svilches/666_Thesis/60 Presentation/SergioVilchesMScThesis.pptx

## Compact OCT scanner for a bimodal endoscopic probe

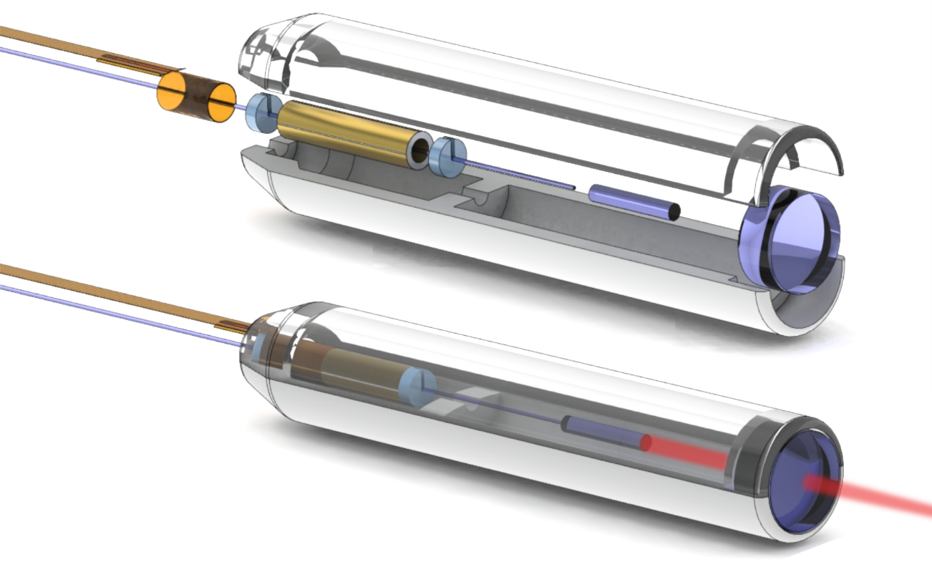
[picture p4: figure]

Sergio Vilches

Notes: Motivation: multimodal probe

## Slide 2

Sergio Vilches

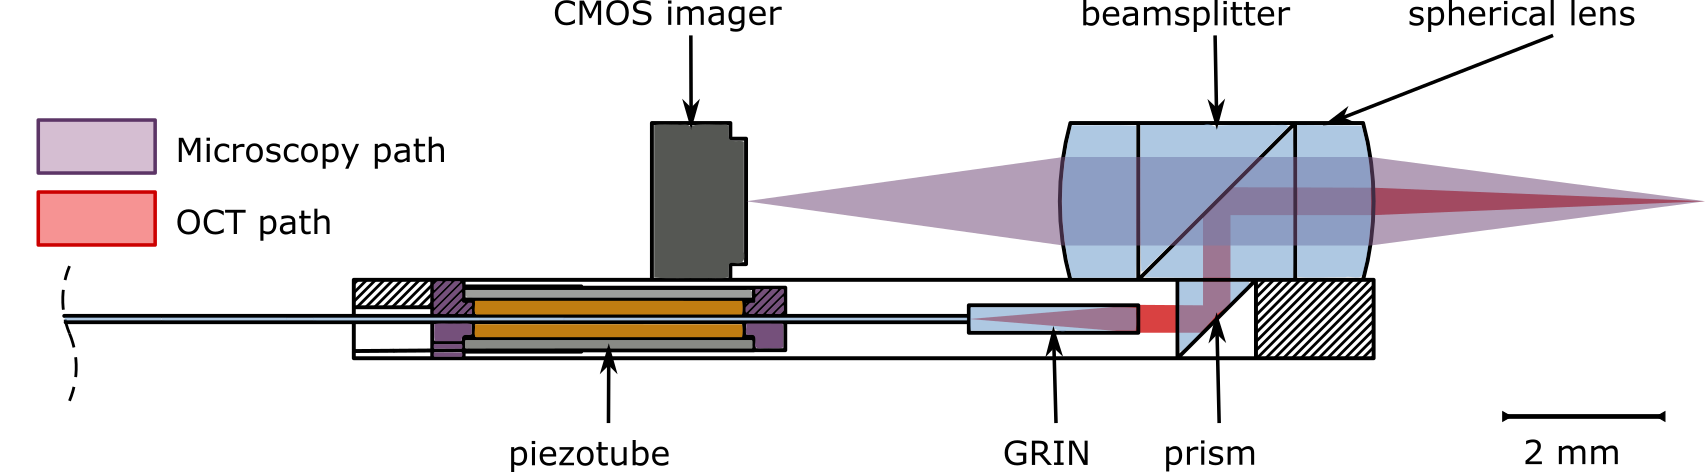
[picture p5: figure]

## Slide 3

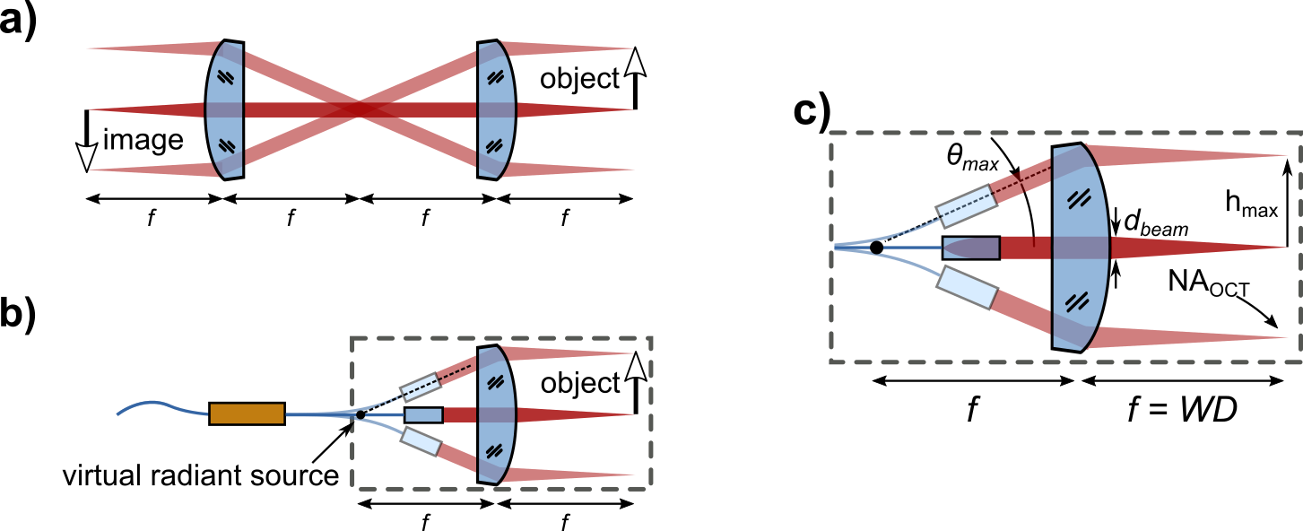
[picture p6: figure]

## Slide 4

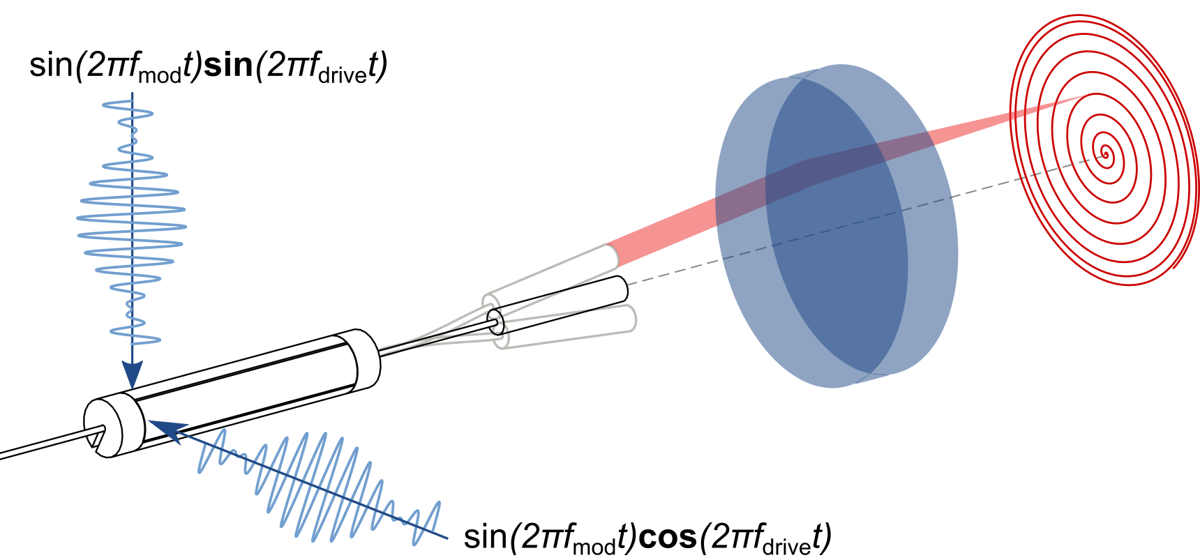
[picture p7: figure]

## Slide 5

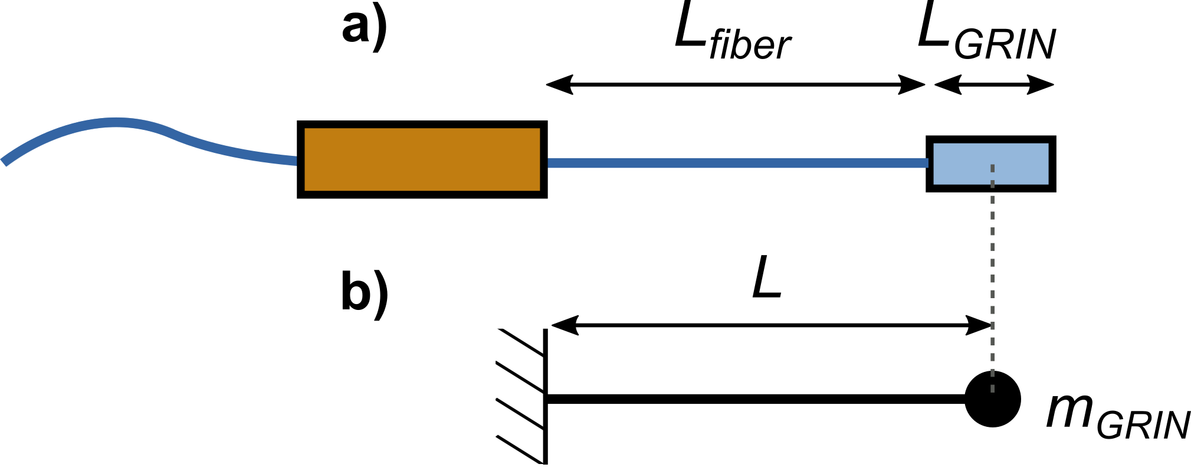
[picture p8: figure]
