svilches/666_Thesis/10 LaTeX/figures/20_Theory/Optical/SDOCT-Schema.pdf

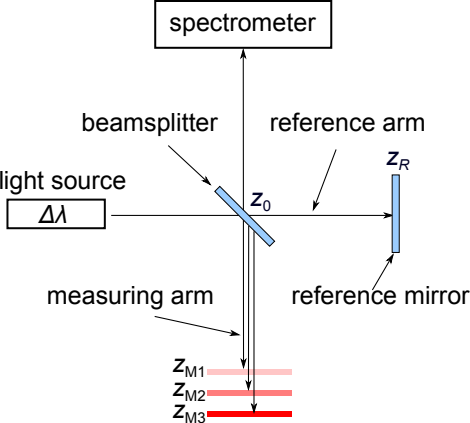
[picture p80: figure]
light source; beamsplitter; reference mirror; spectrometer; measuring arm; reference arm
