svilches/666_Thesis/10 LaTeX/figures/20_Theory/Optical/SSOCT-Schema.pdf

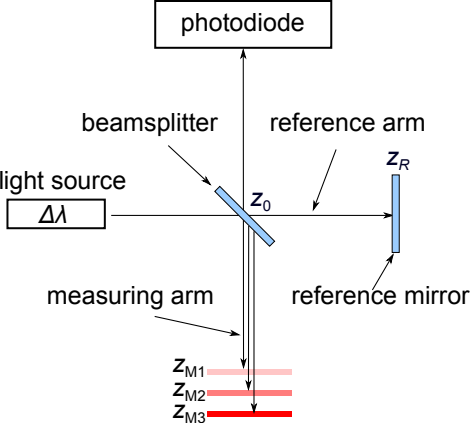
[picture p81: figure]
light source; beamsplitter; reference mirror; photodiode; measuring arm; reference arm
