svilches/666_Thesis/10 LaTeX/appendix/comsol.pdf

# COMSOL Simulation

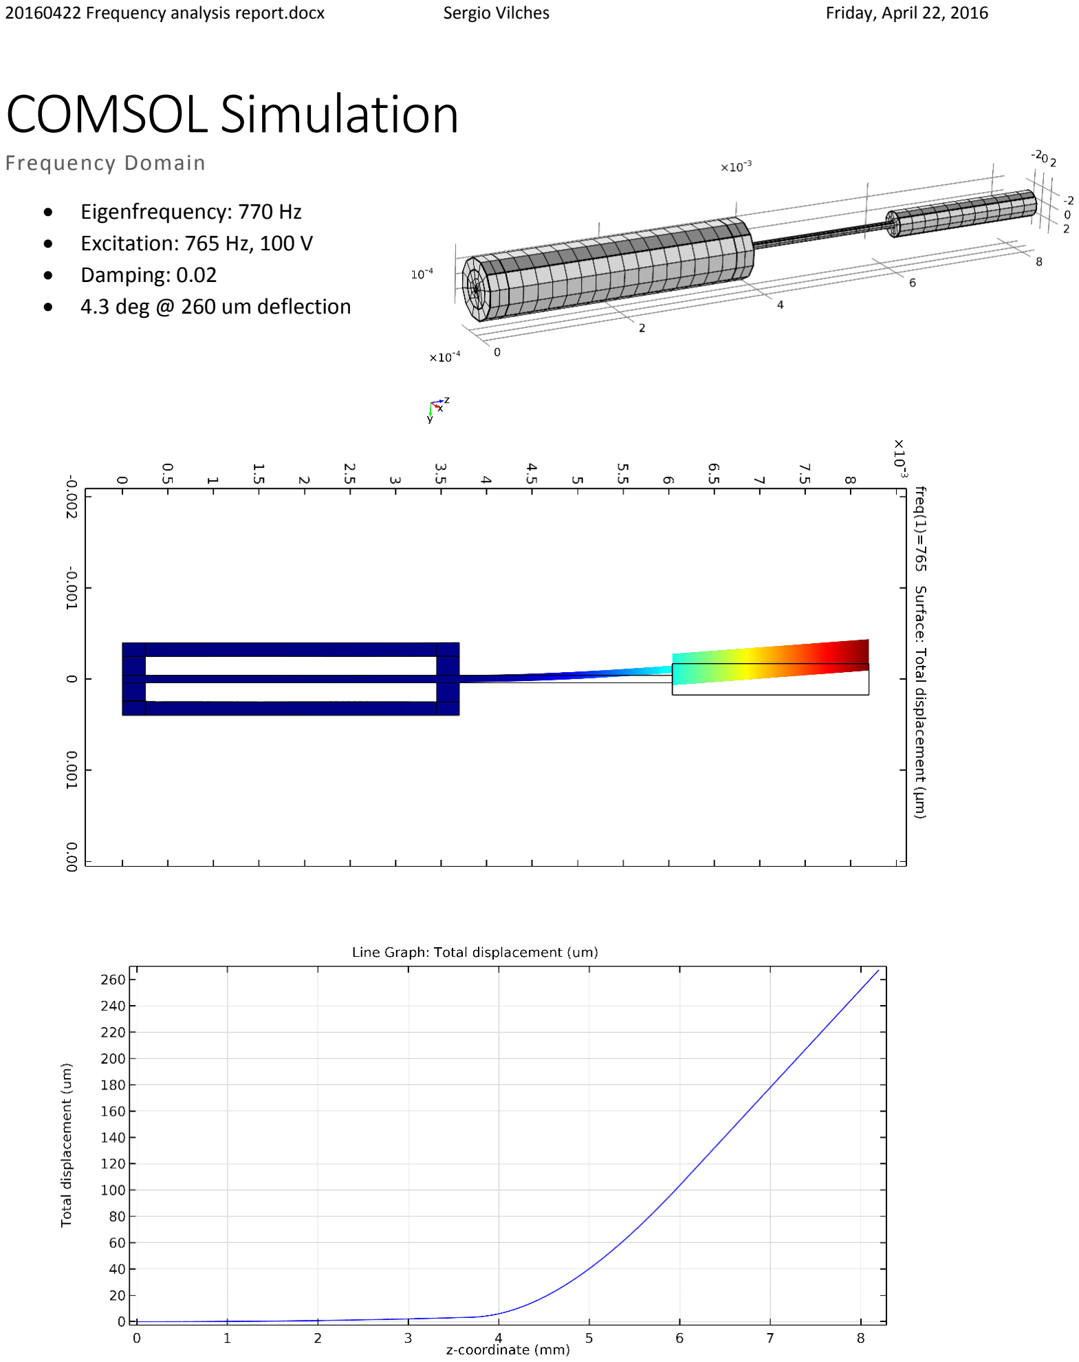
[picture p82: page 1]

20160422 Frequency analysis report.docx | Sergio Vilches | Friday, April 22, 2016

Frequency Domain

- Eigenfrequency: 770 Hz
- Excitation: 765 Hz, 100 V
- Damping: 0.02
- 4.3 deg @ 260 um deflection
