svilches/666_Thesis/10 LaTeX/appendix/holder.pdf

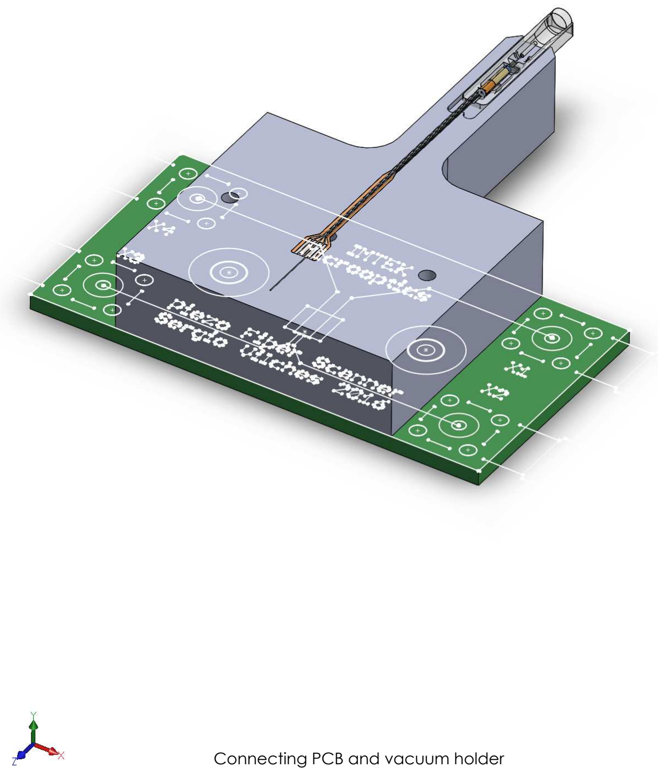
[picture p83: page 1]

Connecting PCB and vacuum holder
