svilches/666_Thesis/10 LaTeX/appendix/pztPhotos.pdf

2016603 PZT Tube Metrology.docx | Sergio Vilches | June 3, 2016

# PZT Tube Metrology

PI Ceramics, full sample

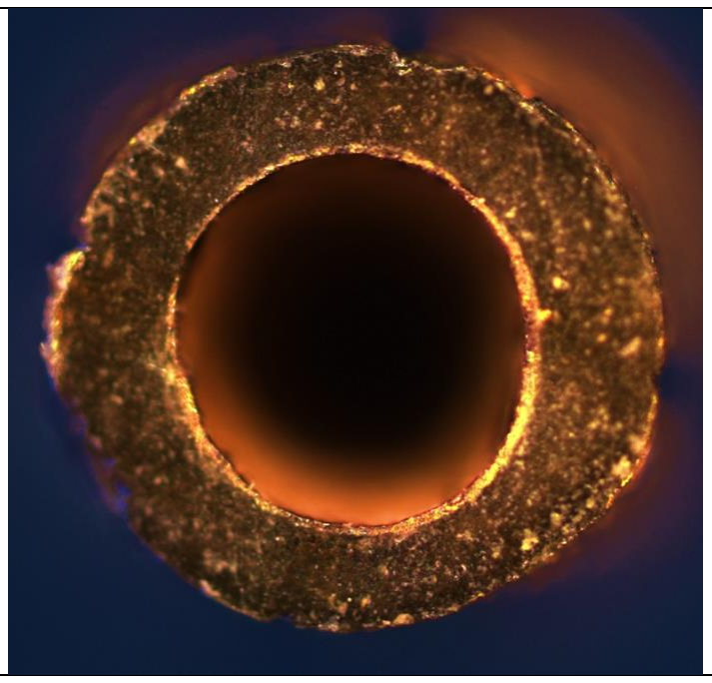
[picture p84: figure]
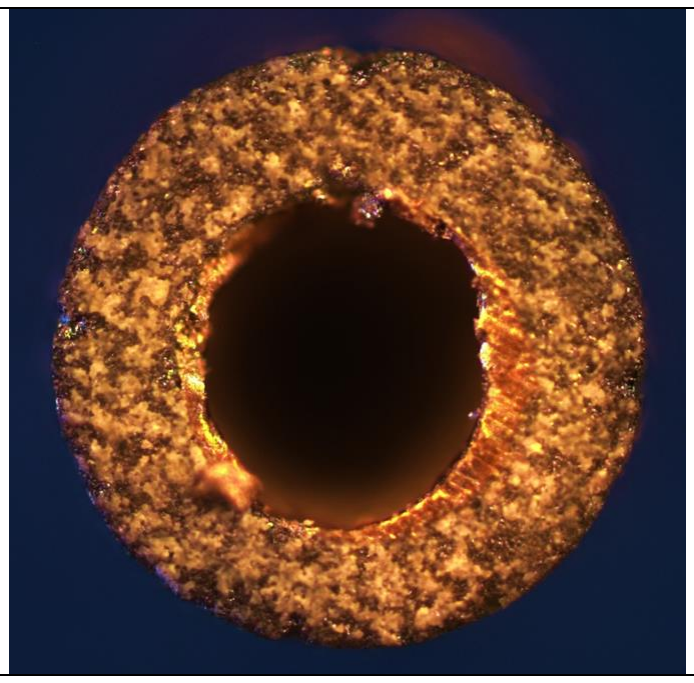
[picture p85: figure]

PZT1, Side A | PZT1, Side B

### Manufacturer Drawing

PZT #

Side A [um] | Side B [um]
L [mm]
| d | D | d | D
1 | 452 | 792 | 396 | 784 | 3,74
2 | 474 | 776 | 440 | 814 | 3,78
3 | 466 | 776 | 438 | 772 | 3,78
4 | 464 | 774 | 392 | 786 | 3,76
5 | 476 | 766 | 410 | 780 | 3,75
Min | 452 | 766 | 392 | 772 | 3,74
Average | 466 | 777 | 415 | 787 | 3,76
Max | 476 | 792 | 440 | 814 | 3,78
StdDev | 10 | 9 | 23 | 16 | 0,02

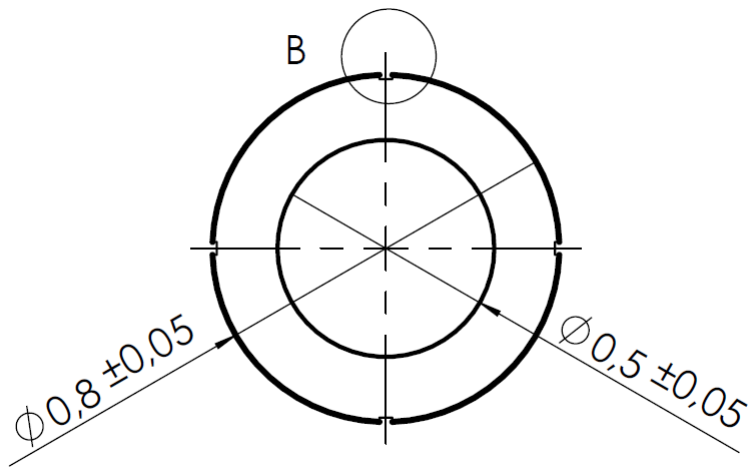
[picture p86: figure]
