svilches/666_Thesis/70 Paper/comparisonSeibel.xlsx

Parameter | Seibel, Lurie | Ours
Resonance frequency [Hz] | 2046 | 762
Output diameter of scanning engine [mm] | 1.07 | 0.91
Cantilever length [mm] | 6.8 | 4.5
Scanning engine length [mm] | 13.2 | 9
Total length [mm] | 24.6 | 15
fov [mm] | 1.1 | 1.2
ksampling @ 1 mm FOV [points/mm] | 15.6 | 41.3
dx @ center [um] | 10 | 48
dx @ 1 mm FOV [um] | 128 | 48
fps | 12.5 | 10
