svilches/666_Thesis/10 LaTeX/MScThesis Sergio Vilches.tex

% -*- encoding: UTF8 -*-
%
%%%%%%%%%%%%%%%%%%%%%%%%%%%%%%%%%%%%%%%%%%%%%%%%%%%%%%%%%%                                                                                                             %%
%%      Sergio Vilches Master Thesis 2017			  %%%%                                                                                                                                                       %%
%%%%%%%%%%%%%%%%%%%%%%%%%%%%%%%%%%%%%%%%%%%%%%%%%%%%%%%%%%

% NOMENCLATURE:
% beamsplitter
% backreflection
% multimodal
% single modality
% proximal = fiber side
% collimate
% beam path
% piezoelectric tube
% full field microscopy   (endomicroscopy = microscopy beam path)
% resonant fiber scanner 
% Fourier plane scanner
% 3D-printed housing
% SS-OCT

% Read the basic settings
%\input{document_parts/default_settings}
\input{parts/DefaultSettings}

%\renewcommand{\rmdefault}{phv} % Arial
%\renewcommand{\sfdefault}{phv} % Arial
%\renewcommand\refname{{\fontfamily{phv}\selectfont Publications}} 

%% List for splitting words
%\hyphenation{Donau-dampf-schiff-ka-pi-tän}

% Load other packages
\input{parts/PersonalSettings}                

\begin{document} 

%% First Part: Title, Professor,...
\input{parts/FirstPages}     

% Short English and German Abstracts
\input{parts/Abstracts}  

% Includes contents into bookmarks
\cleardoublepage\phantomsection\pdfbookmark{\contentsname}{toc}

% Print table of contents
\tableofcontents

% Load Term Declaration
\input{parts/Nomenclature} 

% *** Set a spreadsheet- and figure-list
          %\listoffigures
          %\listoftables       % the option liststotoc includes the spreadsheet- and figure-list in the TOC

%%%%%%%%%%%%%%%%%%%%%%%%%%%%%%%%%%%%%%%%%%%%%%%%%%%%%%%%%%%%%%%%%%%%%%%%%%%%%%%%%
%                                                                 Main document	                      																				
%%%%%%%%%%%%%%%%%%%%%%%%%%%%%%%%%%%%%%%%%%%%%%%%%%%%%%%%%%%%%%%%%%%%%%%%%%%%%%%%%

% Start of the main part
\mainmatter   

%% Load separate chapters (for faster compiling just uncomment chapters)

\input{chapters/10_Introduction}

\input{chapters/20_Theory}

\input{chapters/30_DesignSimulation}

\input{chapters/40_Fabrication}

\input{chapters/50_Measurements}

\input{chapters/60_Conclusion}

%%%%%%%%%%%%%%%%%%%%%%%%%%%%%%%%%%%%%%%%%%%%%%%%%%%%%%%%%%%%%%%%%%%%%%%%%%%%%%%%%
%                                                                 Appendix	                      																				
%%%%%%%%%%%%%%%%%%%%%%%%%%%%%%%%%%%%%%%%%%%%%%%%%%%%%%%%%%%%%%%%%%%%%%%%%%%%%%%%%

% *** Load Appendix
\appendix
\input{parts/Appendix}

%% Include Bibliography
\cleardoublepage\phantomsection\pdfbookmark{\bibname}{bib}

\bibliographystyle{ieeetr}
\bibliography{refs} %ieeetr

% Thanksgiving
\input{parts/NoteOfThanks}

\end{document}

%%% You're done! %%%%%%%%%%%
