svilches/666_Thesis/20 Templates/Draft_Bachelor-Masterthesis_LATEX_english/chapters/Theory.tex

% -*- encoding: UTF8 -*-
%%*****************************************************************************
%%									                    	Theoretical Basics								 
%%*****************************************************************************
%
%
\chapter{Theory}
\label{Ch:Theory}	
%
%%%%%%%%%%%%%%%%%%%%%%%%%%%%%%%%%%%%%%%%%%%%%%%%%%%%%%%%%%%%%%%%%%%%%%%%%%%%%%%%%%
%
%---------------------------------Introduction----------------------------------
Within this Chapter the most important optical basics will be discussed...
%

%%%%%%%%%%%%%%%%%%%%%%%%%%%%%%%%%%%%%%%%%%%%%%%%%%%%%%%%%%%%%%%%%%%%%%%%%%%%%%%%%%
%
\section{Optics}
%
%
%%%%%%%%%%%%%%%%%%%%%%%%%%%%%%%%%%%%%%%%%%%%%%%%%%%%%%%%%%%%%%%%%%%%%%%%%%%%%%%%%%
%
%-------------------------Optical Devices-----------------------------
\subsection{Optical Devices}

%
For the detection of the light intensity ...
