svilches/666_Thesis/10 LaTeX/figures/30_DesignSimulation/Optical/backreflection.pdf

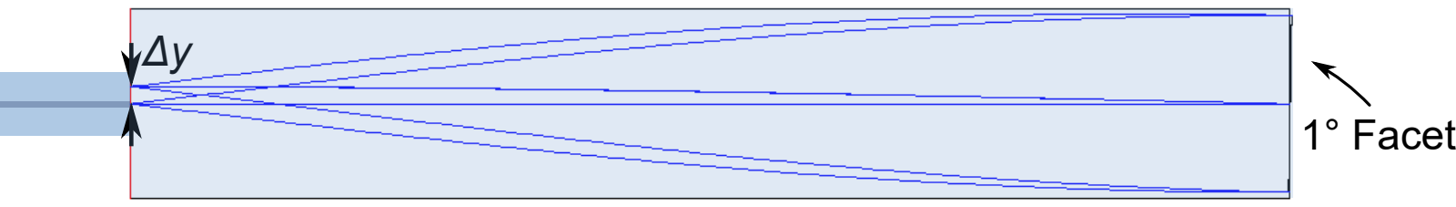
[picture p88: page 1]

Δ

y

1° Facet
