svilches/666_Thesis/10 LaTeX/figures/30_DesignSimulation/Mechanical/fres.pdf

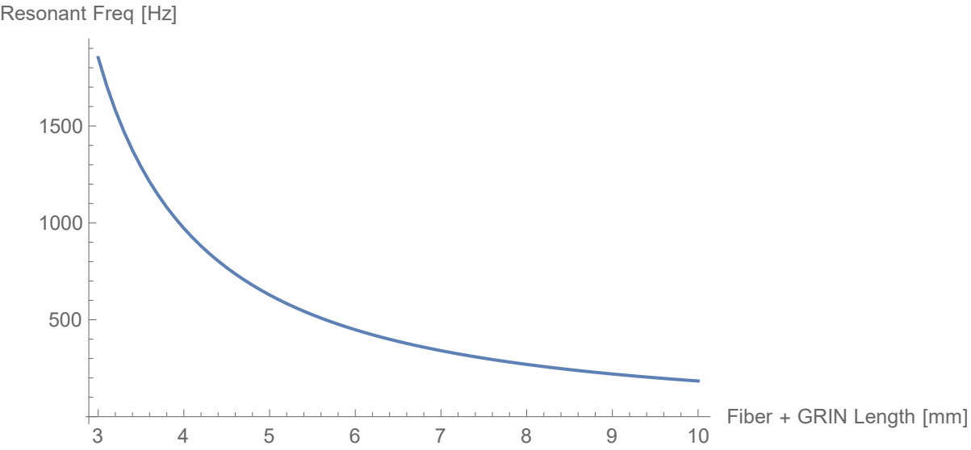
[picture p89: figure]
Fiber + GRIN Length [mm]; Resonant Freq [Hz]
