svilches/666_Thesis/10 LaTeX/figures/30_DesignSimulation/Overview/BimodalBenchDoubleLens.pdf

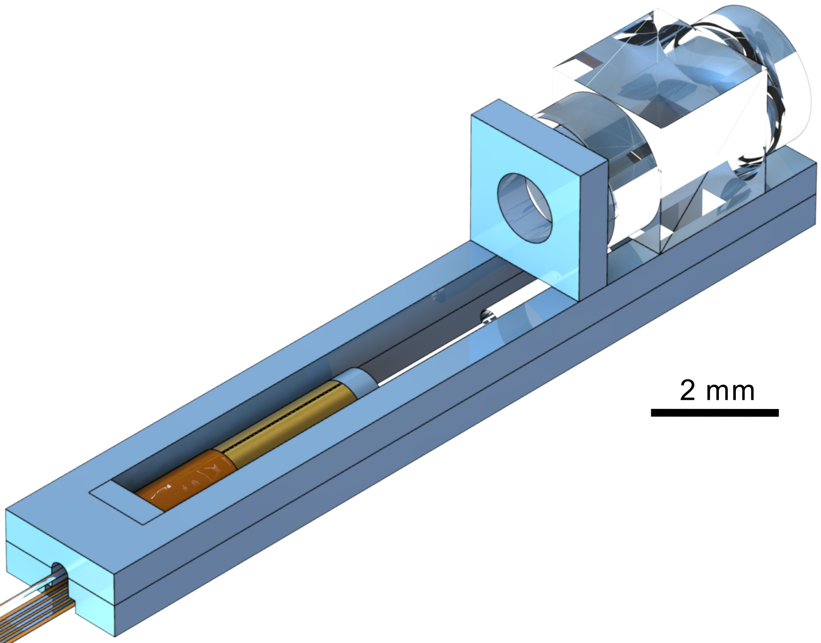
[picture p90: page 1]
