svilches/666_Thesis/10 LaTeX/figures/30_DesignSimulation/Optical/beamsplitter3D.pdf

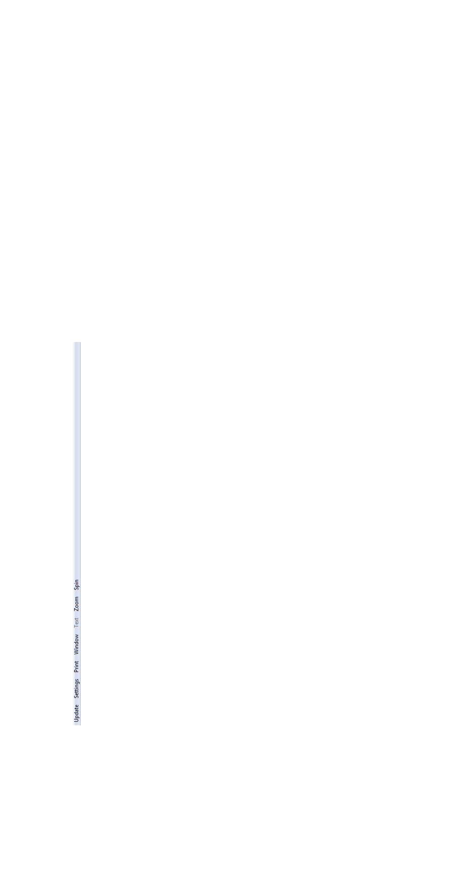
[picture p91: page 1]
