svilches/666_Thesis/10 LaTeX/figures/20_Theory/Optical/imaging/GaussianMTF.pdf

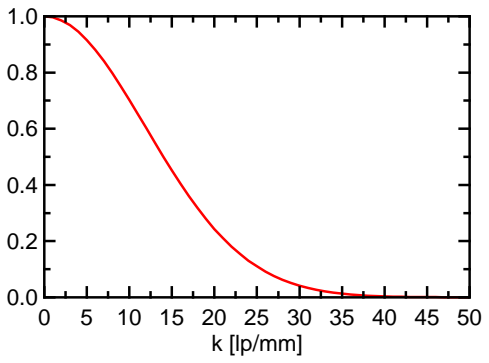
[picture p92: figure]

### MTFcore
