svilches/666_Thesis/10 LaTeX/figures/20_Theory/Optical/imaging/GaussianPSF.pdf

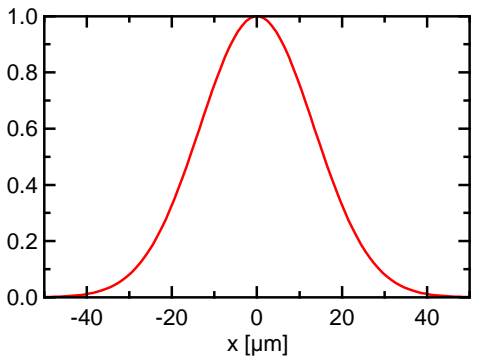
[picture p93: figure]

### PSFcore
