svilches/666_Thesis/10 LaTeX/figures/20_Theory/Optical/imaging/MTFcomplete.pdf

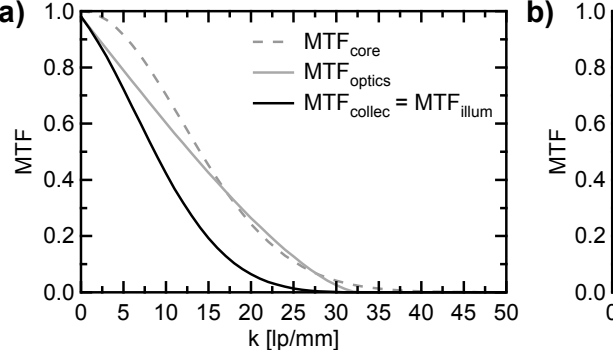
[picture p94: figure]
MTF; MTFcore; MTFoptics; MTFcollec = MTFillum
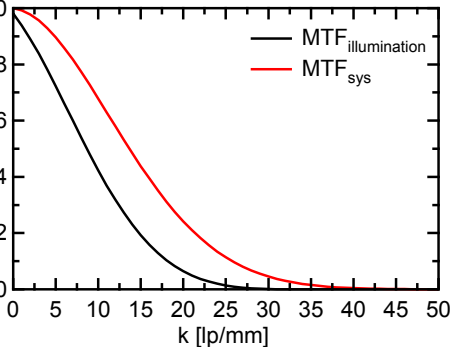
[picture p95: figure]
MTFillumination MTFsys
