svilches/666_Thesis/10 LaTeX/figures/20_Theory/Optical/imaging/MTFcoreoptics.pdf

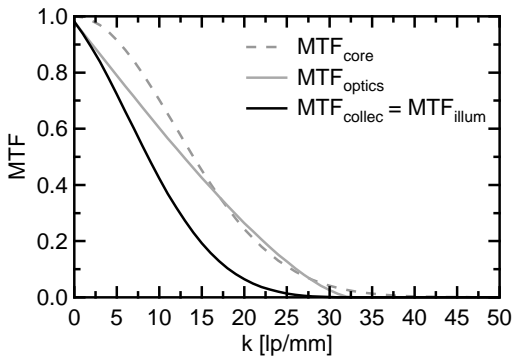
[picture p96: figure]
MTF; MTFcore; MTFoptics; MTFcollec = MTFillum
