svilches/666_Thesis/10 LaTeX/figures/20_Theory/Optical/imaging/MTFsystem.pdf

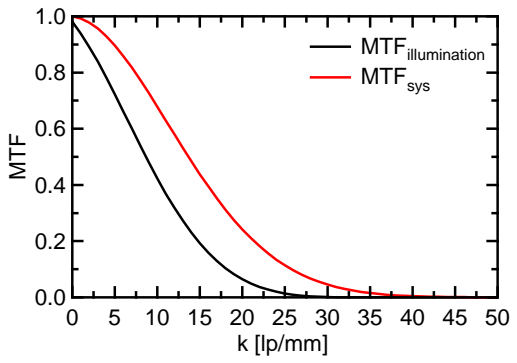
[picture p97: figure]
MTF; MTFillumination MTFsys
