svilches/666_Thesis/10 LaTeX/figures/20_Theory/Optical/imaging/PSF_MTF.pdf

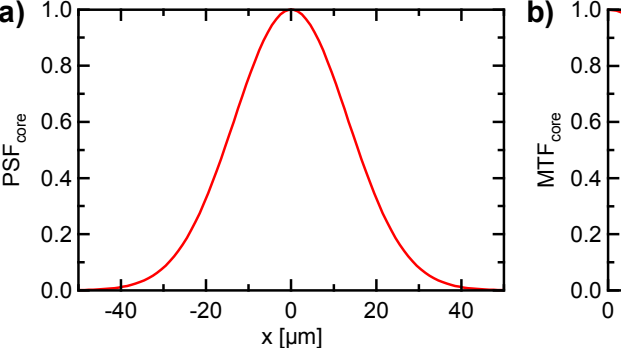
[picture p98: figure]
PSFcore; MTFcore
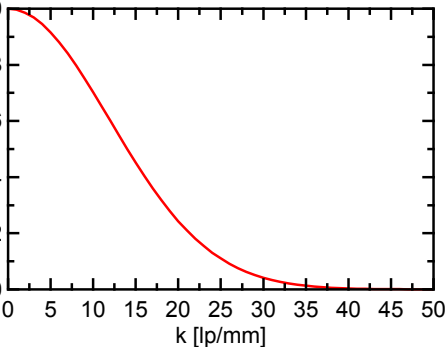
[picture p99: figure]
