svilches/666_Thesis/10 LaTeX/appendix/KOH.pdf

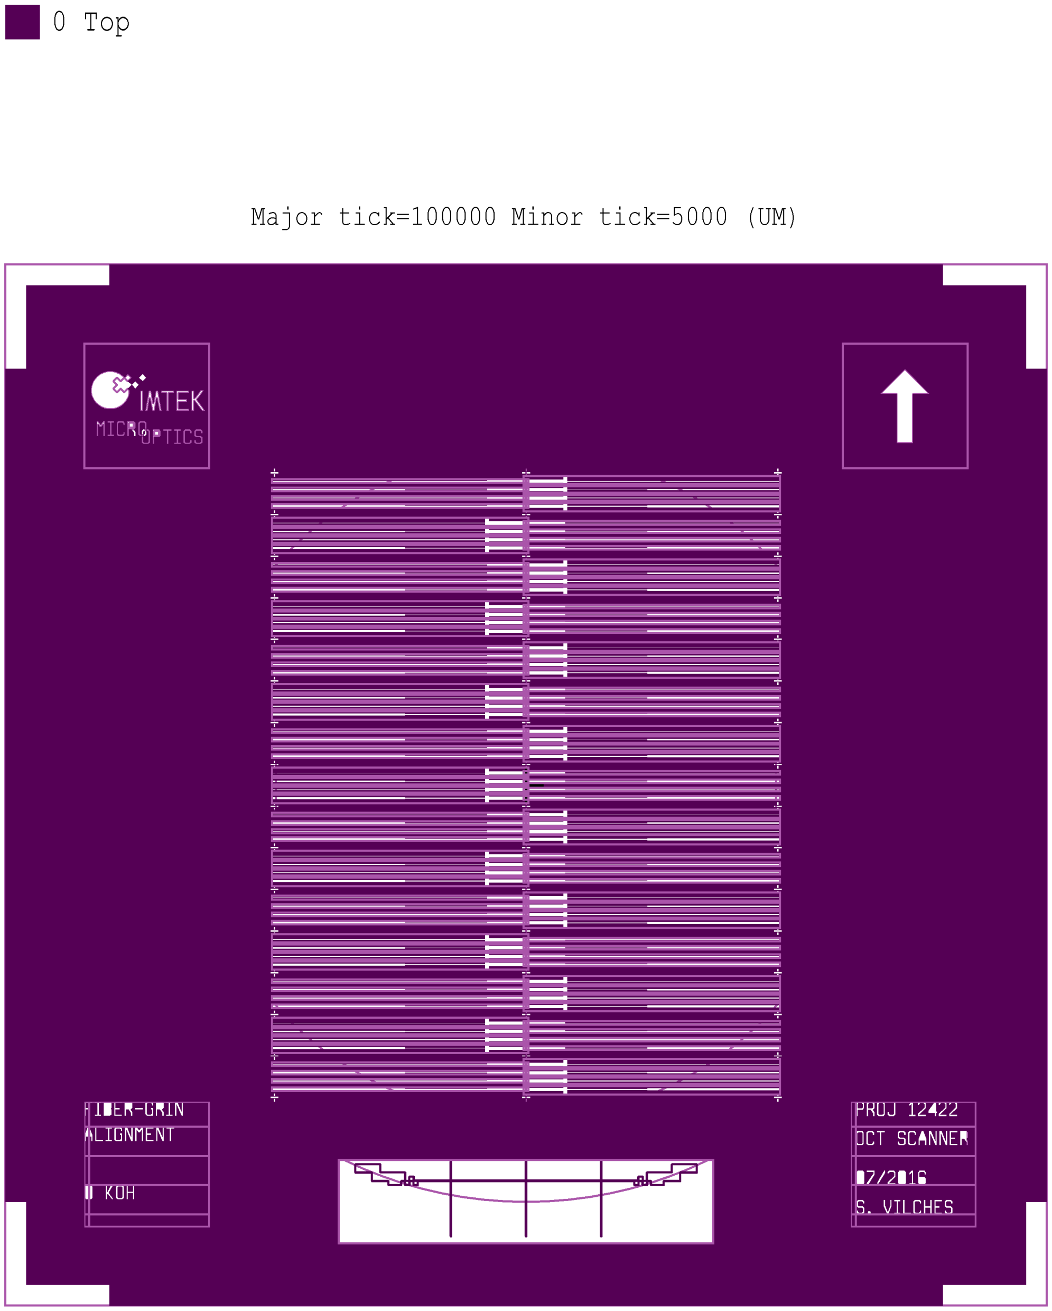
[picture p100: page 1]
