svilches/666_Thesis/10 LaTeX/appendix/piCuffs.pdf

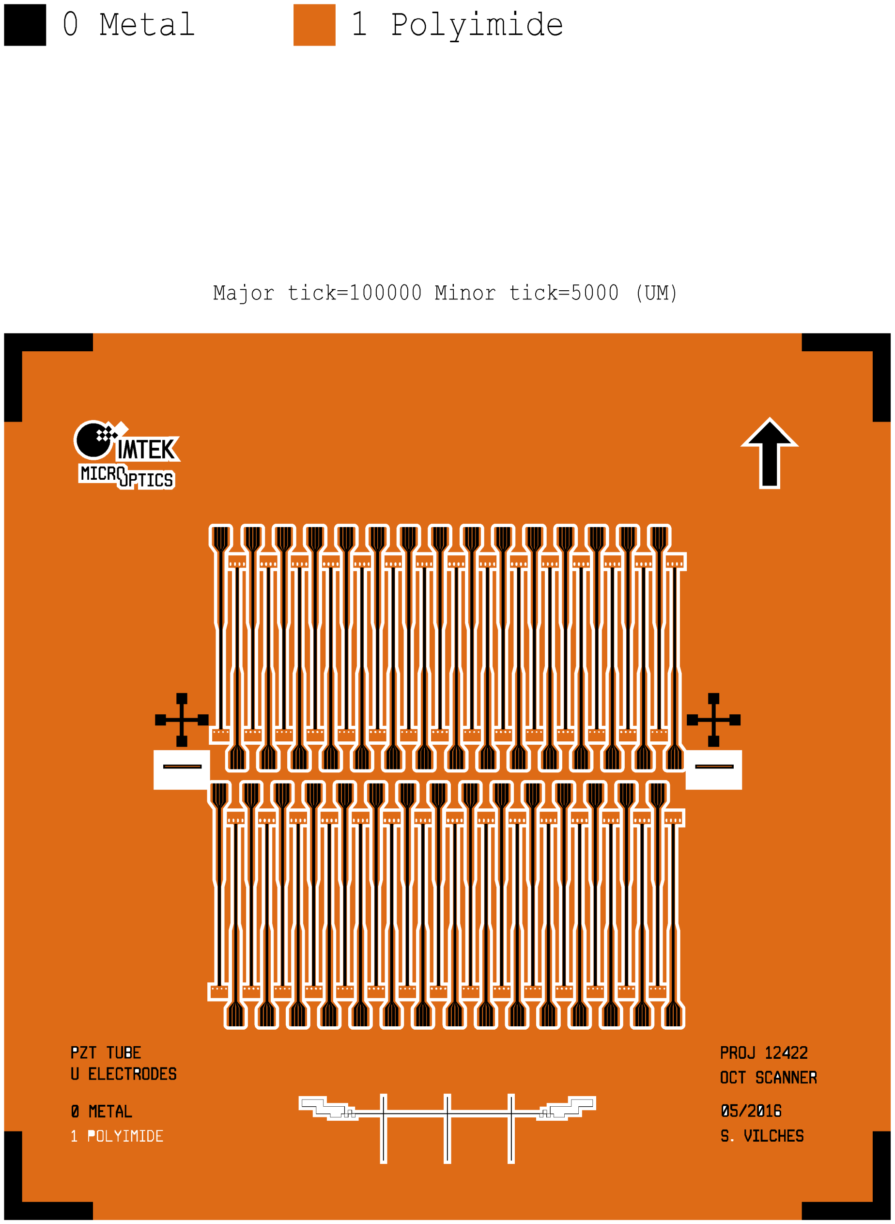
[picture p101: page 1]
