svilches/666_Thesis/10 LaTeX/figures/30_DesignSimulation/Mechanical/Vsweep.xlsx

x | 25V | 50V | 75V | 50V/2 | 75V/3
0 | 0 | 0 | 0 | 0 | 0
0.0625 | 0.0043641 | 0.0087282 | 0.013092 | 0.0043641 | 0.004364
0.0625 | 0.0043633 | 0.0087266 | 0.01309 | 0.0043633 | 0.004363333333
0.0625 | 0.0014276 | 0.0028552 | 0.0042828 | 0.0014276 | 0.0014276
0.0625 | 0.0014359 | 0.0028719 | 0.0043078 | 0.00143595 | 0.001435933333
0.0625 | 0.0014361 | 0.0028721 | 0.0043082 | 0.00143605 | 0.001436066667
0.0625 | 0.0014467 | 0.0028933 | 0.00434 | 0.00144665 | 0.001446666667
0.0625 | 0.0043577 | 0.0087155 | 0.013073 | 0.00435775 | 0.004357666667
0.0625 | 0.0043448 | 0.0086897 | 0.013035 | 0.00434485 | 0.004345
0.0625 | 0.0094404 | 0.018881 | 0.028321 | 0.0094405 | 0.009440333333
0.0625 | 0.0094272 | 0.018854 | 0.028282 | 0.009427 | 0.009427333333
0.0625 | 0.0094215 | 0.018843 | 0.028264 | 0.0094215 | 0.009421333333
0.0625 | 0.0094256 | 0.018851 | 0.028277 | 0.0094255 | 0.009425666667
0.125 | 0.0086097 | 0.017219 | 0.025829 | 0.0086095 | 0.008609666667
0.125 | 0.0085872 | 0.017174 | 0.025762 | 0.008587 | 0.008587333333
0.125 | 0.0016954 | 0.0033909 | 0.0050863 | 0.00169545 | 0.001695433333
0.125 | 0.0017054 | 0.0034108 | 0.0051162 | 0.0017054 | 0.0017054
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
