svilches/666_Thesis/10 LaTeX/appendix/assyPhotos/04.JPG

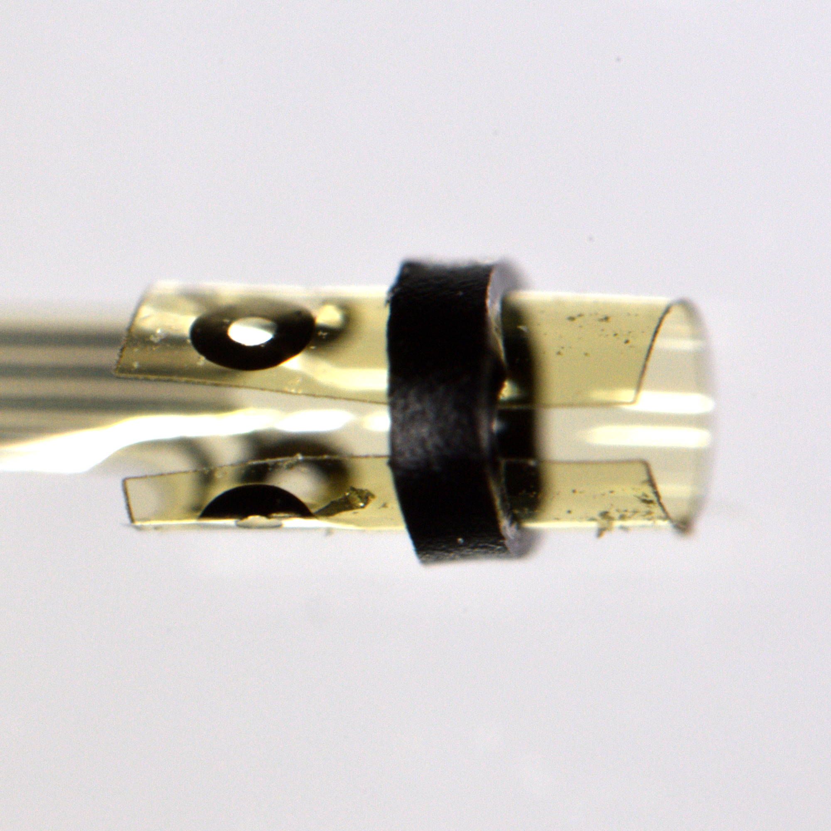
10 LaTeX/appendix/assyPhotos/04.JPG
