svilches/666_Thesis/10 LaTeX/appendix/assyPhotos/05.JPG

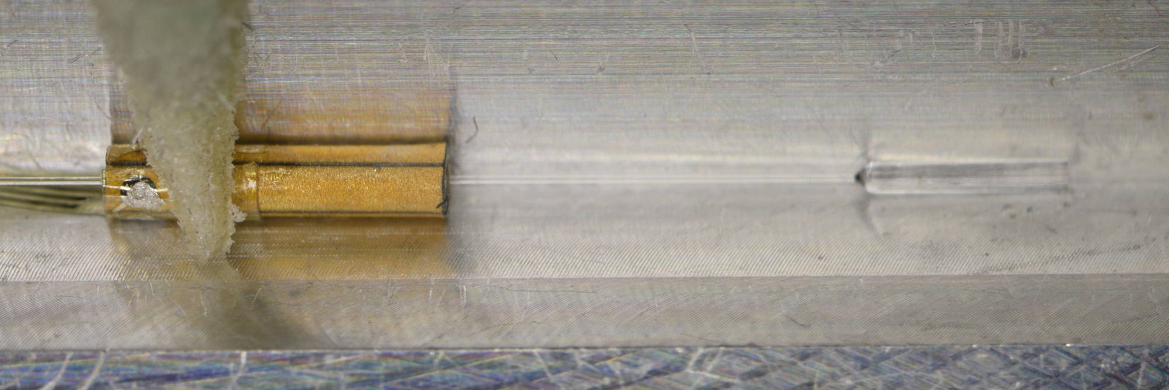
10 LaTeX/appendix/assyPhotos/05.JPG
