svilches/666_Thesis/10 LaTeX/appendix/assyPhotos/06.JPG

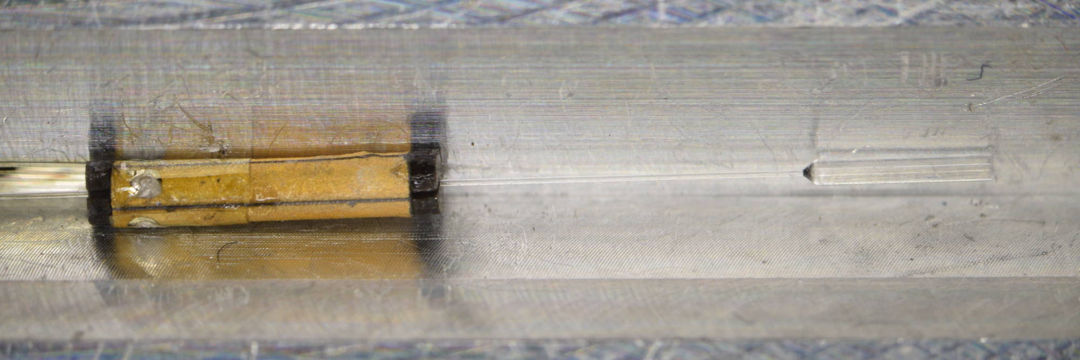
10 LaTeX/appendix/assyPhotos/06.JPG
