svilches/666_Thesis/10 LaTeX/appendix/assyPhotos/10.JPG

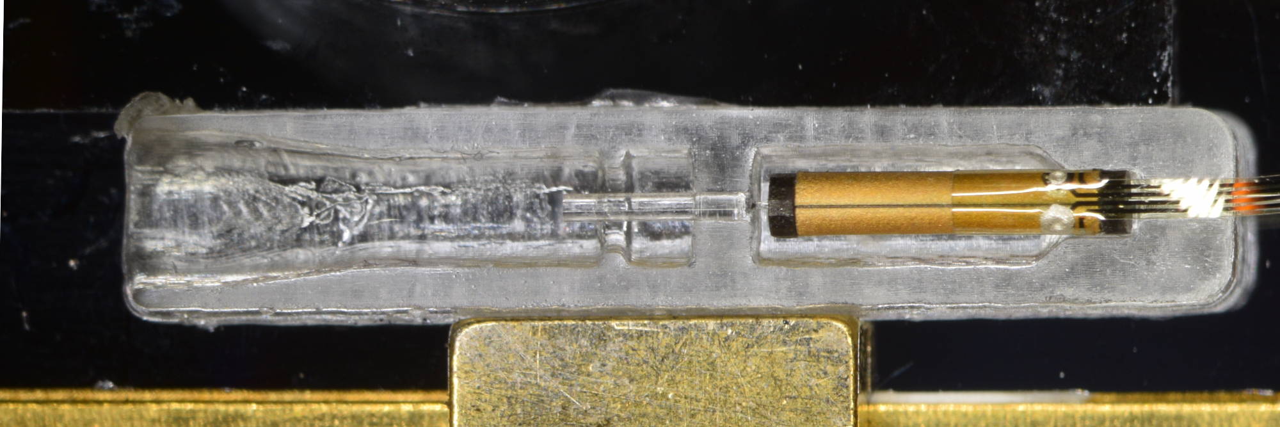
10 LaTeX/appendix/assyPhotos/10.JPG
