svilches/666_Thesis/10 LaTeX/appendix/assyPhotos/15.JPG

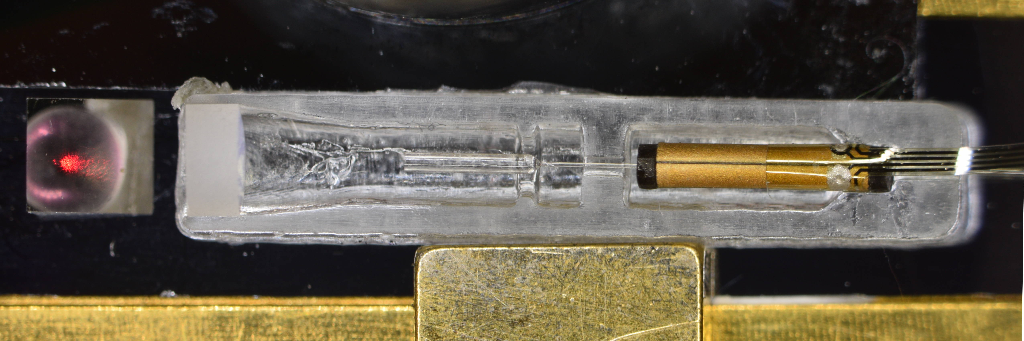
10 LaTeX/appendix/assyPhotos/15.JPG
