svilches/666_Thesis/10 LaTeX/figures/10_Introduction/OCTexample.jpg

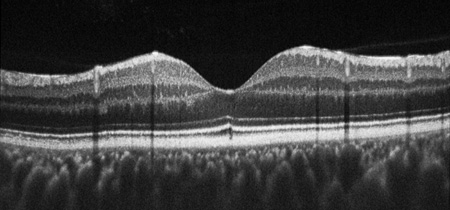
10 LaTeX/figures/10_Introduction/OCTexample.jpg
