svilches/666_Thesis/10 LaTeX/figures/20_Theory/Mechanical/piezotube.JPG

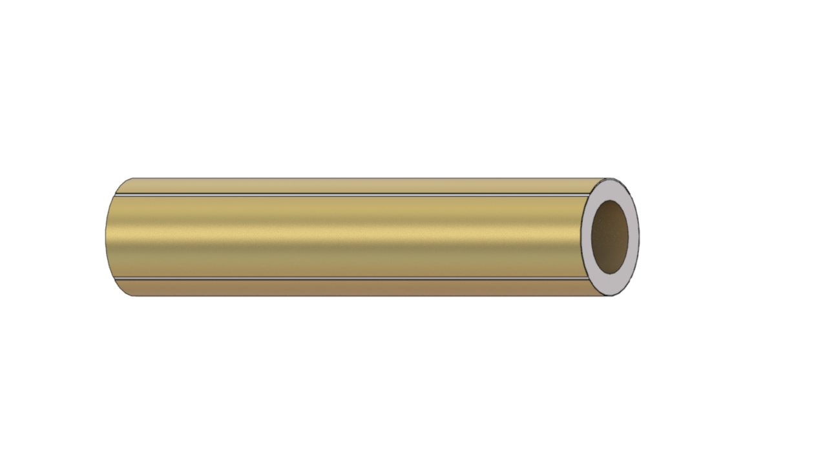
10 LaTeX/figures/20_Theory/Mechanical/piezotube.JPG
