svilches/666_Thesis/10 LaTeX/figures/30_DesignSimulation/Mechanical/deflection.png

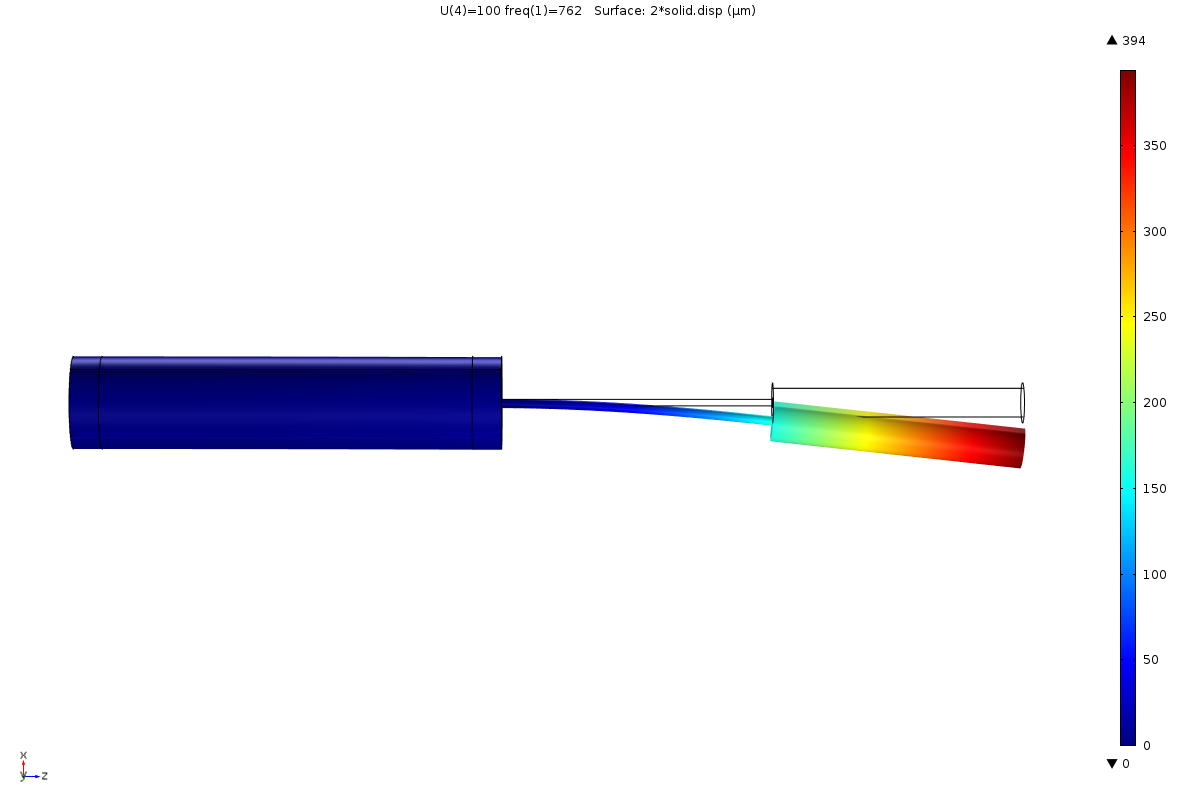
10 LaTeX/figures/30_DesignSimulation/Mechanical/deflection.png
