svilches/666_Thesis/10 LaTeX/figures/30_DesignSimulation/Mechanical/field.png

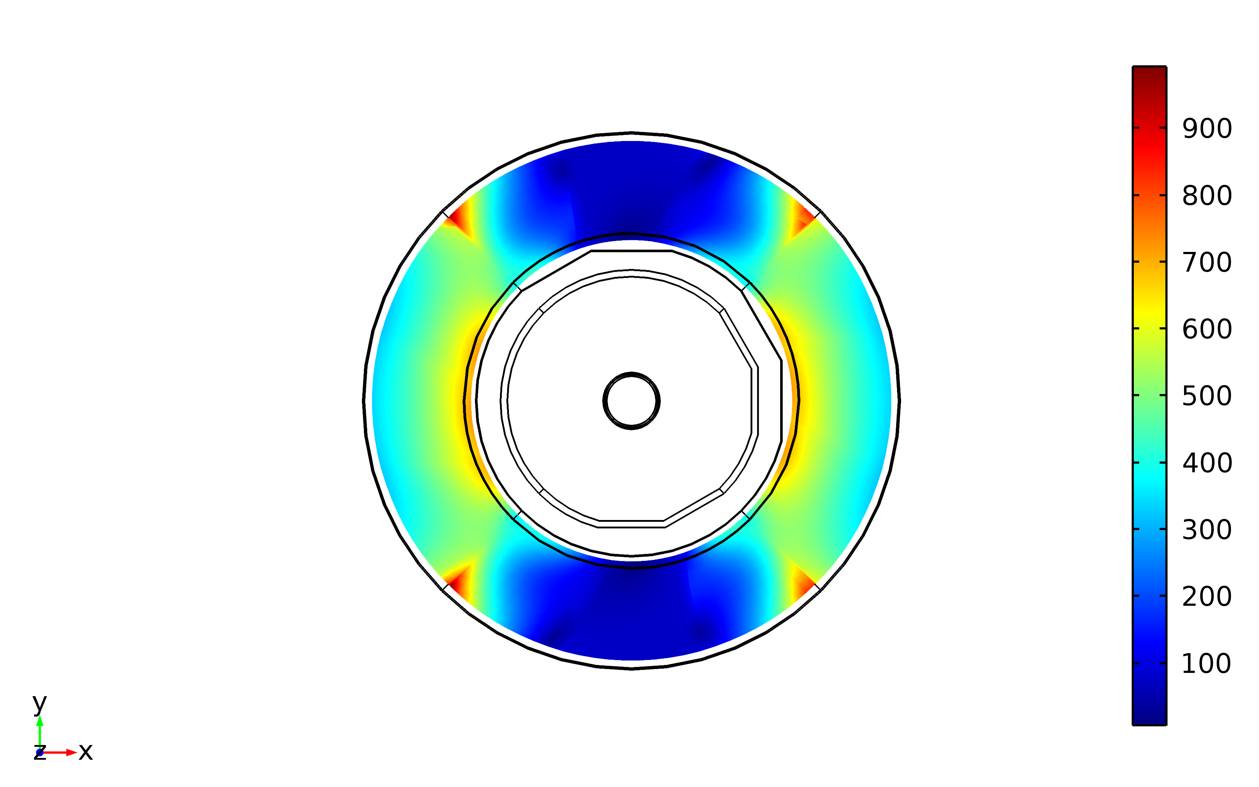
10 LaTeX/figures/30_DesignSimulation/Mechanical/field.png
