svilches/666_Thesis/10 LaTeX/figures/30_DesignSimulation/Mechanical/gravity 0.58um.png

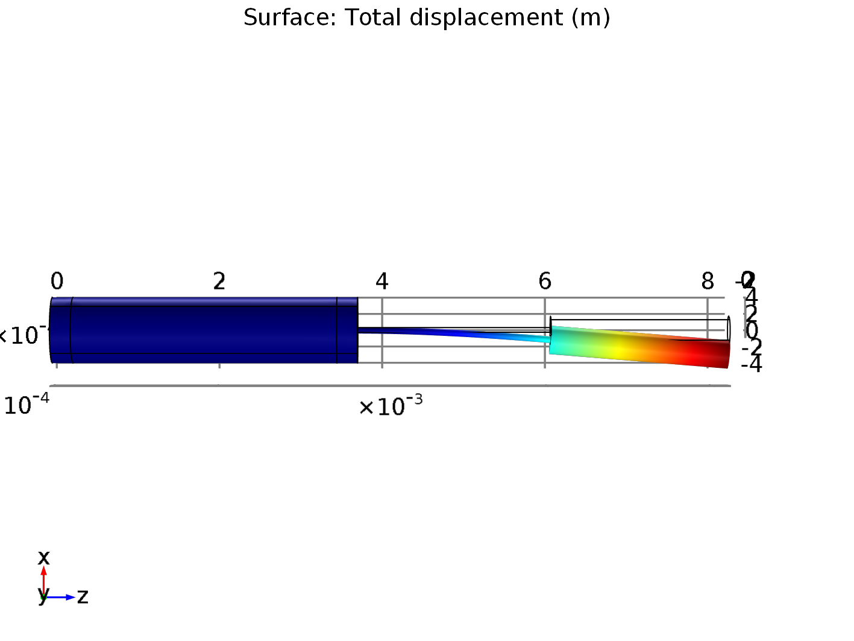
10 LaTeX/figures/30_DesignSimulation/Mechanical/gravity 0.58um.png
