svilches/666_Thesis/10 LaTeX/figures/30_DesignSimulation/Mechanical/vsweep.PNG

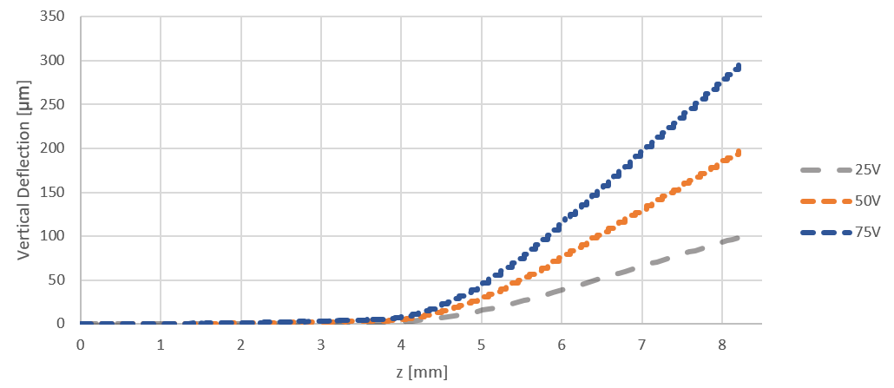
10 LaTeX/figures/30_DesignSimulation/Mechanical/vsweep.PNG
