svilches/666_Thesis/10 LaTeX/figures/30_DesignSimulation/Optical/beamsplitter3D.png

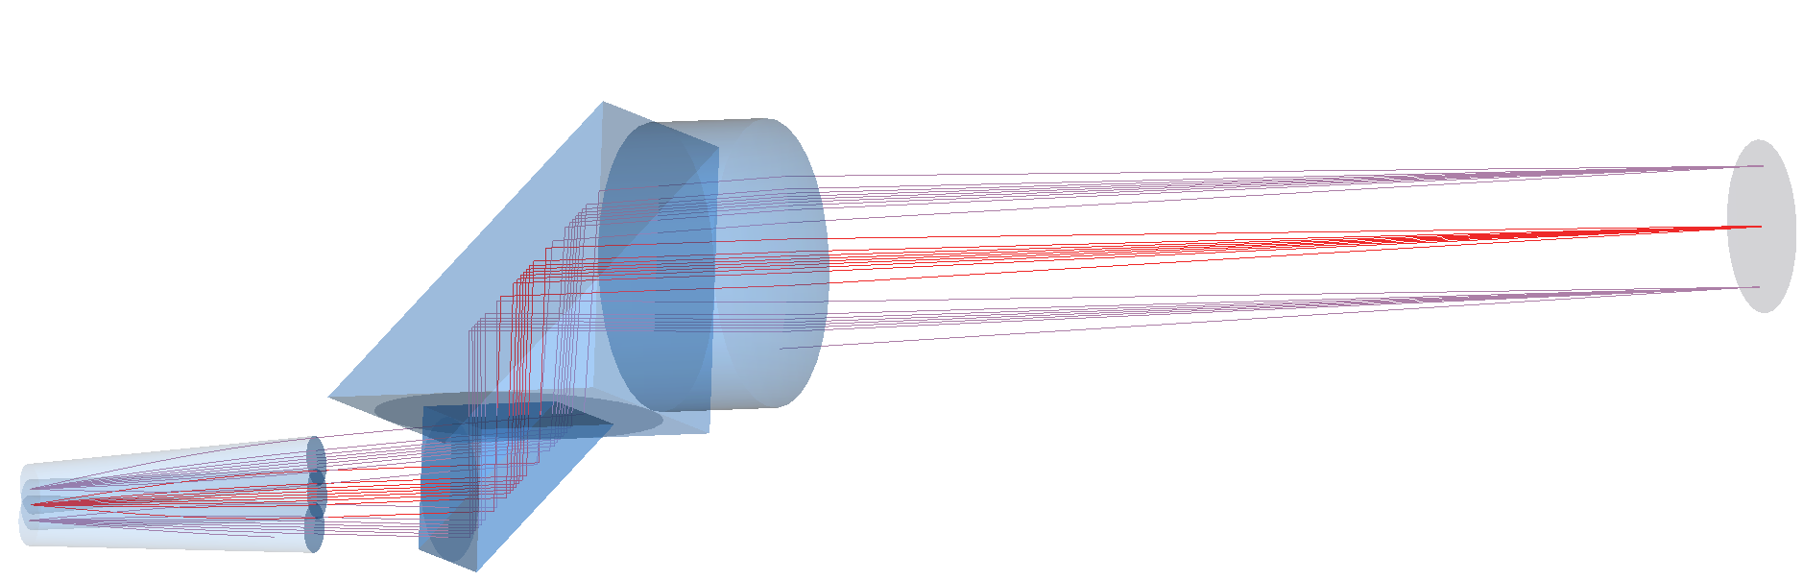
10 LaTeX/figures/30_DesignSimulation/Optical/beamsplitter3D.png
