svilches/666_Thesis/10 LaTeX/figures/30_DesignSimulation/Optical/beamsplitterMTF.png

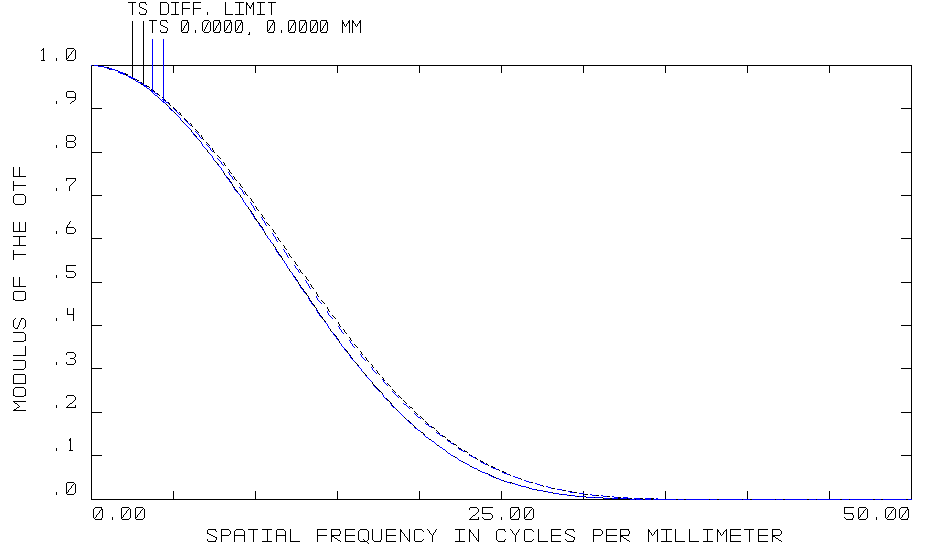
10 LaTeX/figures/30_DesignSimulation/Optical/beamsplitterMTF.png
