svilches/666_Thesis/10 LaTeX/figures/30_DesignSimulation/Optical/single3D.PNG

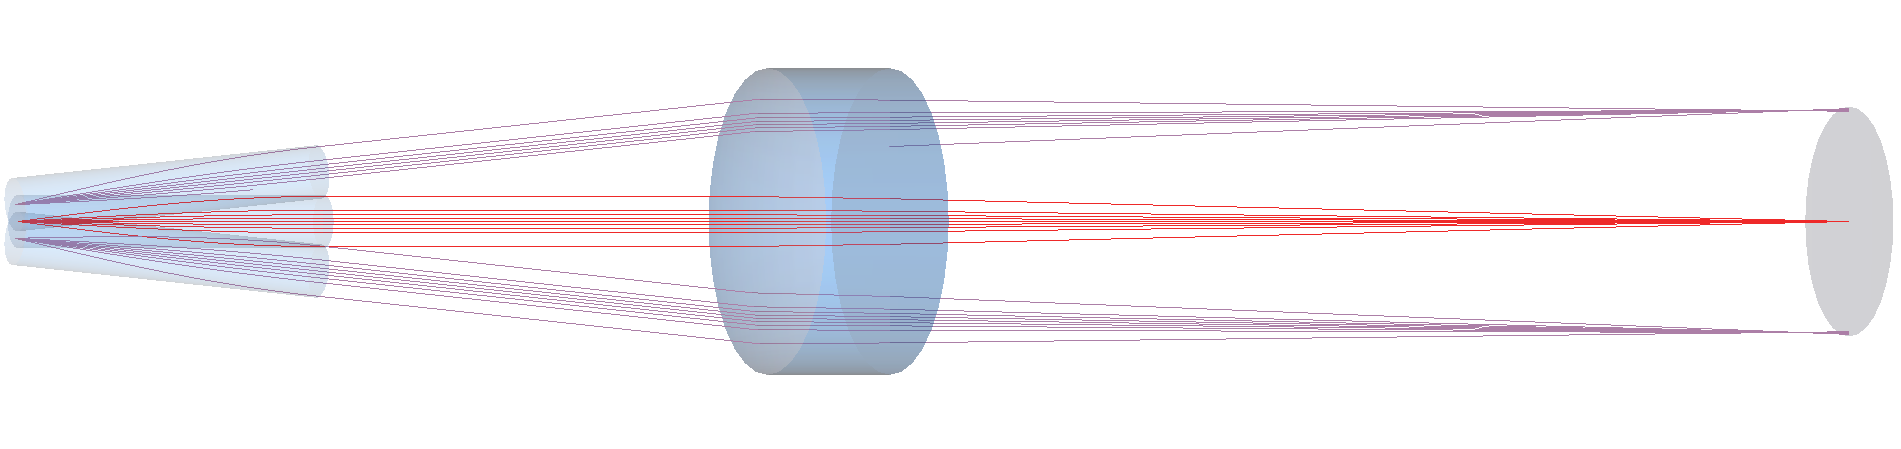
10 LaTeX/figures/30_DesignSimulation/Optical/single3D.PNG
