svilches/666_Thesis/10 LaTeX/figures/40_Fabrication/overview.JPG

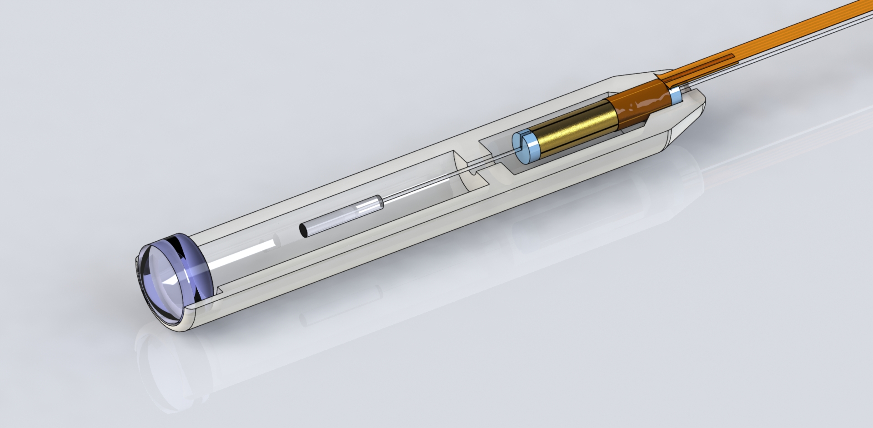
10 LaTeX/figures/40_Fabrication/overview.JPG
