svilches/666_Thesis/10 LaTeX/figures/40_Fabrication/overview.PNG

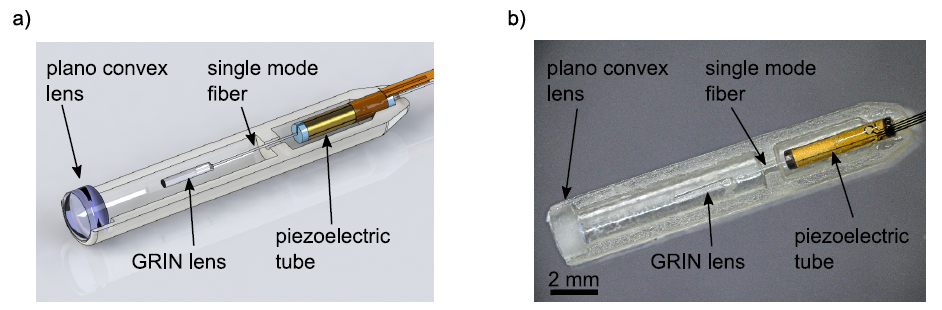
10 LaTeX/figures/40_Fabrication/overview.PNG
