svilches/666_Thesis/10 LaTeX/figures/g168524.png

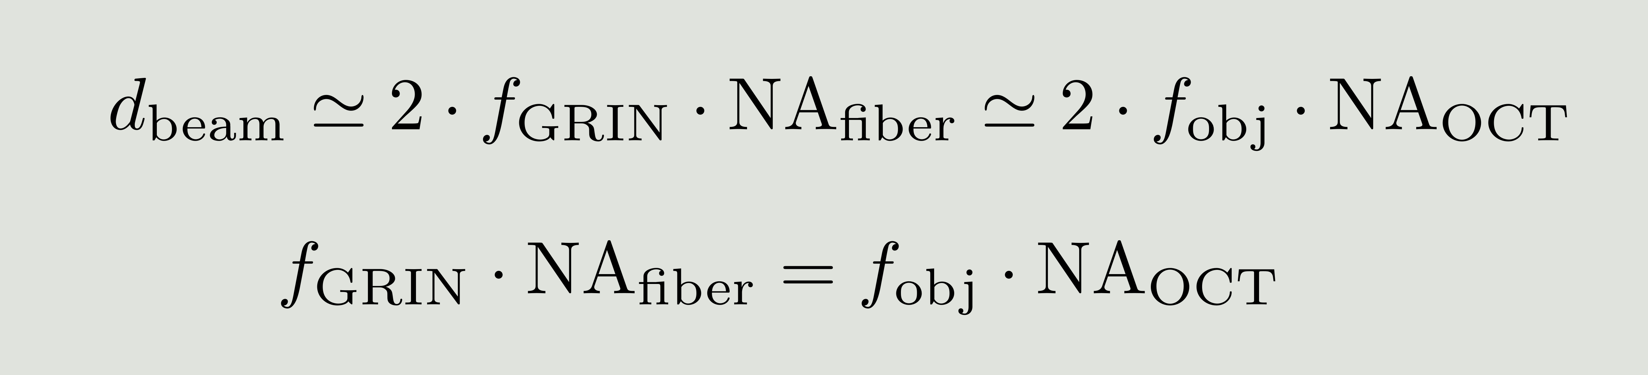
10 LaTeX/figures/g168524.png
