svilches/666_Thesis/20 Templates/Draft_Bachelor-Masterthesis_LATEX_english/figures/Kap_Theorie/.picasaoriginals/kapillarkraft.jpg

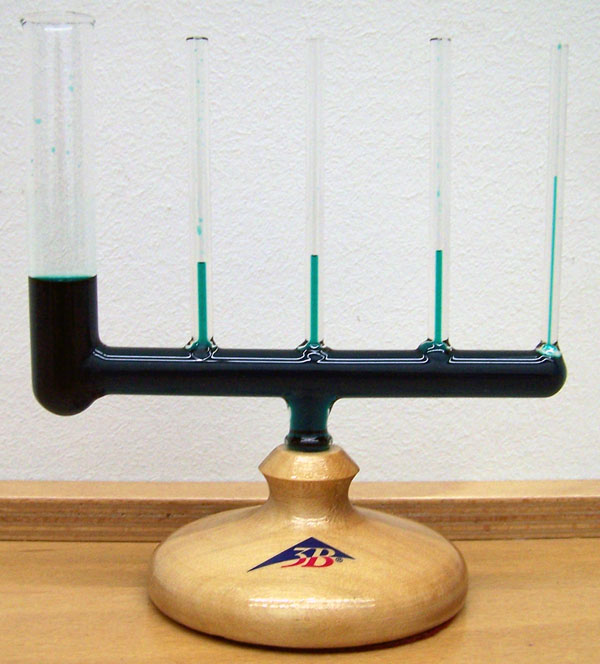
20 Templates/Draft_Bachelor-Masterthesis_LATEX_english/figures/Kap_Theorie/.picasaoriginals/kapillarkraft.jpg
