svilches/666_Thesis/60 Presentation/images/g12.png

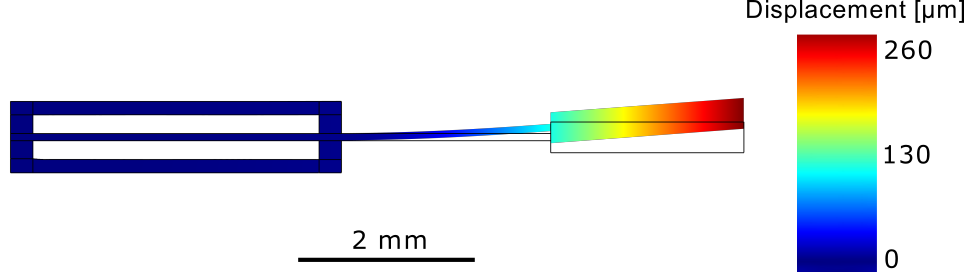
60 Presentation/images/g12.png
