svilches/666_Thesis/60 Presentation/images/g4619.png

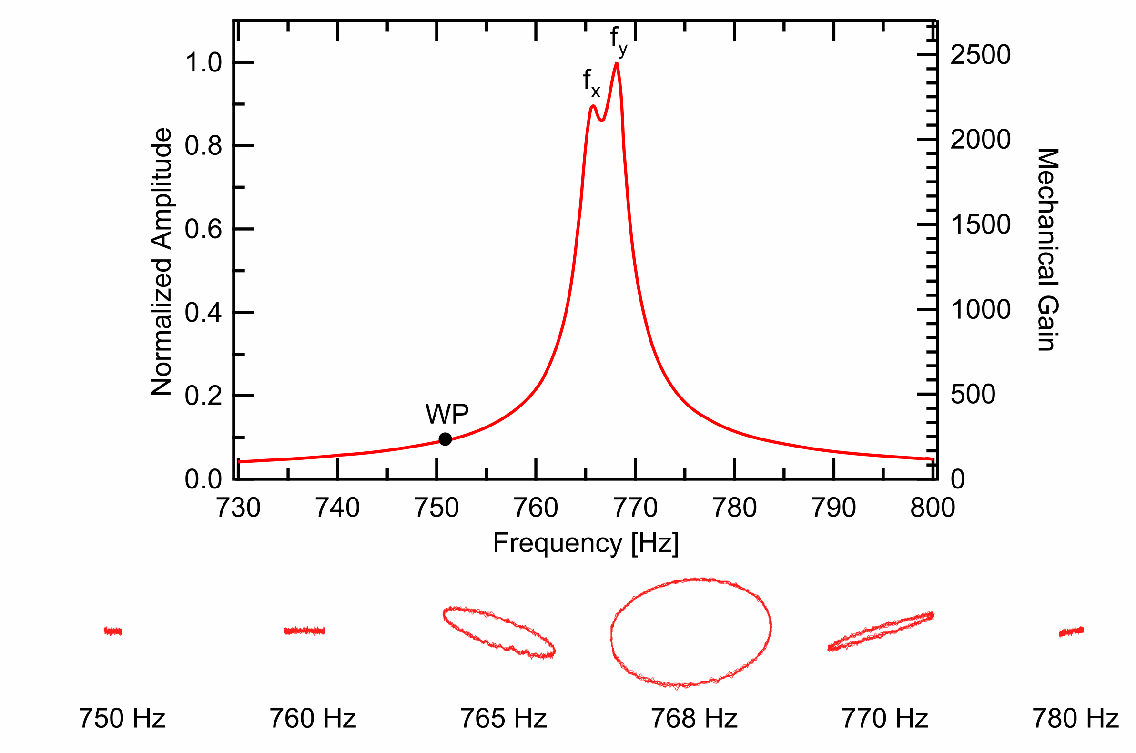
60 Presentation/images/g4619.png
