svilches/666_Thesis/60 Presentation/images/g4790.png

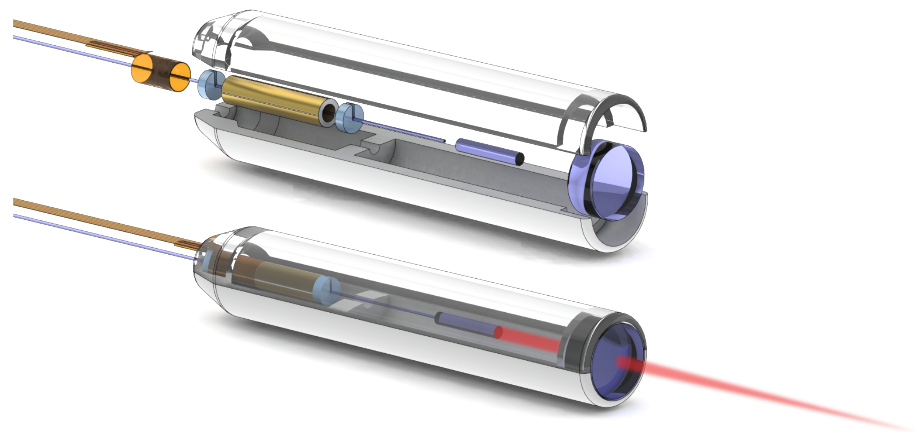
60 Presentation/images/g4790.png
