svilches/666_Thesis/60 Presentation/images/g6173-4.png

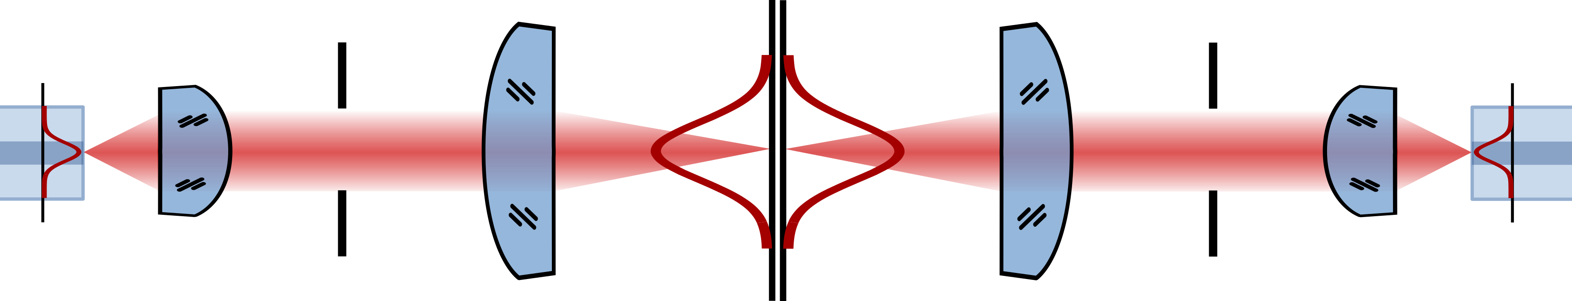
60 Presentation/images/g6173-4.png
