svilches/666_Thesis/60 Presentation/images/g6993-1.png

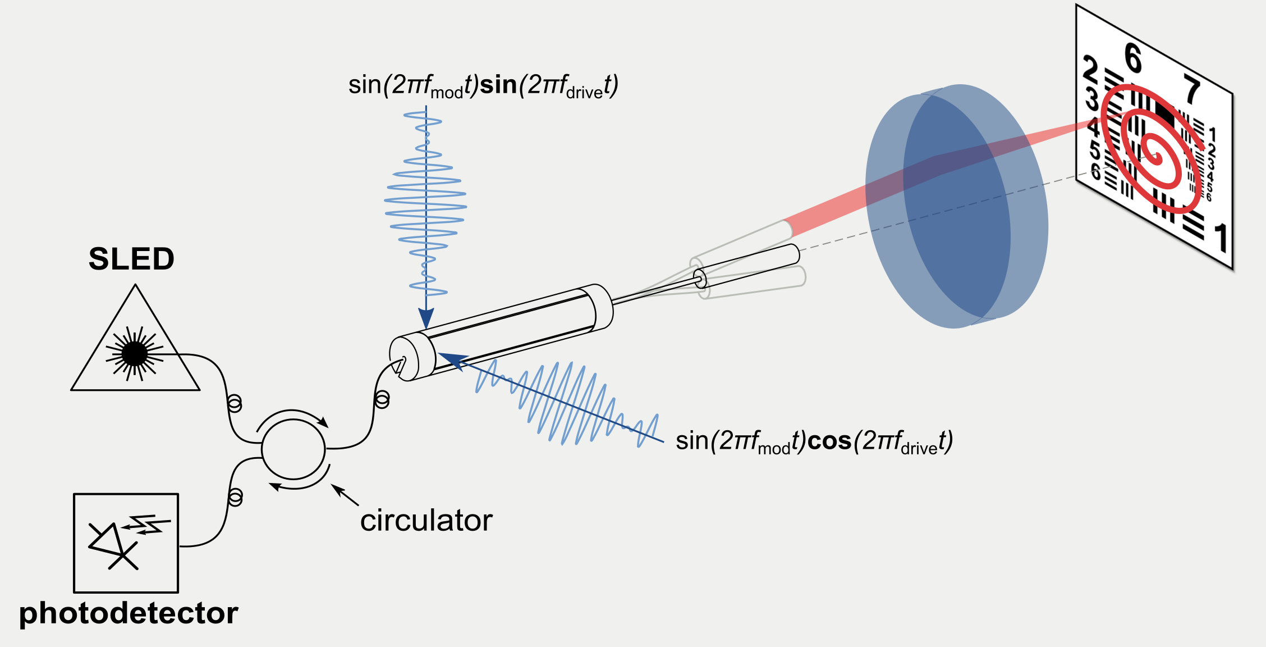
60 Presentation/images/g6993-1.png
