svilches/666_Thesis/60 Presentation/images/g14583.png

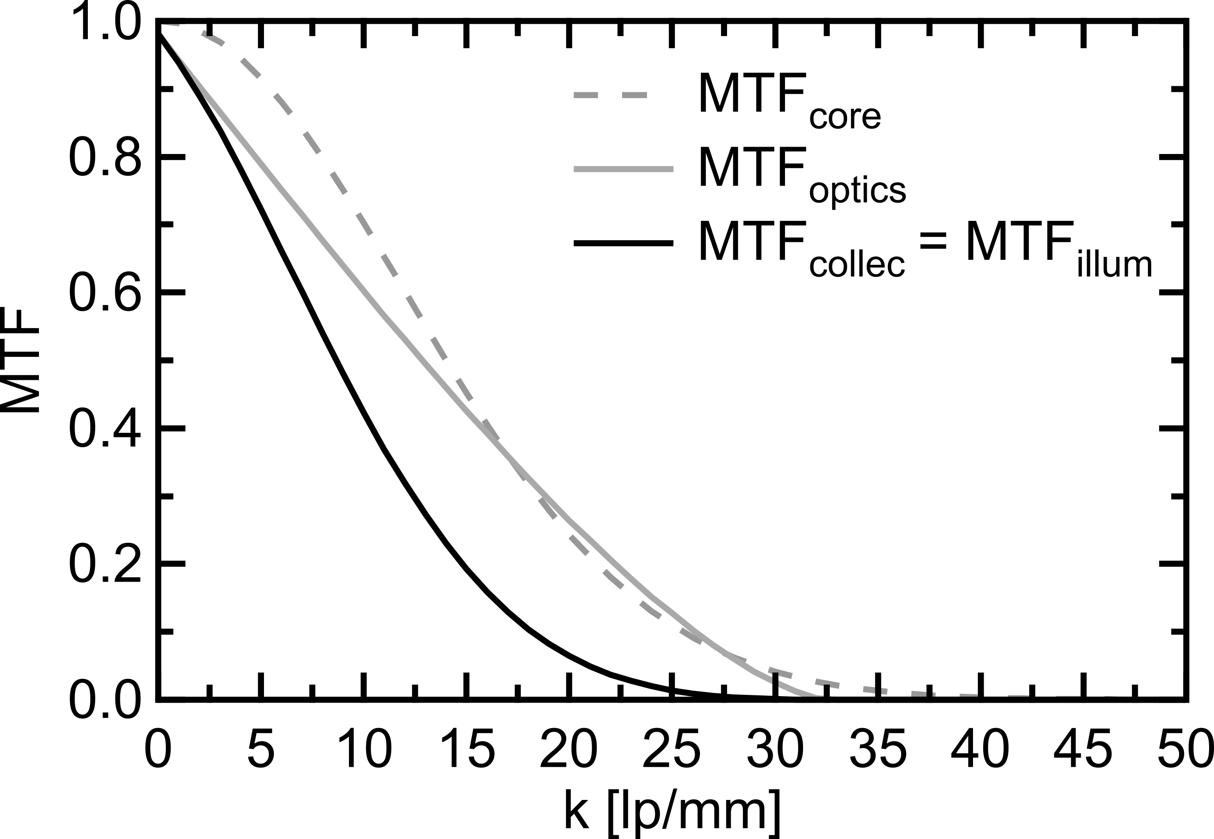
60 Presentation/images/g14583.png
