svilches/666_Thesis/60 Presentation/images/g16945.png

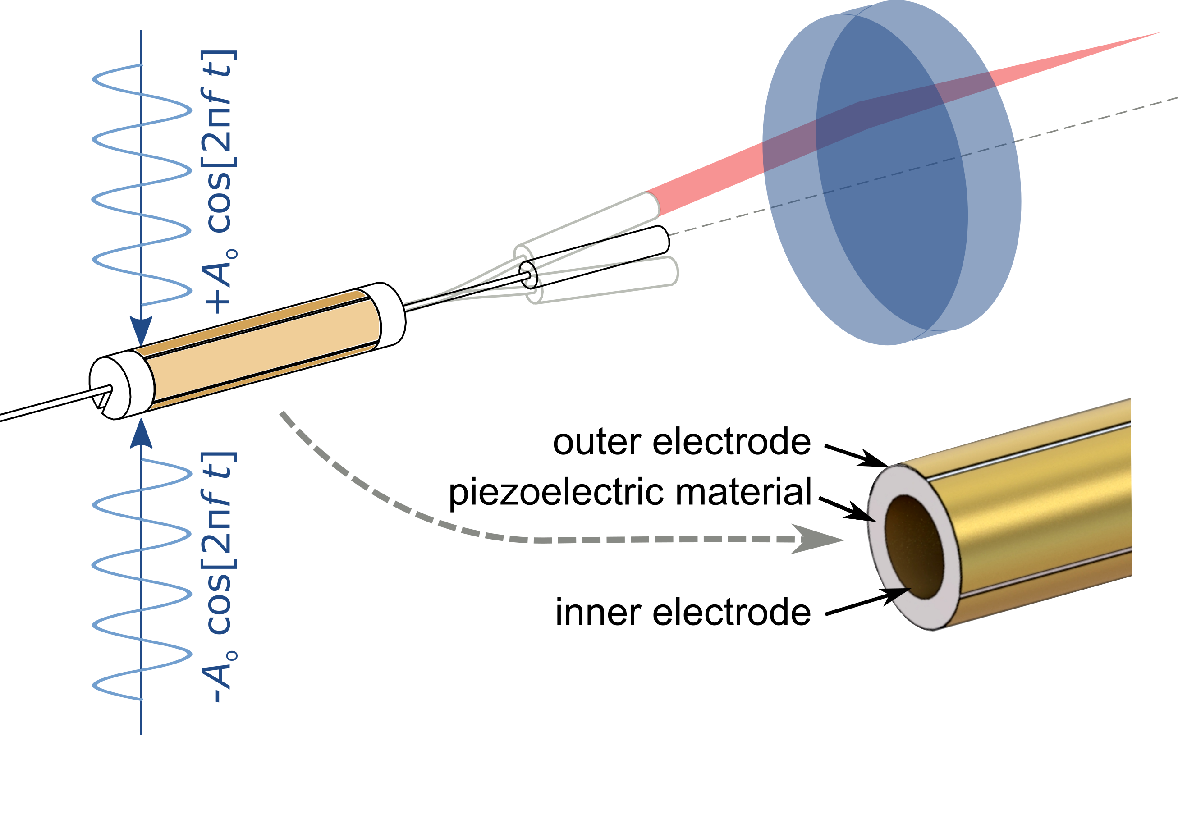
60 Presentation/images/g16945.png
