svilches/666_Thesis/60 Presentation/images/g33199.png

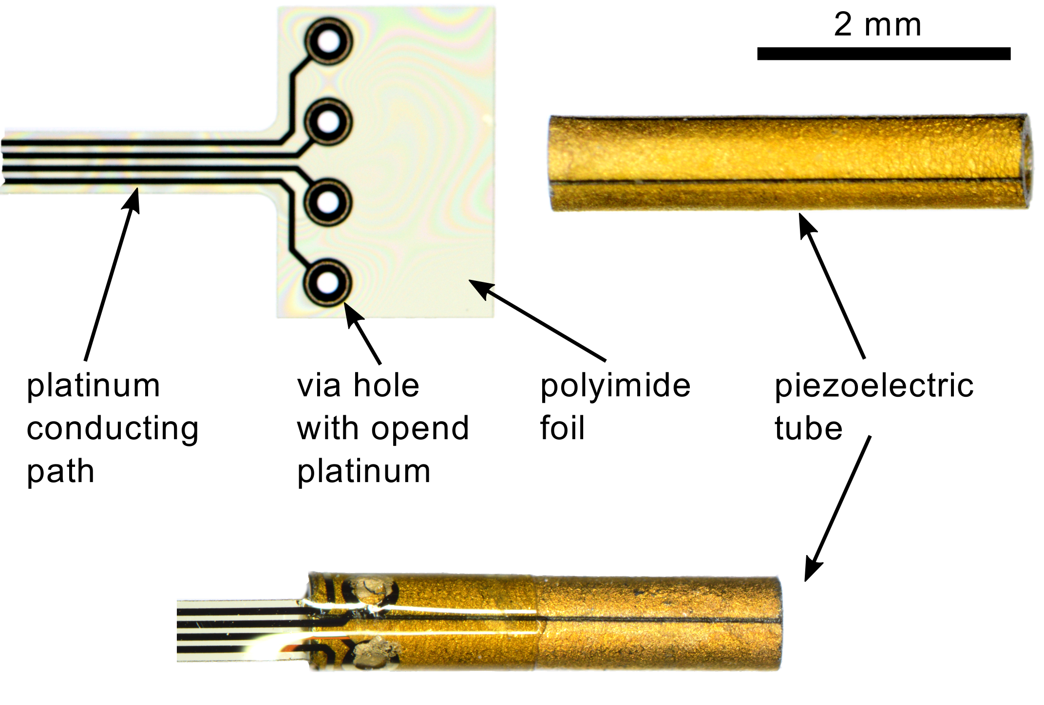
60 Presentation/images/g33199.png
