svilches/666_Thesis/60 Presentation/images/g33454.png

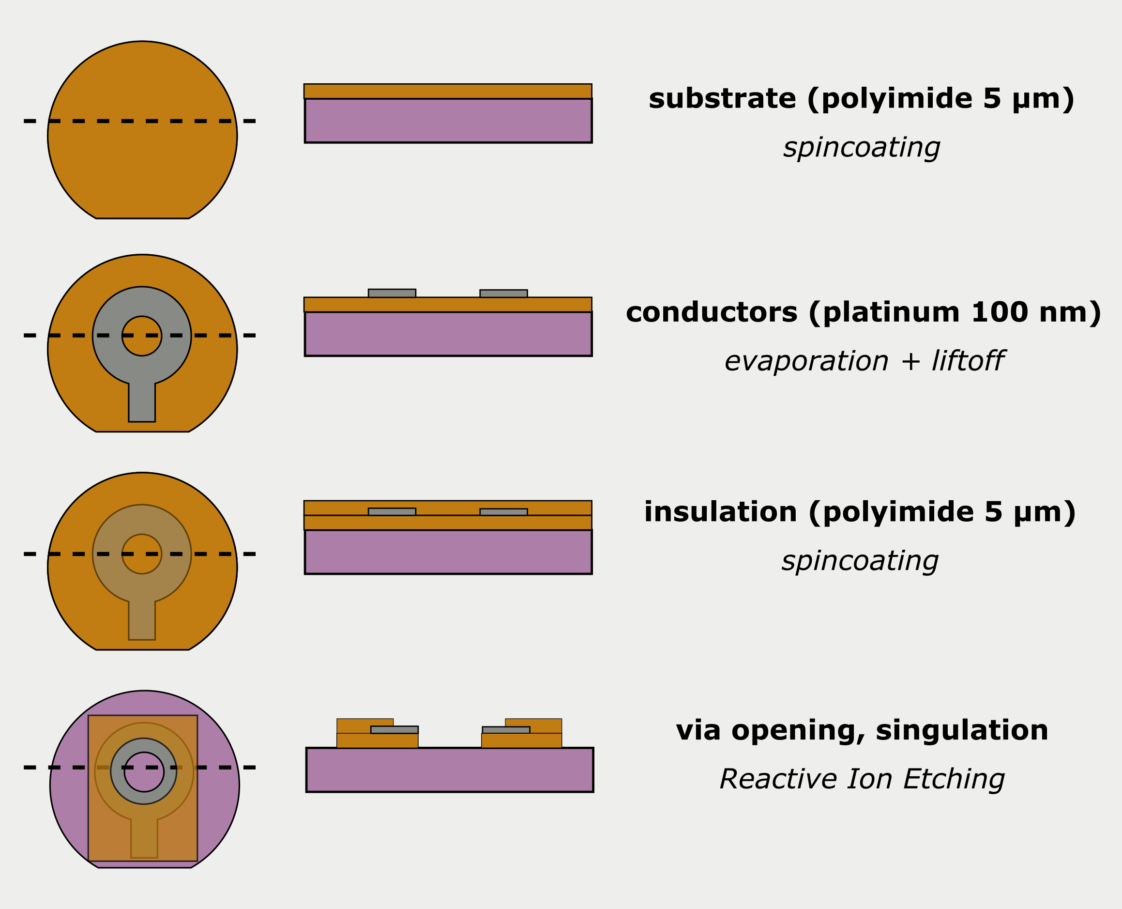
60 Presentation/images/g33454.png
