svilches/666_Thesis/60 Presentation/images/g34043.png

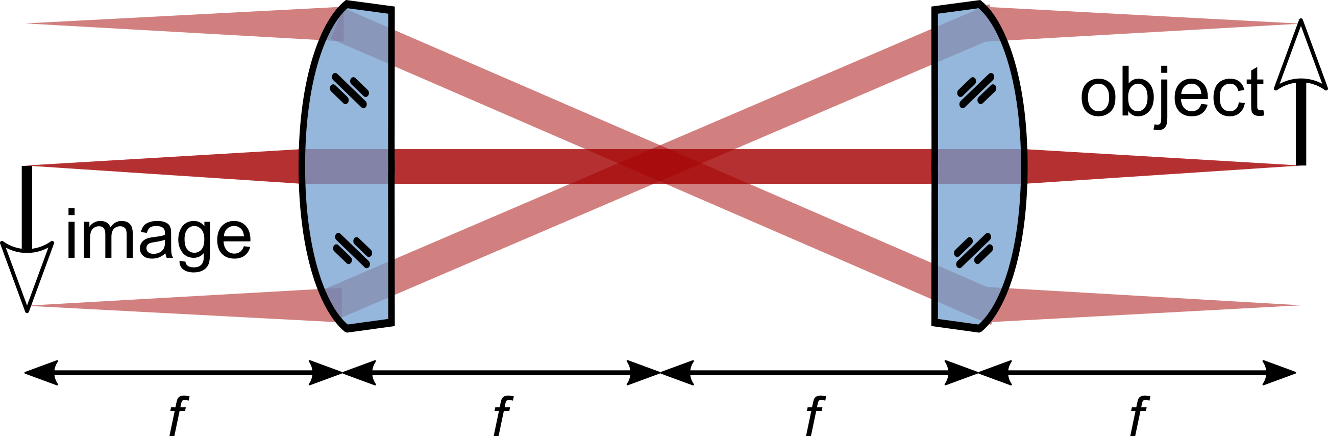
60 Presentation/images/g34043.png
