svilches/666_Thesis/60 Presentation/images/g34102.png

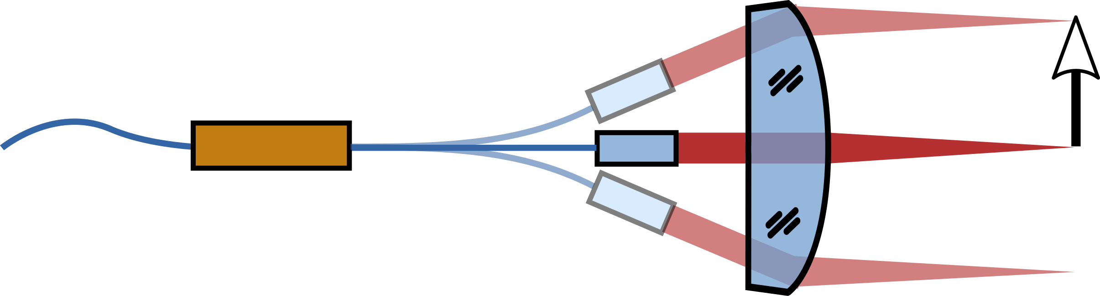
60 Presentation/images/g34102.png
