svilches/666_Thesis/60 Presentation/images/g96642.png

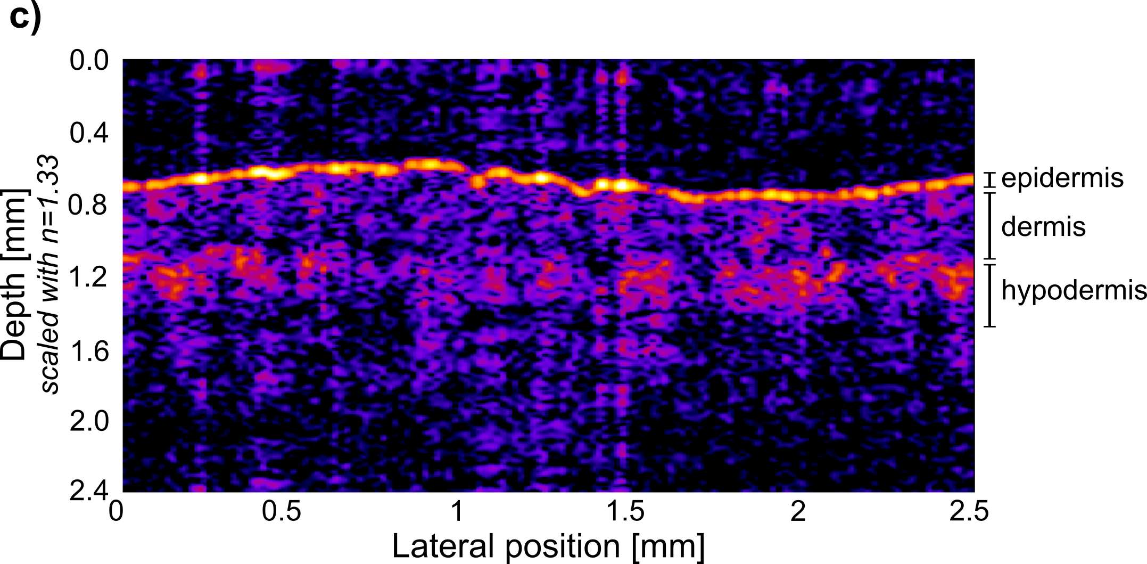
60 Presentation/images/g96642.png
