svilches/666_Thesis/60 Presentation/images/g96654.png

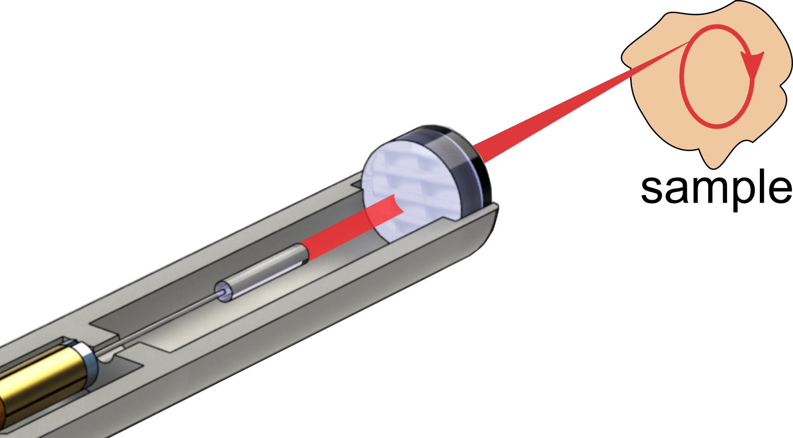
60 Presentation/images/g96654.png
