svilches/666_Thesis/60 Presentation/images/g96697.png

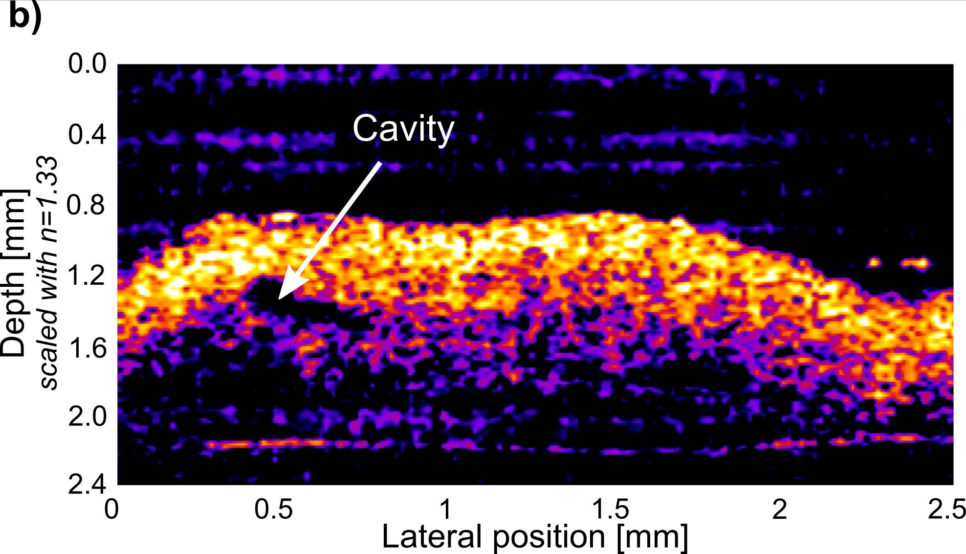
60 Presentation/images/g96697.png
