svilches/666_Thesis/60 Presentation/images/g147428.png

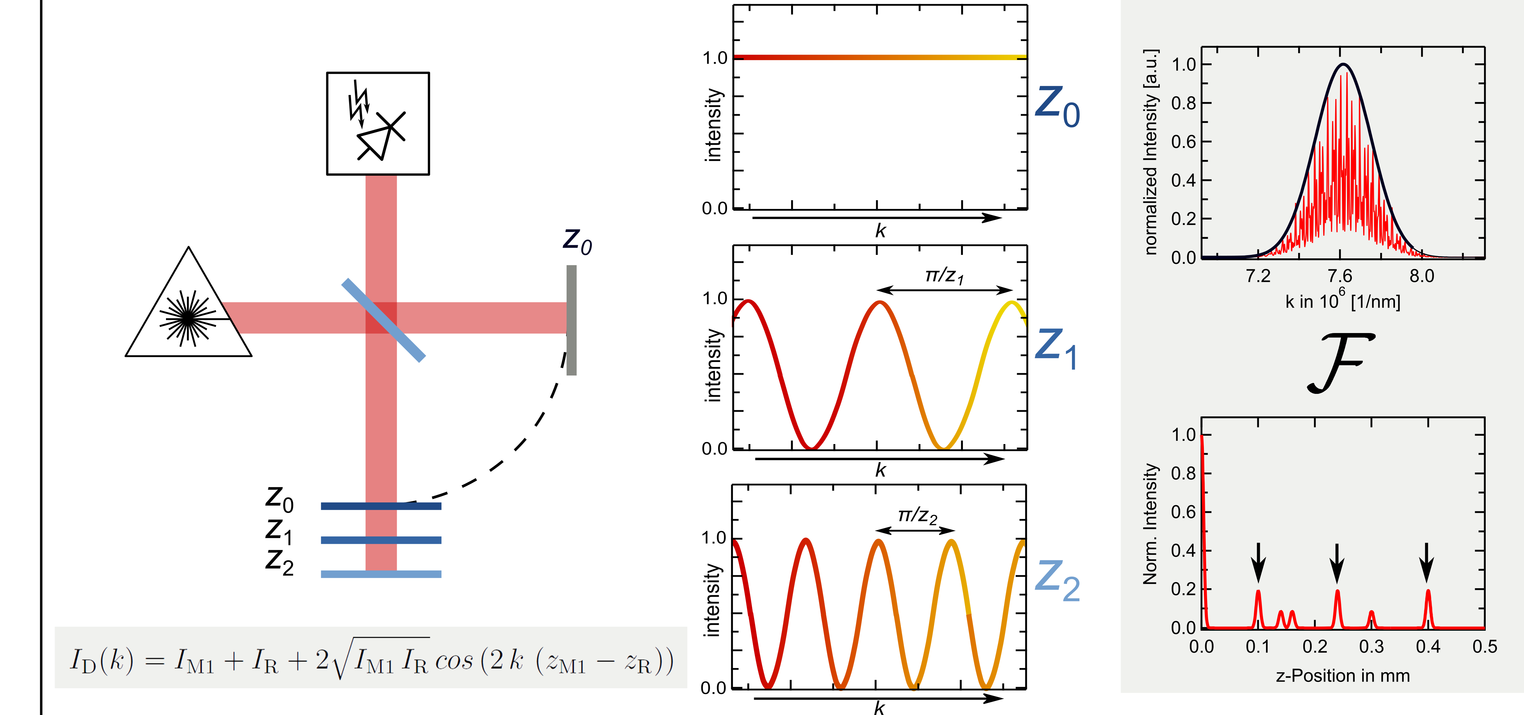
60 Presentation/images/g147428.png
