svilches/666_Thesis/60 Presentation/images/g168391.png

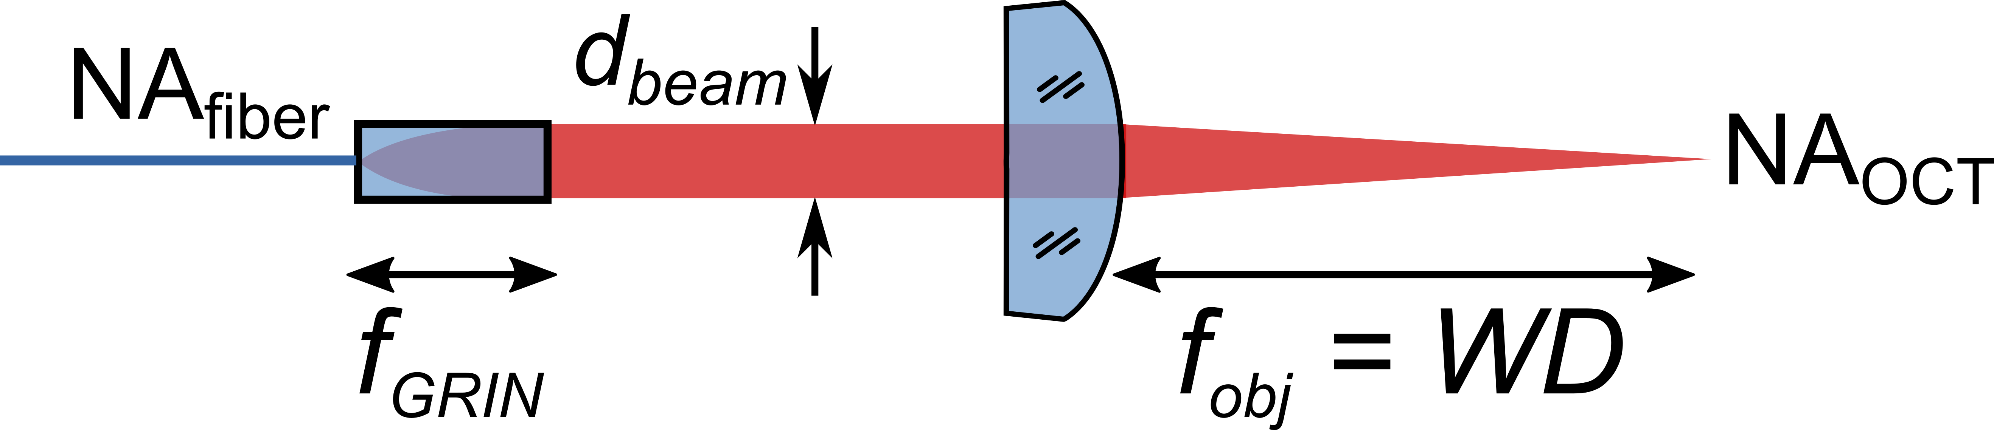
60 Presentation/images/g168391.png
