svilches/666_Thesis/60 Presentation/images/g168630.png

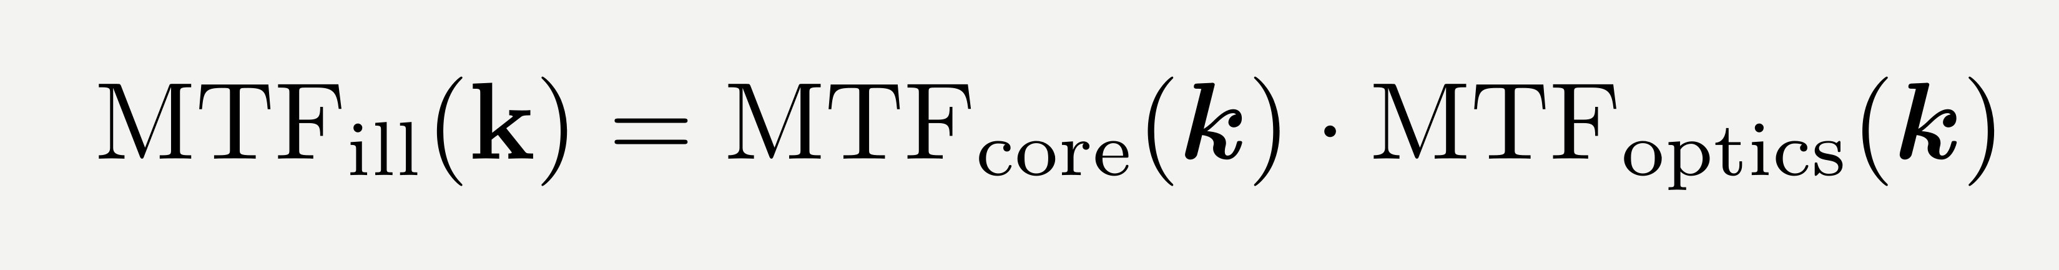
60 Presentation/images/g168630.png
