svilches/666_Thesis/60 Presentation/images/g168818.png

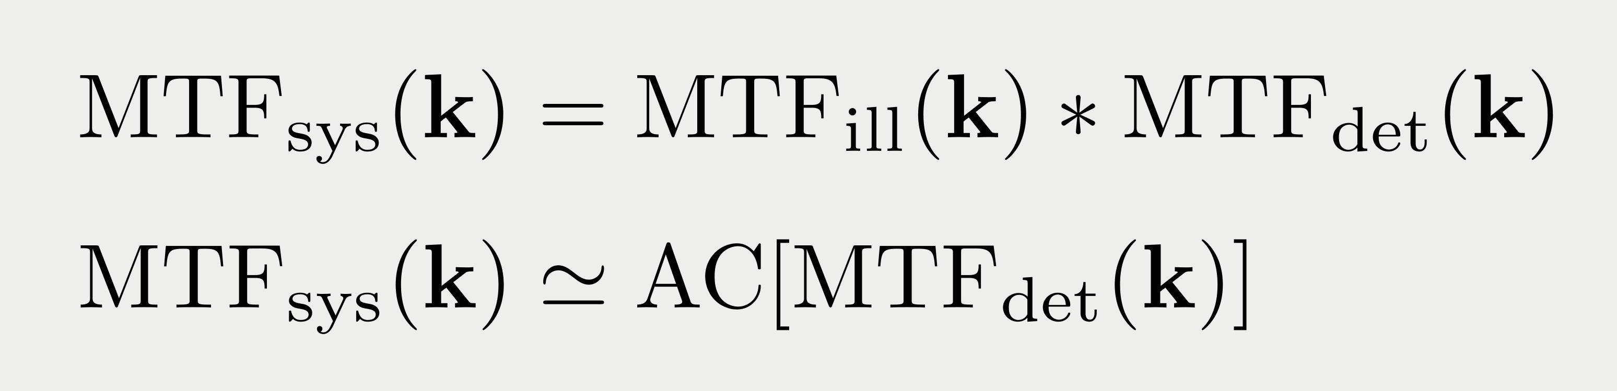
60 Presentation/images/g168818.png
