svilches/666_Thesis/60 Presentation/images/image17146.png

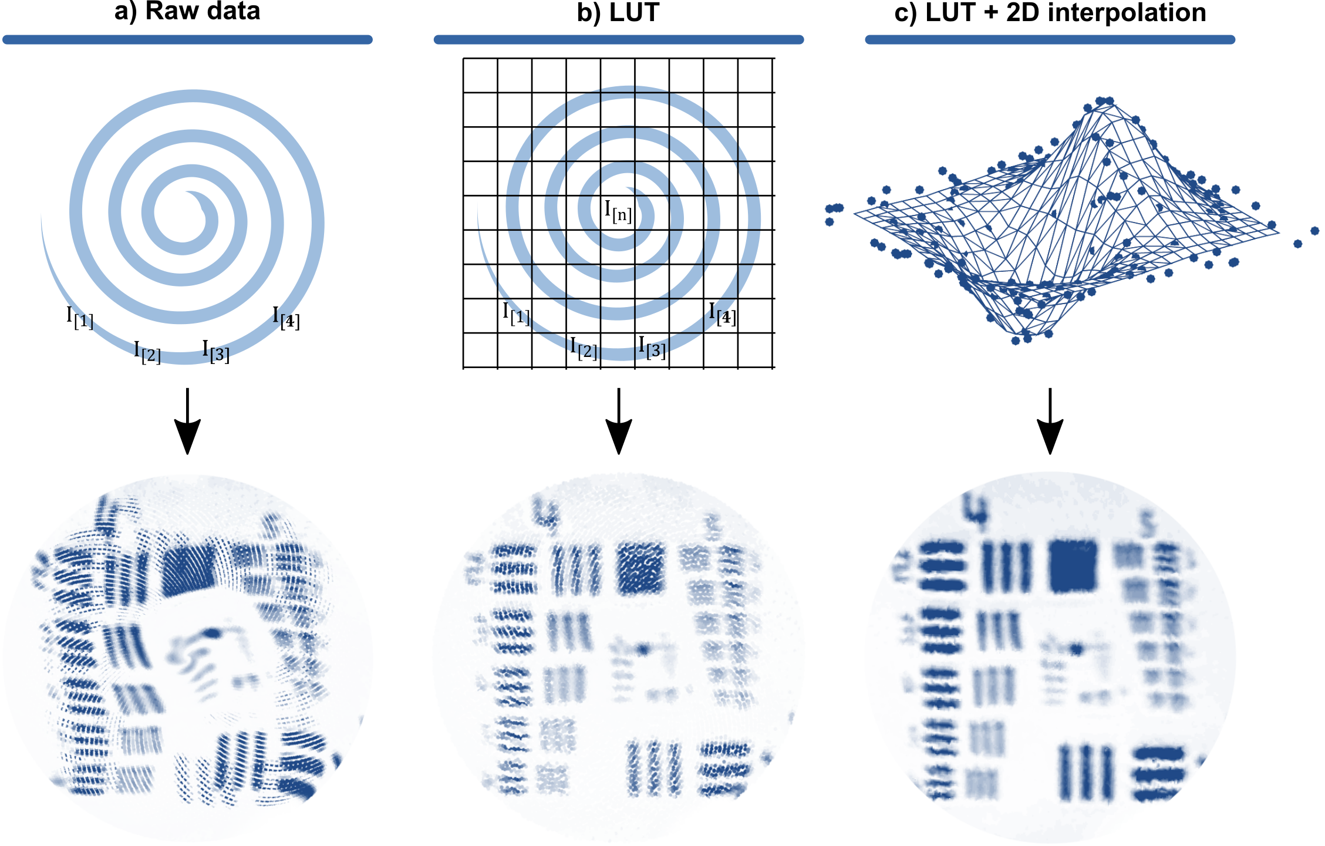
60 Presentation/images/image17146.png
