svilches/666_Thesis/60 Presentation/images/layer1-07.png

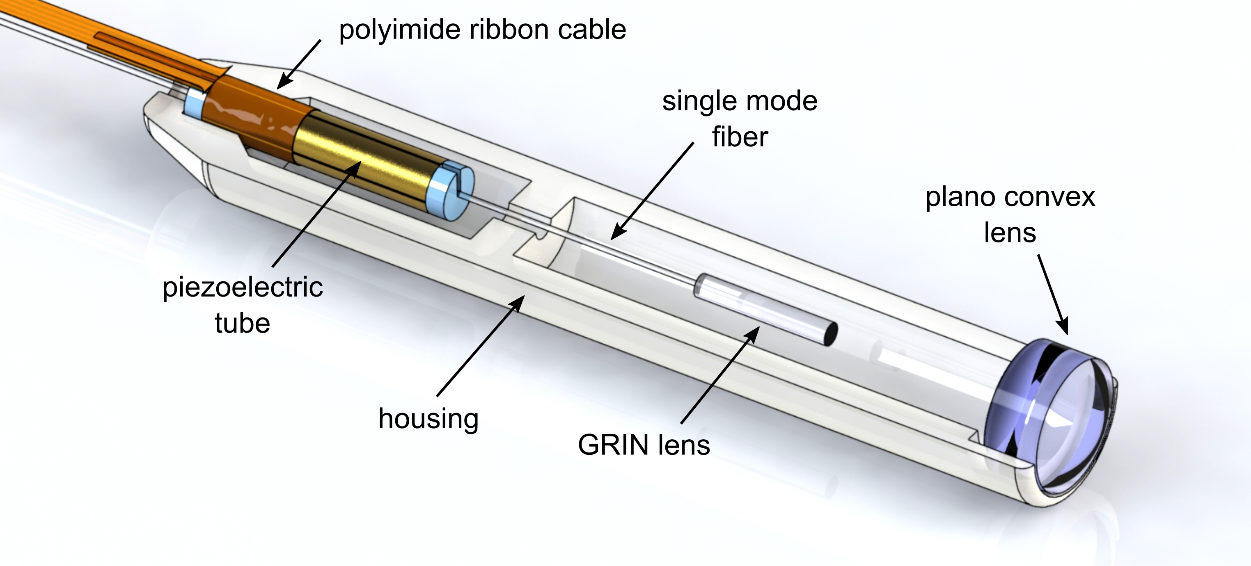
60 Presentation/images/layer1-07.png
