svilches/666_Thesis/60 Presentation/images/layer1-9.png

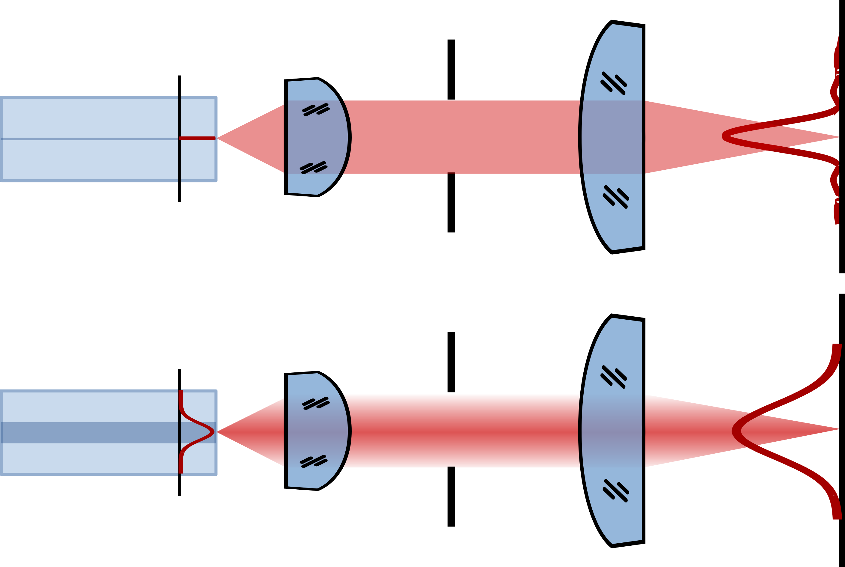
60 Presentation/images/layer1-9.png
