svilches/666_Thesis/60 Presentation/images/layer1-89.png

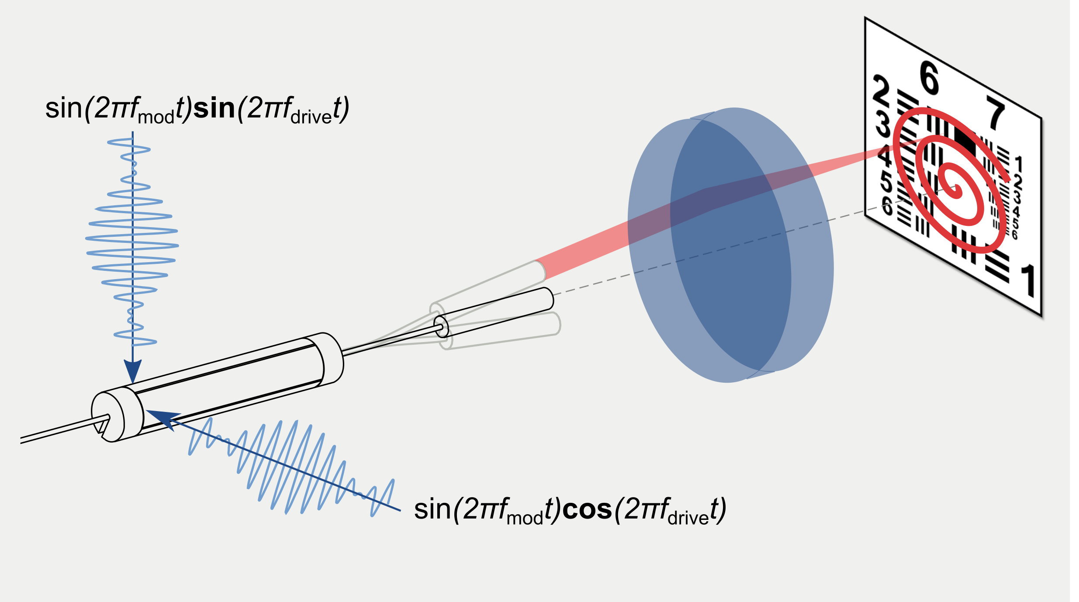
60 Presentation/images/layer1-89.png
