svilches/666_Thesis/60 Presentation/images/path6702-01-6.png

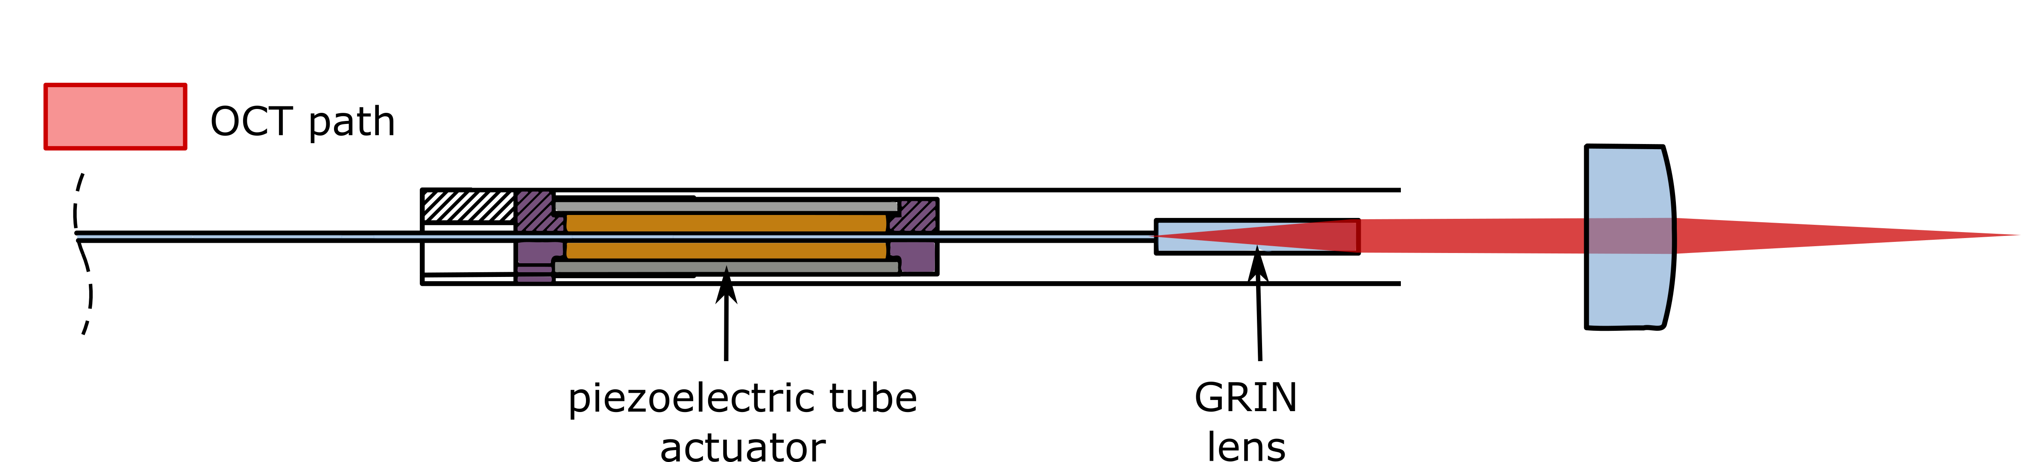
60 Presentation/images/path6702-01-6.png
