svilches/666_Thesis/60 Presentation/images/path10550-7.png

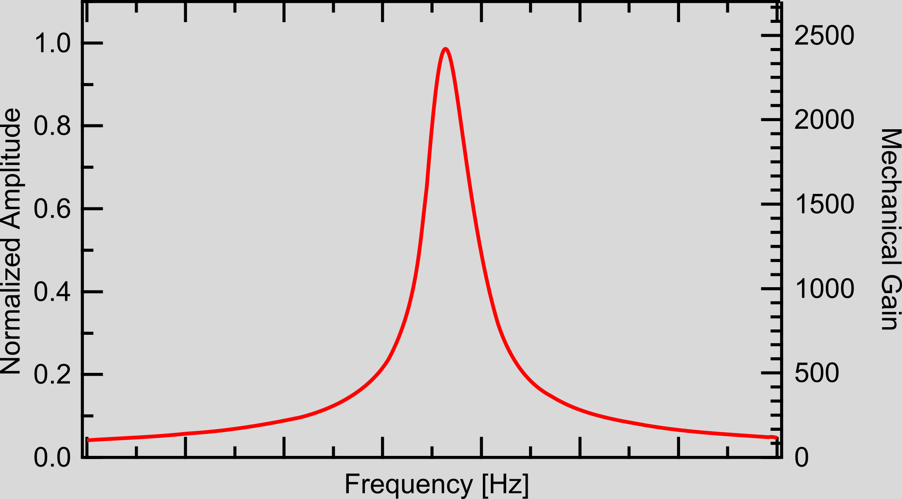
60 Presentation/images/path10550-7.png
