svilches/666_Thesis/60 Presentation/images/rect34279.png

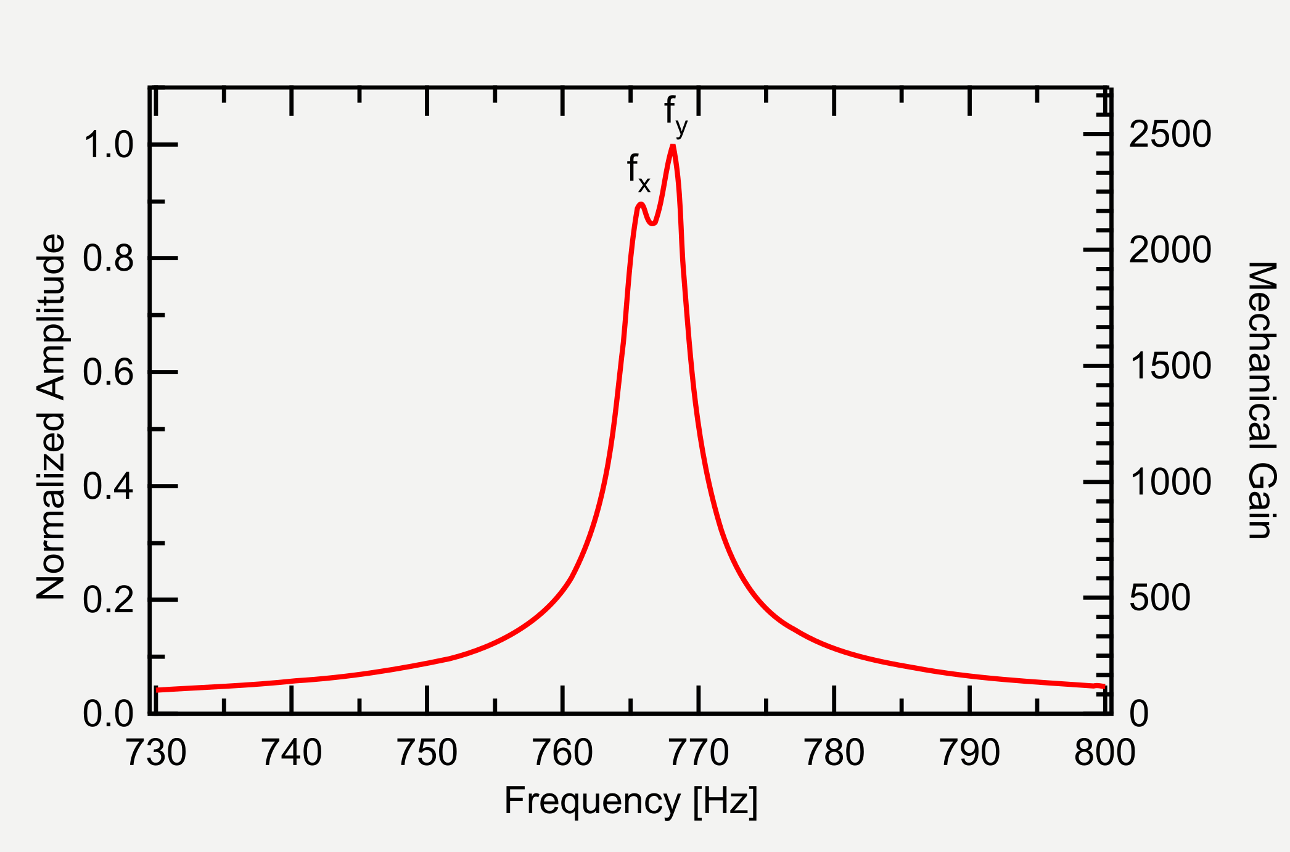
60 Presentation/images/rect34279.png
