svilches/666_Thesis/60 Presentation/images/render01.JPG

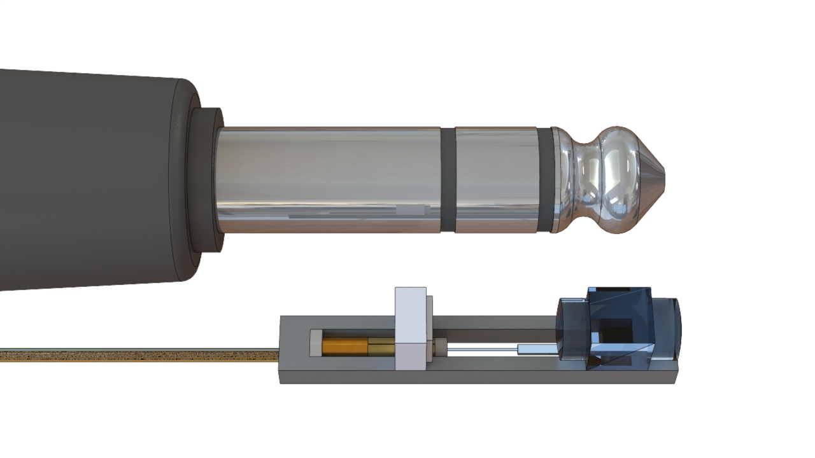
60 Presentation/images/render01.JPG
