svilches/666_Thesis/60 Presentation/images/render02.JPG

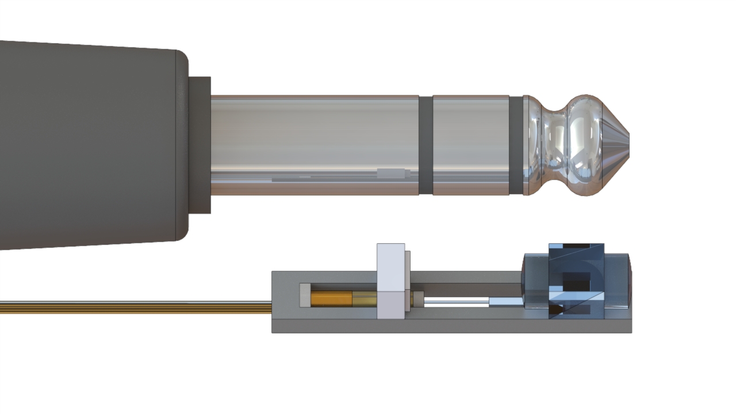
60 Presentation/images/render02.JPG
