svilches/666_Thesis/60 Presentation/images/render03.JPG

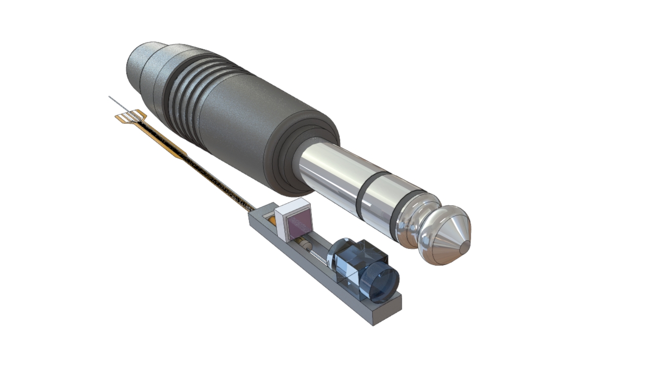
60 Presentation/images/render03.JPG
