svilches/666_Thesis/60 Presentation/images/render04.JPG

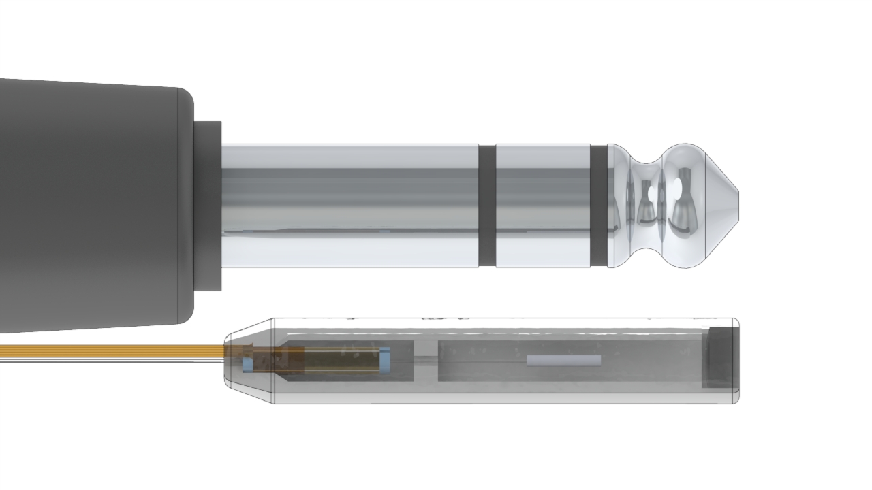
60 Presentation/images/render04.JPG
