svilches/666_Thesis/60 Presentation/images/render05.JPG

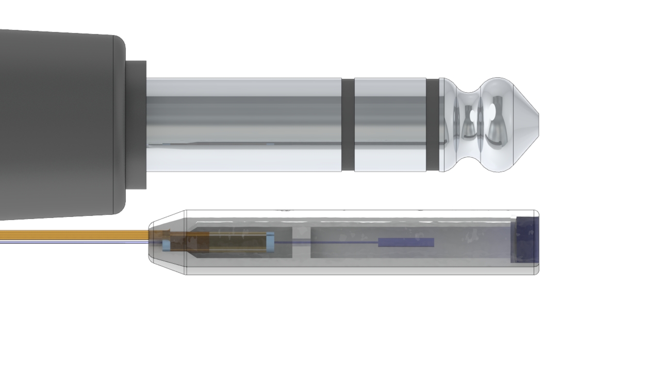
60 Presentation/images/render05.JPG
