svilches/666_Thesis/60 Presentation/images/render06.JPG

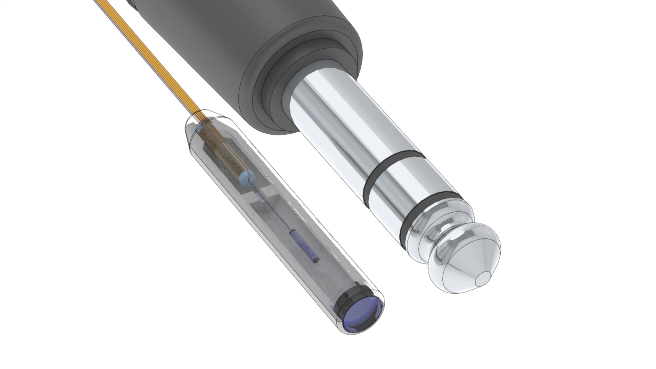
60 Presentation/images/render06.JPG
