svilches/666_Thesis/60 Presentation/images/render08.JPG

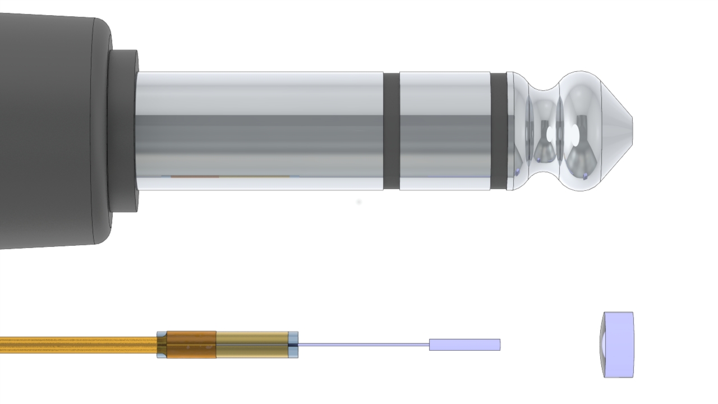
60 Presentation/images/render08.JPG
