svilches/666_Thesis/60 Presentation/images/text4376-9-0.png

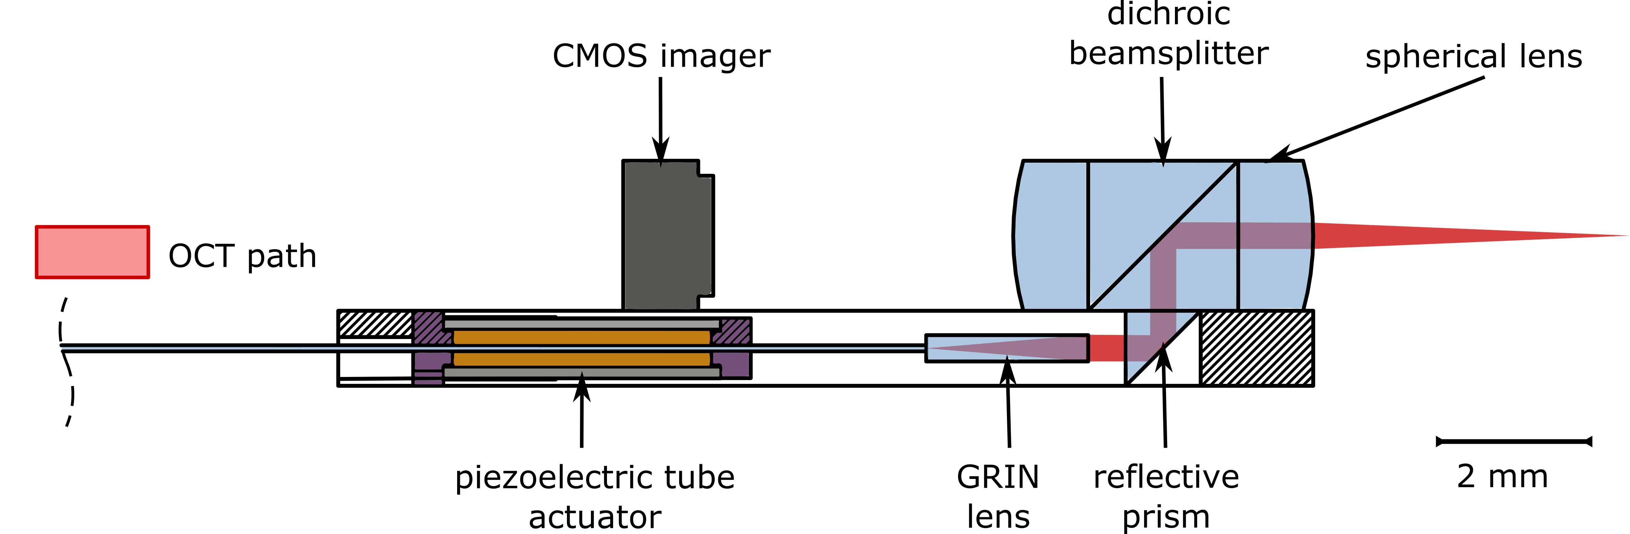
60 Presentation/images/text4376-9-0.png
