svilches/666_Thesis/60 Presentation/images/text4508-9.png

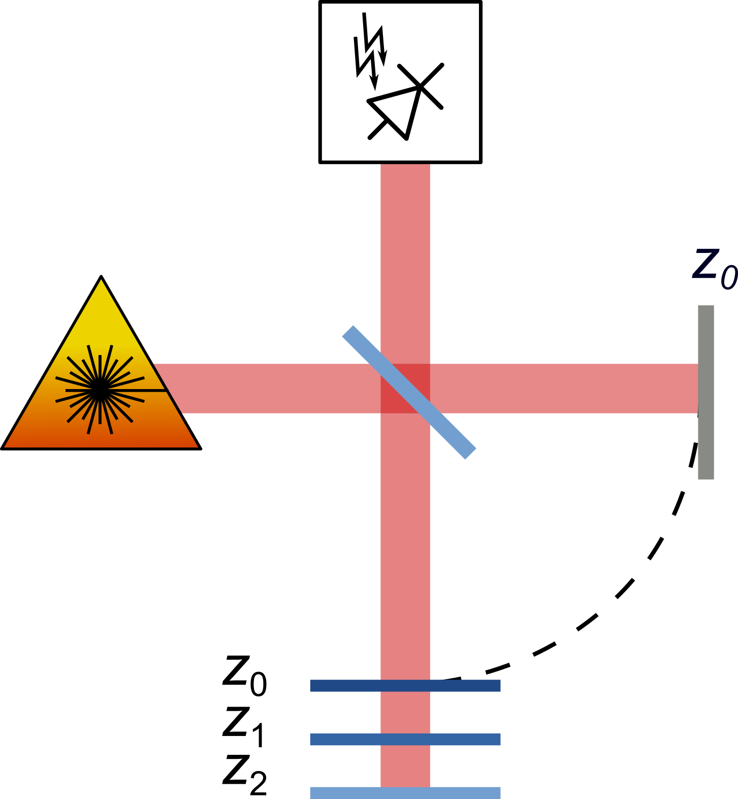
60 Presentation/images/text4508-9.png
