svilches/666_Thesis/60 Presentation/images/text6786-3.png

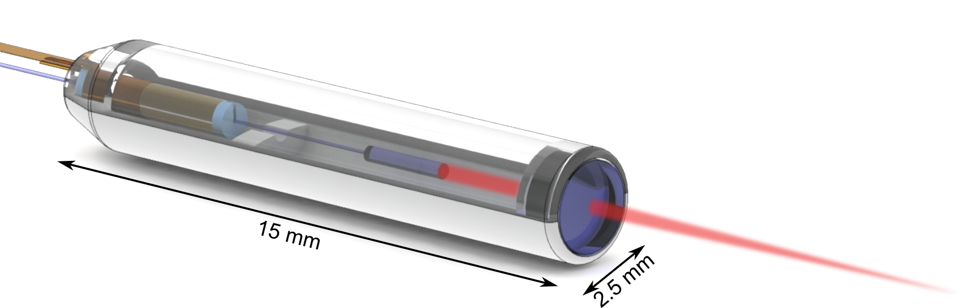
60 Presentation/images/text6786-3.png
