svilches/666_Thesis/70 Paper/figures/OCTring.png

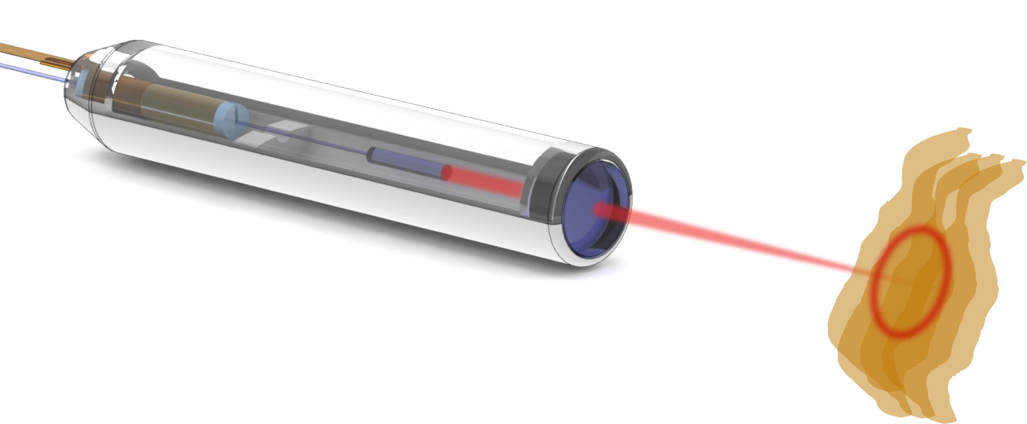
70 Paper/figures/OCTring.png
