svilches/666_Thesis/70 Paper/figures/OCTsystem.png

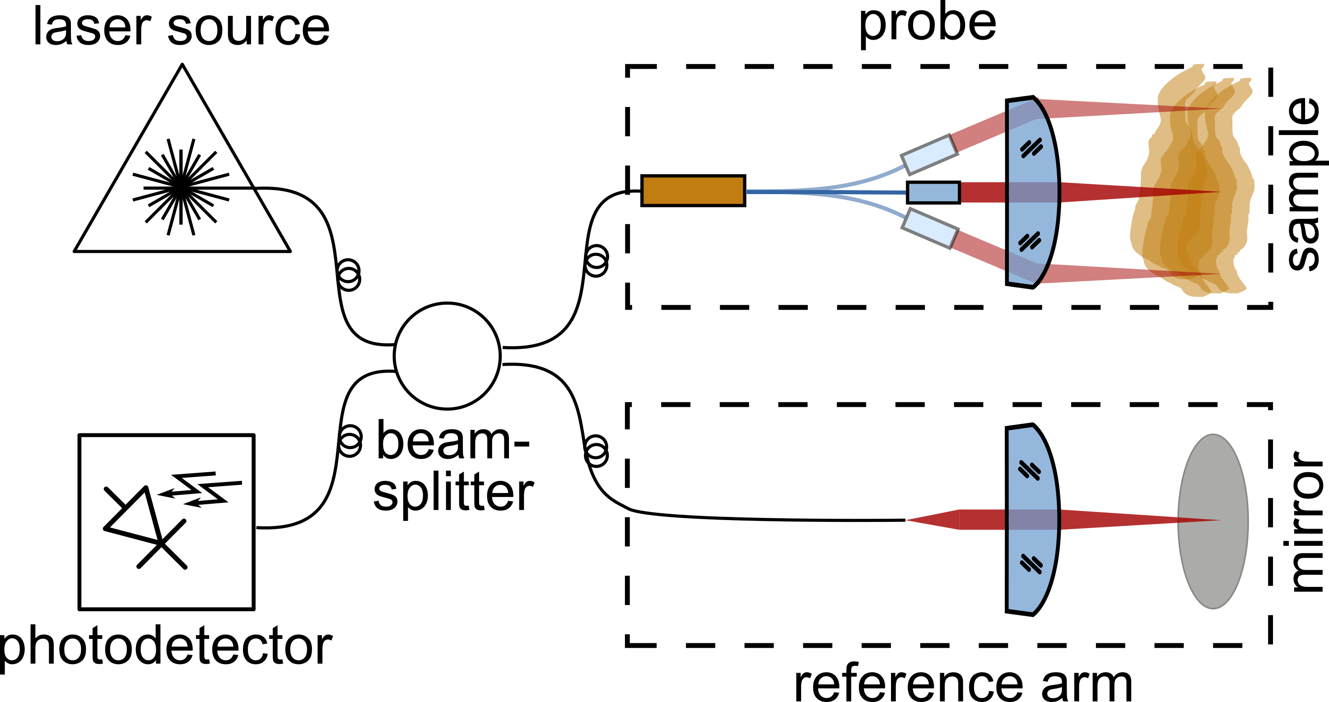
70 Paper/figures/OCTsystem.png
