svilches/666_Thesis/70 Paper/figures/singleSpot.png

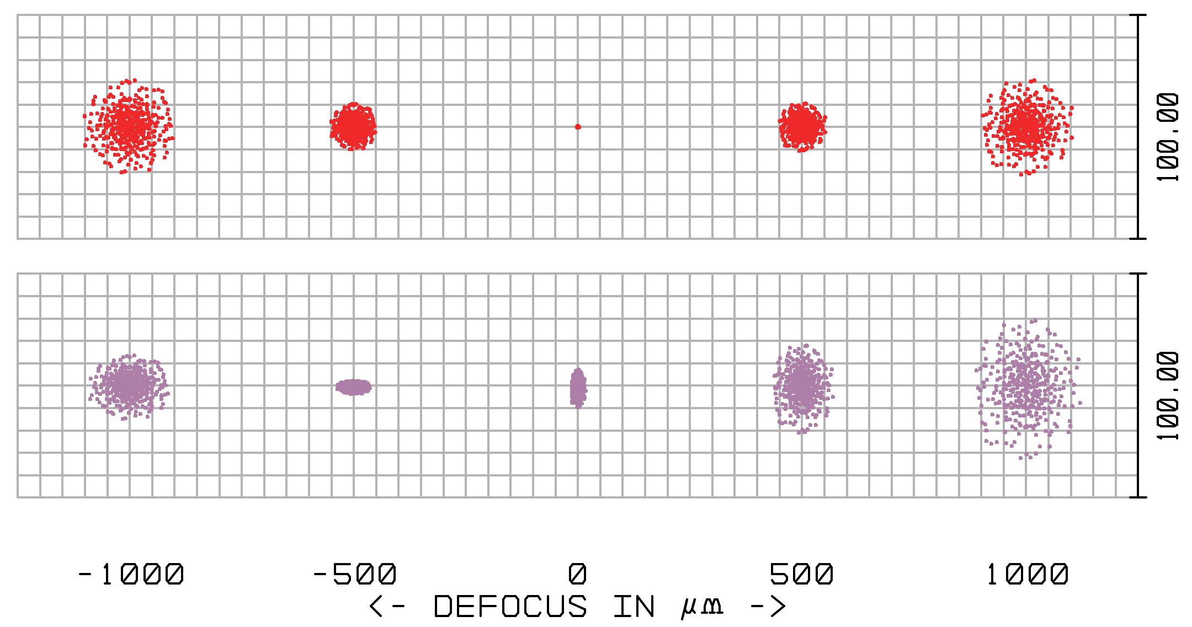
70 Paper/figures/singleSpot.png
