svilches/666_Thesis/20 Templates/Draft_Bachelor-Masterthesis_LATEX_english/parts/Appendix.tex

\chapter{Appendix}
%
%
\section{Source Code}
On the following pages you can find the 1000000 lines of assembler-code used for the µC...
%
%
\includepdf[pages={1-4}]{figures/Appendix/Peking university.pdf}
