svilches/666_Thesis/10 LaTeX/parts/Nomenclature.tex

%%%%%%%%%%%%%%%%%%%%%%%%%%%%%%%%%%%%%%%%%%%%%%%%%%%%%%%%%%
%%                                                                                                             		                                      %%
%%                                                         Nomenklature																			%%
%%                                                                                                                                                       %%
%%%%%%%%%%%%%%%%%%%%%%%%%%%%%%%%%%%%%%%%%%%%%%%%%%%%%%%%%%

\begin{nomenclature}
%% To calc the width, the package \usepackage{calc}
%% has to be included

%------------------------------------------------------Lateinische Buchstaben
\section*{Latin expressions}
\noindent
\begin{longtable}[l]{p{0.2\textwidth}p{0.7\textwidth-6\tabcolsep}p{0.1\textwidth}}
  \tabheadfont{expression}&\tabheadfont{meaning}&\\\midrule\endhead

\textit{distal end}		& the part of the endoscope system which is inserted in the body, i.e. the probe. \\
\textit{en face}		& referring to the plane perpendicular to the optical axis\\
\textit{ex situ}		& performed in a different place\\
\textit{in situ}		& performed in the current place\\
\textit{in vivo}		& a study performed on whole, living organism\\
\textit{lumen}			& the inside space of a tubular structure, such as an artery or intestine\\
\textit{proximal end}	& the part of the endoscope system furthest point from the distal end, i.e. closer to the acquisition and processing system. \\
	
\end{longtable}
\section*{Latin letters}
\noindent
\begin{longtable}[l]{p{0.2\textwidth}p{0.7\textwidth-6\tabcolsep}p{0.1\textwidth}}
  \tabheadfont{variable}&\tabheadfont{meaning}&\tabheadfont{unit}\\\midrule\endhead
$A$ 					& area 								& $\unit{m^2}$\\
$b(x,y,z)$				& 3D image							& $\unit{-}$\\
$C_\textrm{Rayleigh}$	& Rayleigh contrast					& \\
$D$ 					& diameter 							& $\unit{m}$\\
$d_{31}$				& piezoelectric strain coefficient 	& $\unit{C/N}$\\
$E$						& electric field						& $\unit{V/m}$\\
$\mathcal{F}$			& Fourier transform					& \\
$f$						& frequency							& $\unit{Hz}$\\
$f(x,y,z)$				& 3D object							& \\
$f_{res}$				& resonant frequency 				& $\unit{Hz}$\\
$I$						& light intensity					& $\unit{W/m^2}$\\
$I$						& mechanical moment of inertia		& \SI{}{kg.m^2}\\
$I[n]$					& Intensity at the photodetector	& $\unit{A}$\\
$K$						& truncation factor of a gaussian beam			& \\
$k$						& wavenumber, spatial frequency		& $\unit{m^{-1}}$\\
$K_{cantilever}$		& mechanical elastic constant of a cantilever	& $\unit{N/m}$\\
$L$ 					& length 							& $\unit{m}$\\
$M$						& optical magnification				& \\
$m$ 					& mass 								& $\unit{kg}$\\
$N_\textrm{rings}$		& number of rings in a spiral		& \\
$n$						& sample points per ring in spiral scanning		& \\
$T$						& oscillation period				& $\unit{s}$\\
$t$    					& time 				  				& $\unit{s}$\\
$u_x[n]$				& Driving voltage for $x$ axis		& $\unit{V}$\\
$V$						& voltage							& $\unit{V}$\\
$w$    					& width 							& $\unit{m}$\\
$y$						& vertical displacement				& $\unit{m}$\\
$z$						& axial distance					& $\unit{m}$\\
$z_\textrm{6dB}$		& OCT penetration depth				& $\unit{m}$\\
\end{longtable}

%-------------------------------------------------------------Grichische Buchstaben

\section*{Greek letters}
\begin{longtable}[l]{p{0.2\textwidth}p{0.7\textwidth-6\tabcolsep}p{0.1\textwidth}}
  \tabheadfont{variable}&\tabheadfont{meaning}&\tabheadfont{unit}\\\midrule\endhead
  
$\Delta k$				& wavenumber sweep range			& $\unit{m^{-1}}$\\
$\delta z$				& axial resolution					& $\unit{m}$\\
$\epsilon$						& mechanical strain									& \\
$\lambda$				& wavelength						& $\unit{m}$\\
$\theta$ 				& angle & $\unit{\degree}$, $\unit{rad}$\\

\end{longtable}
%-----------------------------------------------------------Indizes
%\section*{Indices}
%
%\begin{longtable}[l]{p{0.2\textwidth}p{0.8\textwidth-4\tabcolsep}}
%  \tabheadfont{index}&\tabheadfont{meaning}\\\midrule\endhead
%$lg$    				& liquid-gas\\
%$sg$ 					& solid-gas\\
%$sl$ 					& solid-liquid\\
%$la$          			& liquid-ambient\\
%%$RB$         & Right Bottom \\
%%$TL$         & Top Left \\
%
%\end{longtable}

\section*{Abbreviations}
\begin{longtable}[l]{p{0.2\textwidth}p{0.8\textwidth-4\tabcolsep}}
  \tabheadfont{abbreviation}&\tabheadfont{meaning}\\\midrule\endhead
1D						& 1-dimensional\\
2D 						& 2-dimensional\\
3D 						& 3-dimensional\\
A-Scan					& 1D OCT measurement (usually a line parallel to the optical axis)\\
B-Scan					& 2D OCT measurement (usually in a plane parallel to the optical axis)\\
C-Scan					& 3D OCT measurement (a volume)\\
CFB						& Coherent Fiber Bundle\\
DAQ						& Data Acquisition System\\
DoF						& Depth of Field\\
ESF						& Edge Spread Function\\
FC/APC					& fiber Ferrule Connector using Angled Physical Contact \\
FOV						& Field of View\\
FWHM					& Full Width Half Maximum \\
HYAZINT					& Multimodal probe developed at IMTEK\\
IMTEK					& Institure for Microsystems Engineering\\
lp/mm					& line pairs per millimeter\\
LSF						& Line Spread Function\\
LSI						& Laser Scanning Imaging \\
MEMS					& Micro Electromechanical Systems\\
MFD						& Mode Field Diameter (of a gaussian beam)\\
MTF						& Modulation Transfer Function\\
NA						& Numerical Aperture\\
OCT						& Optical Coherence Tomography\\
OTF						& Optical Transfer Function\\
PSD						& Position Sensitive Detector\\
PSF						& Point Spread Function\\
SNR						& Signal-to-Noise Ratio\\
SS-OCT					& Swept-Source Optical Coherence Tomography\\
ZIF						& Zero Insertion Force connector\\

\end{longtable}
\end{nomenclature}
