svilches/666_Thesis/20 Templates/Draft_Bachelor-Masterthesis_LATEX_english/parts/Abstracts.tex

%%%%%%%%%%%%%%%%%%%%%%%%%%%%%%%%%%%%%%%%%%%%%%%%%%%%%%%%%%%%%%%%%%%%%%%%%%%%%%%%%
%%%%%                                                                Deutsche Kurzusammenfassung	                      																				
%%%%%%%%%%%%%%%%%%%%%%%%%%%%%%%%%%%%%%%%%%%%%%%%%%%%%%%%%%%%%%%%%%%%%%%%%%%%%%%%%
%%%%%
%%%%%
\frontmatter
\maketitle
\cleardoublepage\phantomsection\pdfbookmark{\abstractname}{abstract} %% fuegt ersten Abstract in die Bookmarks ein

\begin{otherlanguage}{ngerman}   %... falls Restdokument auf English...
\begin{abstract}
  In der vorliegenden Arbeit werden zwei grundsätzlich verschiedene Konzepte 
	zur Realisierung einer ??? vorgestellt. Ausgehend 
	von Vorarbeiten wurde dies und das im wesentlichen erreicht.
	
	In einer Analyse des state-of-the-art von aaa 
	werden zunächst verschiedene, meist aaa Funktionsprinzipien vorgestellt, 
	bevor einige Grundlagen der aaa hergeleitet werden.
	
	Im Anschluss daran wird 
	die aaa detailliert diskutiert. 
	Die aus einer ersten 
	Versuchsreihe gewonnenen Erkenntnisse führen zur Ableitung wichtiger Design-Regeln, 
	welche zur erfolgreichen Umsetzung eines aaa führen. 
	
	Ein weiterer Kern dieser Arbeit besteht in der Charakterisierung aller aaa. 
	Daneben wird ein komplexer Herstellungsprozess 
	durch Optimierung mehrerer Einzelprozessschritte entwickelt. 
	Alle wesentlichen Prozessschritte zur Herstellung der aaa werden besprochen, 
	wobei Lösungen für die im Prozess aufgetretenen Problemstellungen präsentiert werden.
	
	Nach der erfolgreichen Herstellung werden die aa durch aaa 
	optisch charakterisiert. Das dynamische Verhalten der aaa werden sowohl qualitativ als auch
	quantitativ untersucht. Mit der entwickelten aaa können aaa erreicht werden.
  
	\bigskip\par
  \textbf{Stichwörter:} a, b, c, d, e, f
\end{abstract}
\end{otherlanguage}

%%%%%%%%%%%%%%%%%%%%%%%%%%%%%%%%%%%%%%%%%%%%%%%%%%%%%%%%%%%%%%%%%%%%%%%%%%%%%%%%%
%%%%%                                                                 English Abstract												
%%%%%%%%%%%%%%%%%%%%%%%%%%%%%%%%%%%%%%%%%%%%%%%%%%%%%%%%%%%%%%%%%%%%%%%%%%%%%%%%%
%%%%%
%%%%%
%\begin{otherlanguage}{english}
\begin{abstract}
  Chicken Chicken Chicken Chicken Chicken Chicken Chicken Chicken Chicken Chicken Chicken Chicken Chicken Chicken Chicken Chicken Chicken Chicken Chicken Chicken Chicken Chicken Chicken Chicken Chicken Chicken Chicken Chicken Chicken Chicken Chicken Chicken Chicken Chicken Chicken Chicken Chicken Chicken Chicken Chicken Chicken Chicken Chicken Chicken Chicken Chicken Chicken Chicken Chicken Chicken Chicken Chicken Chicken Chicken Chicken Chicken Chicken Chicken Chicken Chicken Chicken Chicken Chicken Chicken Chicken Chicken Chicken Chicken Chicken Chicken Chicken Chicken Chicken Chicken Chicken Chicken Chicken Chicken 
  
	%\bigskip\par
  \textbf{Keywords:} IMTEK, Master Thesis
\end{abstract}
%\end{otherlanguage}
