svilches/666_Thesis/20 Templates/Draft_Bachelor-Masterthesis_LATEX_english/parts/FirstPages.tex

%%%%%%%%%%%%%%%%%%%%%%%%%%%%%%%%%%%%%%%%%%%%%%%%%%%%%%%%%%
%%                                                                                                             		                                      %%
%%                                                         Vorspann																			     %%
%%                                                                                                                                                       %%
%%%%%%%%%%%%%%%%%%%%%%%%%%%%%%%%%%%%%%%%%%%%%%%%%%%%%%%%%%

\author{Uncle Hans}

\title{Title of the Thesis}
\hypersetup{pdfkeywords={IMTEK, Master Thesis}}

%% Insert Title pic.
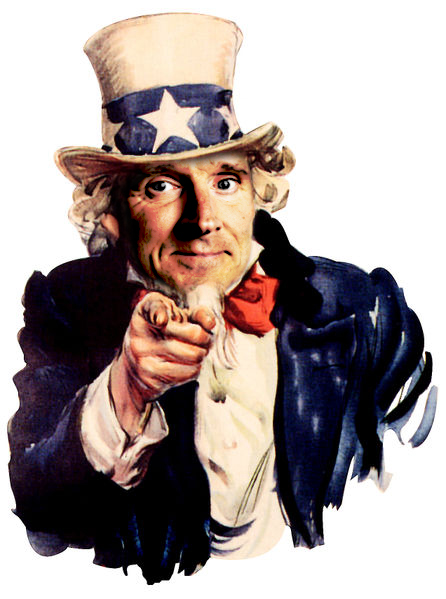
[picture p164: 20 Templates/Draft_Bachelor-Masterthesis_LATEX_english/figures/Titelbild.jpg]
\titlepic{}
\titlepicdesc{The title picture shows an incredibly awesome device. Feel the magic!}

%%%%%%%%%%%%%%%%%%%%%%%%%%%%%%%%%%%%%%%%%%%%%%%%%%%%%%%%%%%%%%%%%%%%%%%%%%%%%%%%%
%                                                                 Präambel                    																				
%%%%%%%%%%%%%%%%%%%%%%%%%%%%%%%%%%%%%%%%%%%%%%%%%%%%%%%%%%%%%%%%%%%%%%%%%%%%%%%%%

%% Die auskommentierten Varianten sind bei englischer Praeambel zu verwenden
%\dpoversion{20.\,7.~2001}
\dpoversion{July 20, 2001}

%\chair{Lehrstuhl für Mikrooptik}
\chair{Laboratory for Micro-optics}

%\referees{Prof.\ Dr.\ Hans Zappe, Lehrstuhl für Mikrooptik\\
%               Prof.\ Dr.\ Zweitkorrektor, Lehrstuhl für Non-sense-research} 
\referees{Prof.\ Dr.\ Hans Zappe, Laboratory for Micro-optics}

\supervisor{Dipl.-Ing.\ Sven Sklaventreiber, Laboratory for Micro-optics\\}

%\thesistime{17.\ Juni 2010 bis 07.\ Januar 2011}
\thesistime{January~1, 2006 to May~31, 2006}

%% Ende Vorspann
