svilches/666_Thesis/20 Templates/Draft_Bachelor-Masterthesis_LATEX_english/parts/Nomenclature.tex

%%%%%%%%%%%%%%%%%%%%%%%%%%%%%%%%%%%%%%%%%%%%%%%%%%%%%%%%%%
%%                                                                                                             		                                      %%
%%                                                         Nomenklature																			%%
%%                                                                                                                                                       %%
%%%%%%%%%%%%%%%%%%%%%%%%%%%%%%%%%%%%%%%%%%%%%%%%%%%%%%%%%%

\begin{nomenclature}
%% To calc the width, the package \usepackage{calc}
%% has to be included

%------------------------------------------------------Lateinische Buchstaben
\section*{Latin letters}
\noindent
\begin{longtable}[l]{p{0.2\textwidth}p{0.7\textwidth-6\tabcolsep}p{0.1\textwidth}}
  \tabheadfont{variable}&\tabheadfont{meaning}&\tabheadfont{unit}\\\midrule\endhead
$A$ 			& area 								& $\unit{m^2}$\\
$w$    		& width 							& $\unit{m}$\\
$c$    		& concentration    		& wt.$\unit{\%}$\\
$d$ 			& diameter 						& $\unit{m}$\\
$G$ 			& Gibbs free enthalpy & $\unit{J}$\\
$h$ 			& height 							& $\unit{m}$\\
$l$ 			& length 							& $\unit{m}$\\
$m$ 			& mass 								& $\unit{kg}$\\
$p$ 			& pressure 						& $\unit{Pa}$\\
$r$			 	& radius    					& $\unit{m}$\\
$Re$ 			& Reynolds-number			&\\
$t$    		& time 				  			& $\unit{s}$\\
$V$ 			& volume 							& $\unit{m^3}$\\

%-------------------------------------------------------------Grichische Buchstaben
\end{longtable}
\section*{Greek letters}
\begin{longtable}[l]{p{0.2\textwidth}p{0.7\textwidth-6\tabcolsep}p{0.1\textwidth}}
  \tabheadfont{variable}&\tabheadfont{meaning}&\tabheadfont{unit}\\\midrule\endhead
  
$\alpha$  				& absorption coefficient & $\unit{1/m}$\\
$\gamma$ 			   	& surface tension & $\unitfrac{N}{m}$\\
$\eta$ 						& dynamic viscosity & $\unitfrac{Ns}{m^2}$\\
$\theta$ 					& contact angle & $\unit{\degree}$, $\unit{rad}$\\
$\kappa$ 				  & curvature & $\unitfrac{1}{m}$\\
$\lambda$    			& wave length    &    $\unit{m}$\\
$\nu$							& kinematic viscosity & $\unitfrac{m^2}{s}$\\
$\rho$ 					  & specific gravity & $\unitfrac{kg}{m^3}$\\
\end{longtable}
%-----------------------------------------------------------Indizes
\section*{Indices}

\begin{longtable}[l]{p{0.2\textwidth}p{0.8\textwidth-4\tabcolsep}}
  \tabheadfont{index}&\tabheadfont{meaning}\\\midrule\endhead
$lg$    			& liquid-gas\\
$sg$ 					& solid-gas\\
$sl$ 					& solid-liquid\\
$la$          & liquid-ambient\\
%$RB$         & Right Bottom \\
%$TL$         & Top Left \\

\end{longtable}

\section*{Abbreviations}
\begin{longtable}[l]{p{0.2\textwidth}p{0.8\textwidth-4\tabcolsep}}
  \tabheadfont{abbreviation}&\tabheadfont{meaning}\\\midrule\endhead
2D 						& 2-dimensional\\
AF            & amorphous fluoropolymer \\
DFR    				& dry film resist\\
DI 						& deionized ultra-pure water\\
%EW                   & Electrowetting \\
%EWOD              & Electrowetting on dielectric \\
%DEP                  & Dielectrophoresis \\
%DOF 					& Depth Of Focus\\
DRIE					& Deep reactive ion etching\\
%EDA 					& Electronic Design Automation\\
%FEM 					& Finite-Elemente-Methode\\
ICP						& Inductive coupled plasma\\
%ITO    				& Indiumzinnoxid\\
%LOC 					& Lab-On-A-Chip\\  
MEMS 					& Micro-electro-mechanical system\\  
%OMM 					& Optical Multimeter\\
%PCB 					& Printed Circuit Board\\  
PDMS 					& Polydimethylsiloxan\\  
%PE 					& Polyethylen\\  
PEB 					& Post Exposure Bake\\   
%PET    			& Polyethylenterephthalat\\  
PMMA    			& Polymethylmethacrylat\\  
%PV 					& Peak-Valley\\  
%REM 					& Rasterelektronenmikroskop\\
%SPP 					& Schwerpunktprogramm\\   
%UV 					& Ultraviolett\\
UV-Vis        & ultraviolet to visible wavelengths
\end{longtable}
\end{nomenclature}
