svilches/666_Thesis/10 LaTeX/figures/40_Fabrication/Assy/20161006 3D Printed Housing - Alignm/ClosedView.SLDASM

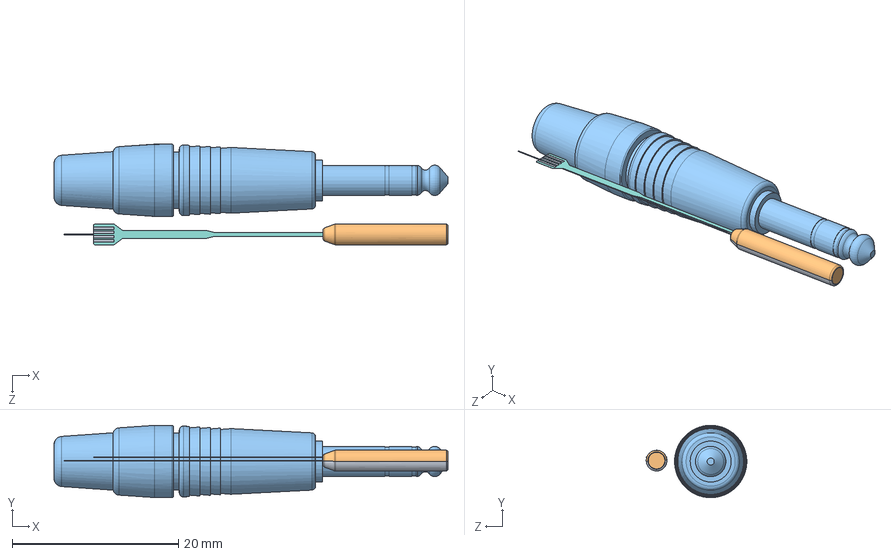
[picture p165: CAD file, 2017-02-28]
10 LaTeX/figures/40_Fabrication/Assy/20161006 3D Printed Housing - Alignm/ClosedView.SLDASM
47.4 x 8.71 x 12.1 mm
160406 PZT Tube 500_800um
20160422 80um Fiber
20160531 Silicon Holder Tip Round x 2
20160422 GRIN GT-LFRL-035-025-20-CC (1550)
20160422 Detailed Cuff
20160513 Roll Electrode
20160513 Roll Electrode Metal
20160531 Lens
Audio Jack small
