svilches/666_Thesis/10 LaTeX/figures/40_Fabrication/Assy/20161006 3D Printed Housing - Alignm/ExplodedView.SLDASM

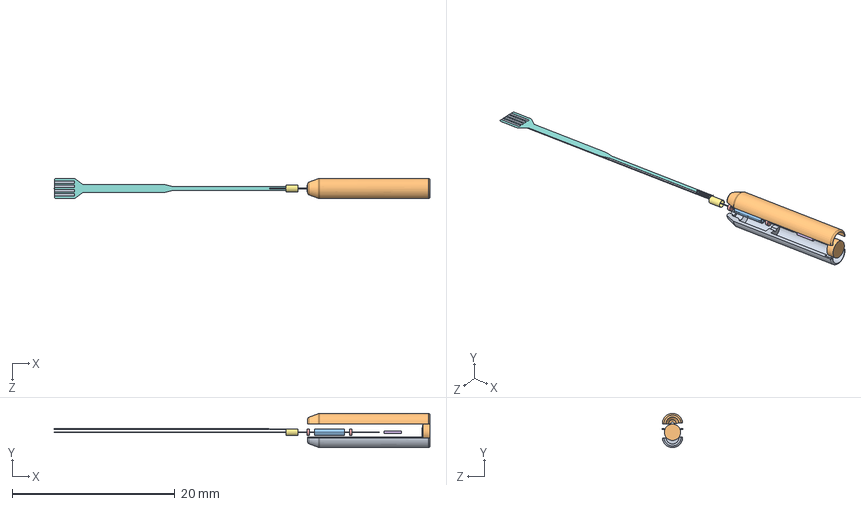
[picture p166: CAD file, 2017-01-20]
10 LaTeX/figures/40_Fabrication/Assy/20161006 3D Printed Housing - Alignm/ExplodedView.SLDASM
46.2 x 4.20 x 2.50 mm
20161006 3D Printed Housing Bot Alignm
20161006 3D Printed Housing Top Alignm
160406 PZT Tube 500_800um
20160422 80um Fiber
20160531 Silicon Holder Tip Round x 2
20160422 GRIN GT-LFRL-035-025-20-CC (1550)
20160422 Detailed Cuff
20160513 Roll Electrode
20160513 Roll Electrode Metal
20160531 Lens
