svilches/666_Thesis/10 LaTeX/figures/30_DesignSimulation/Silicon bench 2 lens cross section/Audio Jack small.SLDPRT

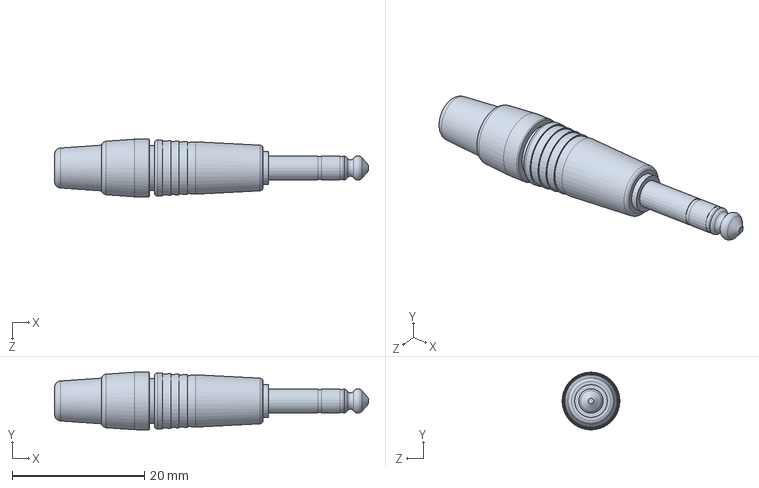
[picture p167: CAD file, 2017-02-28]
10 LaTeX/figures/30_DesignSimulation/Silicon bench 2 lens cross section/Audio Jack small.SLDPRT
47.4 x 8.71 x 8.70 mm
