svilches/666_Thesis/10 LaTeX/figures/30_DesignSimulation/Silicon bench 2 lens cross section/Audio Jack 0.25.SLDPRT

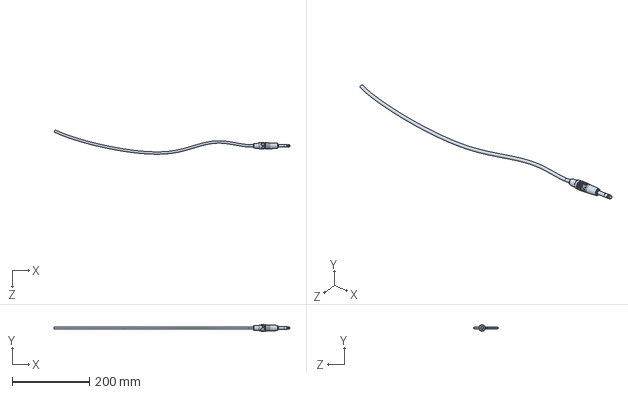
[picture p168: CAD file, 2017-02-28]
10 LaTeX/figures/30_DesignSimulation/Silicon bench 2 lens cross section/Audio Jack 0.25.SLDPRT
609.4 x 17.4 x 63.4 mm
