svilches/666_Thesis/10 LaTeX/figures/30_DesignSimulation/Silicon bench 2 lens cross section/Micro_Jack_3.5mm.STL

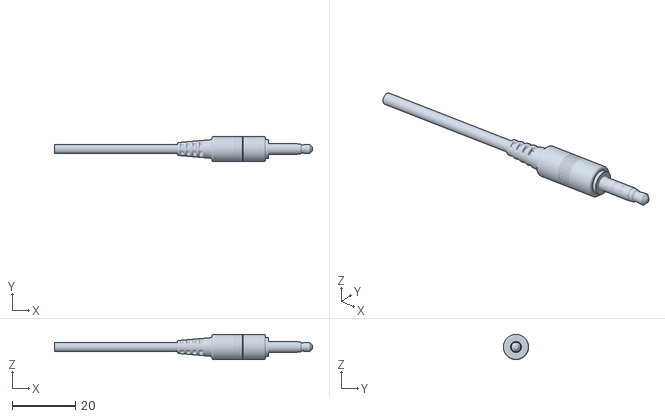
[picture p169: CAD file, 2017-02-28]
10 LaTeX/figures/30_DesignSimulation/Silicon bench 2 lens cross section/Micro_Jack_3.5mm.STL
81.9 x 7.99 x 8.00
