svilches/666_Thesis/10 LaTeX/figures/30_DesignSimulation/Silicon bench 2 lens cross section/20160615 Electrode.SLDASM

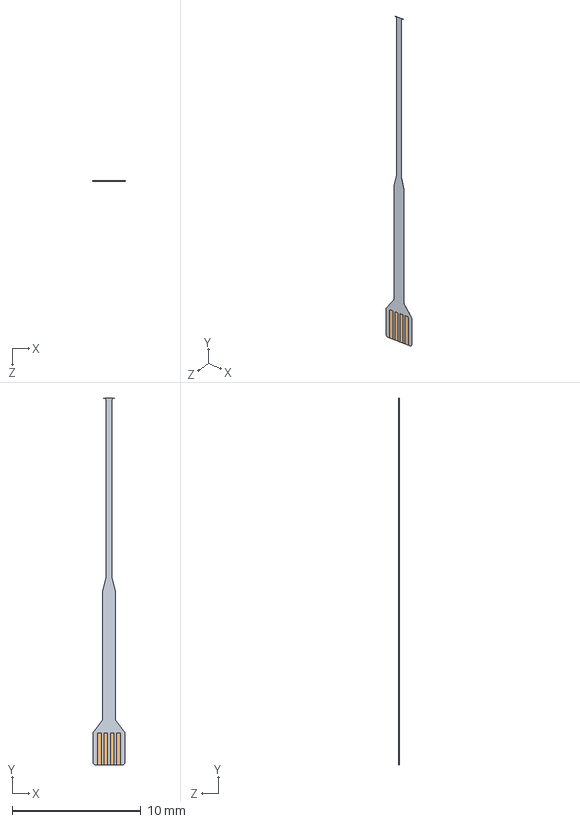
[picture p170: CAD file, 2017-03-31]
10 LaTeX/figures/30_DesignSimulation/Silicon bench 2 lens cross section/20160615 Electrode.SLDASM
2.50 x 28.5 x 0.01 mm
20160513 Roll Electrode
20160513 Roll Electrode Metal
