svilches/666_Thesis/10 LaTeX/figures/40_Fabrication/PI/20160615 Electrode.SLDASM

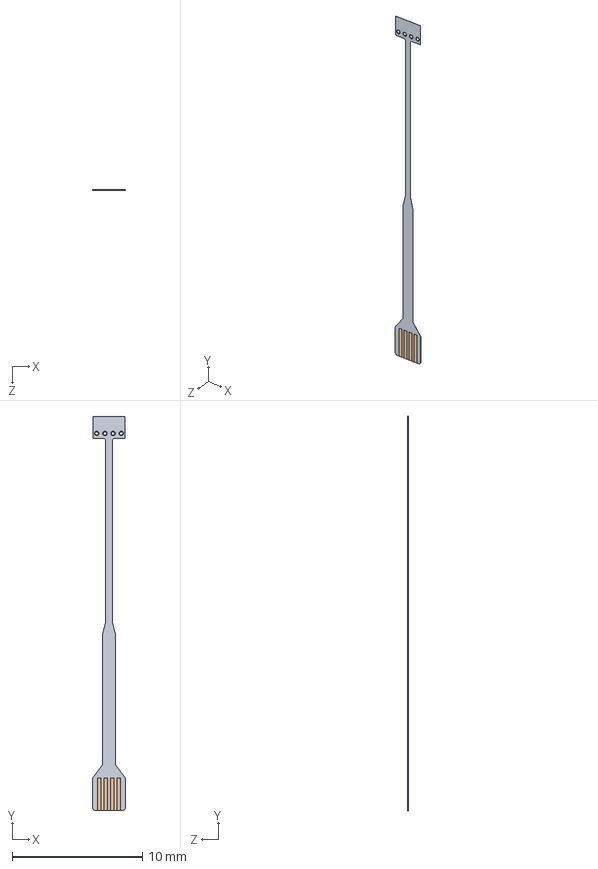
[picture p172: CAD file, 2017-01-25]
10 LaTeX/figures/40_Fabrication/PI/20160615 Electrode.SLDASM
2.50 x 30.2 x 0.01 mm
20160513 Roll Electrode
20160513 Roll Electrode Metal
