svilches/666_Thesis/10 LaTeX/figures/30_DesignSimulation/spiralScanning/20161213 Testbench Silicon Double Lens for Thesis/20161213 PZT Fiber GRIN.SLDASM

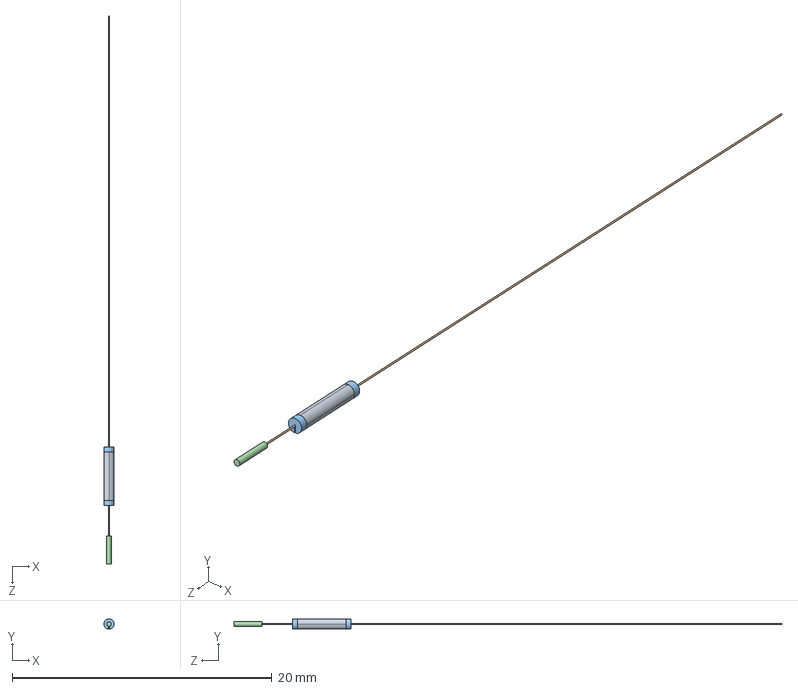
[picture p173: CAD file, 2016-12-14]
10 LaTeX/figures/30_DesignSimulation/spiralScanning/20161213 Testbench Silicon Double Lens for Thesis/20161213 PZT Fiber GRIN.SLDASM
0.8 x 0.8 x 42.2 mm
20161201 PZT Tube 500_800um
20160422 80um Fiber
20160722 Silicon Holder Tip Round x 2
20160422 GRIN GT-LFRL-035-025-20-CC (1550)
