svilches/666_Thesis/10 LaTeX/figures/40_Fabrication/Assy/20161006 3D Printed Housing - Alignm/20161006 PZT Scanner Fiber GRIN.SLDASM

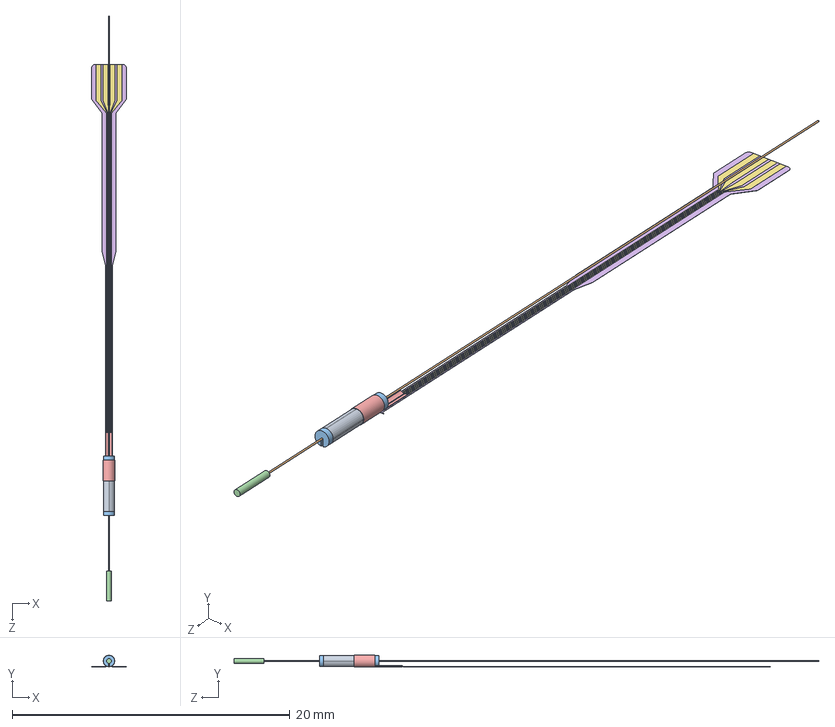
[picture p174: CAD file, 2017-02-28]
10 LaTeX/figures/40_Fabrication/Assy/20161006 3D Printed Housing - Alignm/20161006 PZT Scanner Fiber GRIN.SLDASM
2.50 x 0.831 x 42.2 mm
160406 PZT Tube 500_800um
20160422 80um Fiber
20160531 Silicon Holder Tip Round x 2
20160422 GRIN GT-LFRL-035-025-20-CC (1550)
20160422 Detailed Cuff
20160513 Roll Electrode
20160513 Roll Electrode Metal
