svilches/666_Thesis/10 LaTeX/figures/30_DesignSimulation/Silicon bench 2 lens cross section/20160531 PZT Tube Assemblying Tool.SLDASM

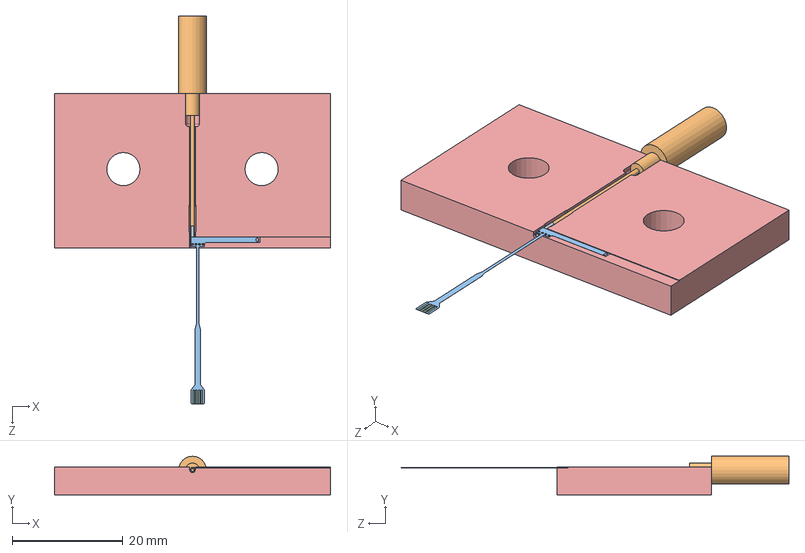
[picture p175: CAD file, 2017-03-27]
10 LaTeX/figures/30_DesignSimulation/Silicon bench 2 lens cross section/20160531 PZT Tube Assemblying Tool.SLDASM
50.0 x 7.00 x 70.2 mm
160406 PZT Tube 500_800um
20160512 Needle 0.8mm
20160513 Roll Electrode
20160513 Roll Electrode Metal
20160531 Block
