svilches/666_Thesis/10 LaTeX/figures/30_DesignSimulation/spiralScanning/20161213 Testbench Silicon Double Lens for Thesis/20160722 Lens Prism BS Lens.SLDASM

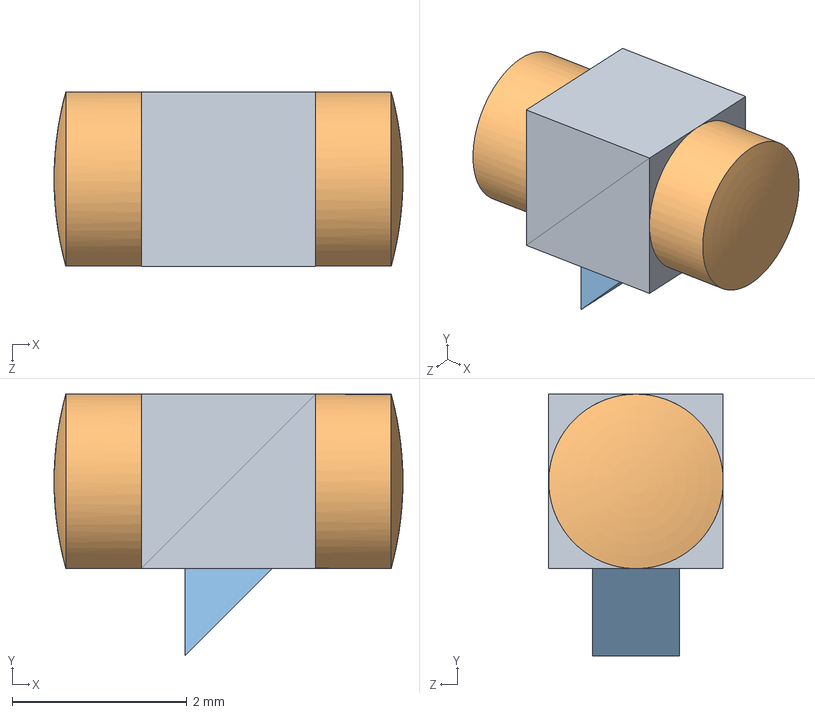
[picture p176: CAD file, 2016-12-08]
10 LaTeX/figures/30_DesignSimulation/spiralScanning/20161213 Testbench Silicon Double Lens for Thesis/20160722 Lens Prism BS Lens.SLDASM
4.00 x 3.00 x 2.00 mm
20160531 Beamsplitter x 2
20160531 Lens x 2
20160531 Prism
