svilches/666_Thesis/10 LaTeX/figures/40_Fabrication/Assy/20161006 3D Printed Housing - Alignm/20161006 3D Printed Probe Assy Alignm.SLDASM

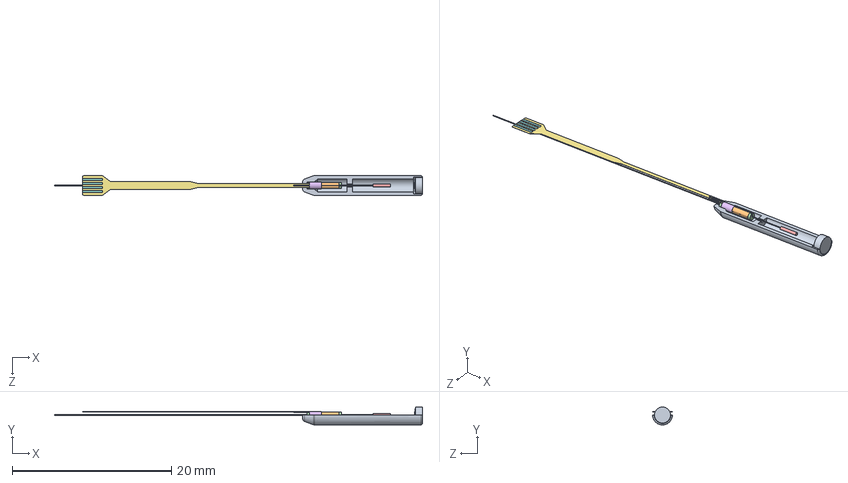
[picture p177: CAD file, 2017-01-20]
10 LaTeX/figures/40_Fabrication/Assy/20161006 3D Printed Housing - Alignm/20161006 3D Printed Probe Assy Alignm.SLDASM
46.2 x 2.25 x 2.50 mm
20161006 3D Printed Housing Bot Alignm
160406 PZT Tube 500_800um
20160422 80um Fiber
20160531 Silicon Holder Tip Round x 2
20160422 GRIN GT-LFRL-035-025-20-CC (1550)
20160422 Detailed Cuff
20160513 Roll Electrode
20160513 Roll Electrode Metal
20160531 Lens
