svilches/666_Thesis/10 LaTeX/figures/30_DesignSimulation/Silicon bench 2 lens cross section/20161201 Testbench Silicon Double Lens Jack.SLDASM

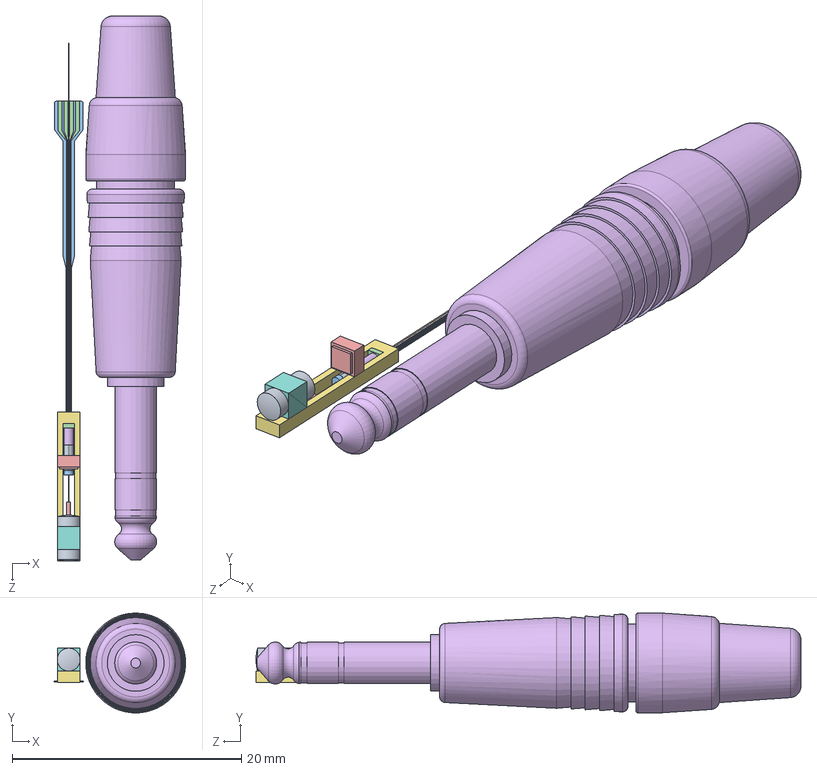
[picture p178: CAD file, 2017-02-28]
10 LaTeX/figures/30_DesignSimulation/Silicon bench 2 lens cross section/20161201 Testbench Silicon Double Lens Jack.SLDASM
11.4 x 8.71 x 47.5 mm
20161201 PZT Tube 500_800um
20160422 80um Fiber
20160722 Silicon Holder Tip Round
20160531 Silicon Holder Base
20160422 GRIN GT-LFRL-035-025-20-CC (1550)
20160422 Detailed Cuff
20160531 Bench
20160531 Beamsplitter x 2
20160531 Lens x 2
20160531 Prism
20160513 Roll Electrode
20160513 Roll Electrode Metal
20161201 CMOS Sensor
Audio Jack small
