svilches/666_Thesis/10 LaTeX/figures/40_Fabrication/Assy/20161006 3D Printed Housing - Alignm/20161006 3D Printed Housing Top Alignm.SLDPRT

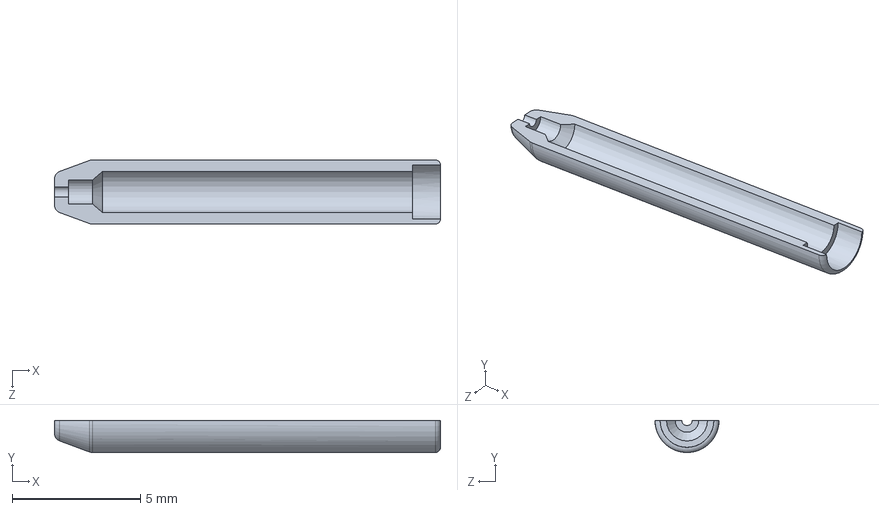
[picture p179: CAD file, 2017-02-28]
10 LaTeX/figures/40_Fabrication/Assy/20161006 3D Printed Housing - Alignm/20161006 3D Printed Housing Top Alignm.SLDPRT
15.0 x 1.25 x 2.50 mm
