svilches/666_Thesis/10 LaTeX/figures/30_DesignSimulation/Silicon bench 2 lens cross section/20160513 Roll Electrode Metal.SLDPRT

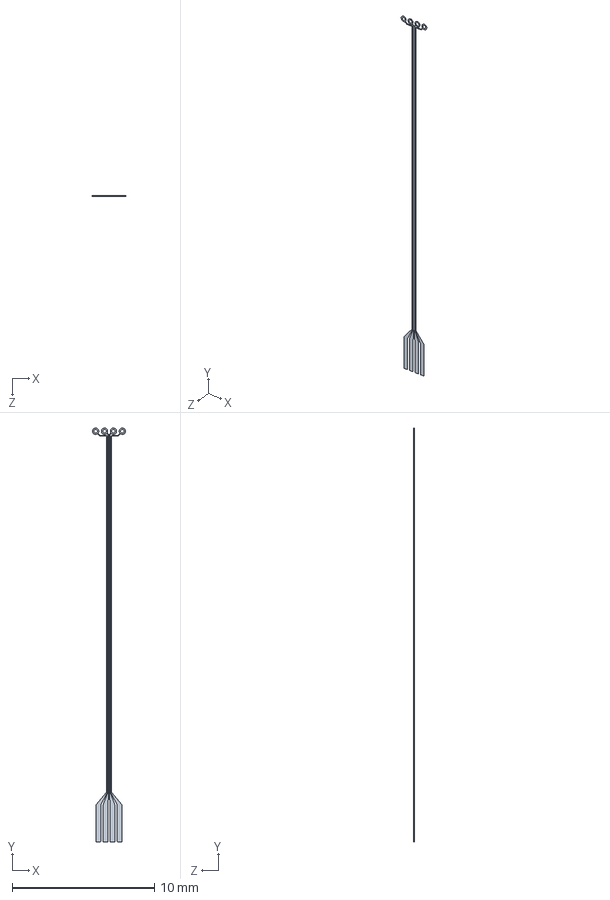
[picture p180: CAD file, 2017-03-31]
10 LaTeX/figures/30_DesignSimulation/Silicon bench 2 lens cross section/20160513 Roll Electrode Metal.SLDPRT
2.33 x 29.1 x 0.001 mm
