svilches/666_Thesis/10 LaTeX/figures/30_DesignSimulation/Silicon bench 2 lens cross section/20160513 Roll Electrode.SLDPRT

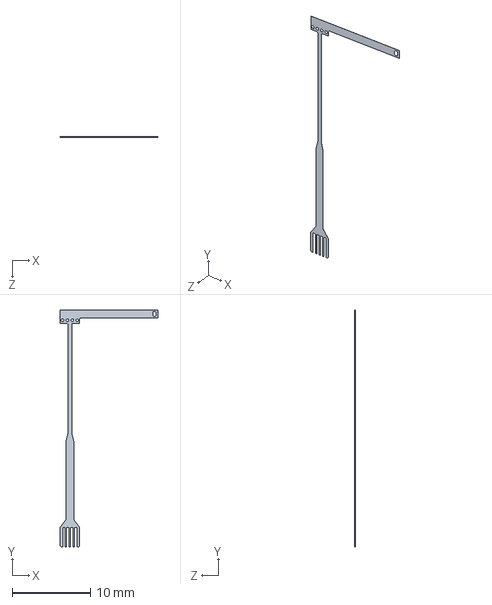
[picture p181: CAD file, 2017-03-31]
10 LaTeX/figures/30_DesignSimulation/Silicon bench 2 lens cross section/20160513 Roll Electrode.SLDPRT
12.5 x 30.2 x 0.01 mm
