svilches/666_Thesis/(list of files, cad)

Other CAD files:
10 LaTeX/figures/30_DesignSimulation/spiralScanning/20161213 Testbench Silicon Double Lens for Thesis/20160615 Electrode.SLDASM
10 LaTeX/figures/30_DesignSimulation/Optical/Backreflections/20161201 Testbench Silicon Double Lens.SLDDRW
10 LaTeX/figures/30_DesignSimulation/Optical/drawingMeasurements.SLDDRW
10 LaTeX/figures/30_DesignSimulation/Silicon bench 2 lens cross section/20160422 80um Fiber.SLDPRT
10 LaTeX/figures/30_DesignSimulation/Silicon bench 2 lens cross section/20160422 GRIN GT-LFRL-035-025-20-CC (1550) .SLDPRT
10 LaTeX/figures/30_DesignSimulation/Silicon bench 2 lens cross section/20160531 Bench.SLDPRT
10 LaTeX/figures/30_DesignSimulation/Silicon bench 2 lens cross section/20160531 Lens.SLDPRT
10 LaTeX/figures/30_DesignSimulation/Silicon bench 2 lens cross section/20160531 Silicon Holder Base.SLDPRT
10 LaTeX/figures/30_DesignSimulation/Silicon bench 2 lens cross section/20160722 Silicon Holder Tip Round.SLDPRT
10 LaTeX/figures/30_DesignSimulation/spiralScanning/20161213 Testbench Silicon Double Lens for Thesis/20160422 Detailed Cuff.sldprt
10 LaTeX/figures/30_DesignSimulation/spiralScanning/20161213 Testbench Silicon Double Lens for Thesis/20160531 Beamsplitter.SLDPRT
10 LaTeX/figures/30_DesignSimulation/spiralScanning/20161213 Testbench Silicon Double Lens for Thesis/20160531 Bench.SLDPRT
10 LaTeX/figures/30_DesignSimulation/spiralScanning/20161213 Testbench Silicon Double Lens for Thesis/20160531 Lens.SLDPRT
10 LaTeX/figures/30_DesignSimulation/spiralScanning/20161213 Testbench Silicon Double Lens for Thesis/20160531 Prism.SLDPRT
10 LaTeX/figures/30_DesignSimulation/spiralScanning/20161213 Testbench Silicon Double Lens for Thesis/20161201 CMOS Sensor.SLDPRT
10 LaTeX/figures/30_DesignSimulation/spiralScanning/20161213 Testbench Silicon Double Lens for Thesis/20161201 PZT Tube 500_800um.SLDPRT
10 LaTeX/figures/30_DesignSimulation/spiralScanning/20161213 Testbench Silicon Double Lens for Thesis/20161201 Testbench Silicon Double Lens.SLDDRW
10 LaTeX/figures/30_DesignSimulation/spiralScanning/20161213 Testbench Silicon Double Lens for Thesis/20161213 PZT Fiber GRIN.SLDDRW
10 LaTeX/figures/40_Fabrication/Assy/20161006 3D Printed Housing - Alignm/160406 PZT Tube 500_800um.SLDPRT
10 LaTeX/figures/40_Fabrication/Assy/20161006 3D Printed Housing - Alignm/20160422 80um Fiber.SLDPRT
10 LaTeX/figures/40_Fabrication/Assy/20161006 3D Printed Housing - Alignm/20160422 GRIN GT-LFRL-035-025-20-CC (1550) .SLDPRT
10 LaTeX/figures/40_Fabrication/Assy/20161006 3D Printed Housing - Alignm/20160531 Lens.SLDPRT
10 LaTeX/figures/40_Fabrication/Assy/20161006 3D Printed Housing - Alignm/20161006 3D Printed Housing Bot Alignm.SLDPRT
10 LaTeX/figures/40_Fabrication/Assy/20161006 3D Printed Housing - Alignm/TopDrawing.SLDDRW
