svilches/666_Thesis/10 LaTeX/figures/40_Fabrication/Assy/exploded.pdf

a)

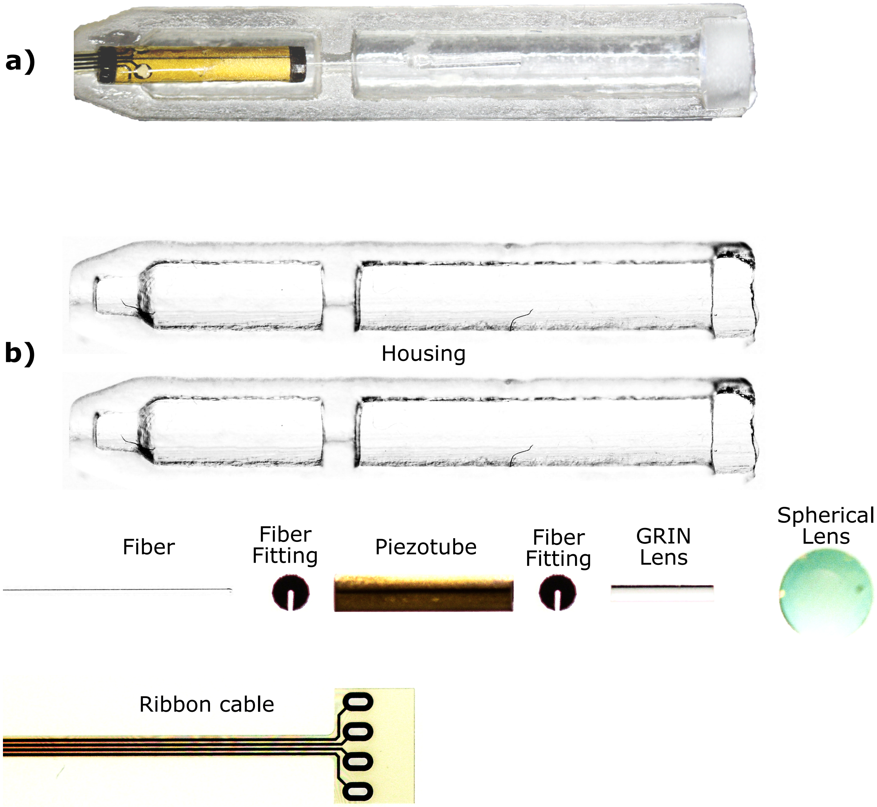
[picture p185: page 1]

Fiber | Piezotube

Spherical
GRIN | Lens
Lens

Fiber
Fitting

Fiber
Fitting

Ribbon cable

Housing

b)
