svilches/666_Thesis/70 Paper/00 Templates, Guidelines/IOPLaTeXGuidelines.tex

%%%%%%%%%%%%%%%%%%%%%%%%%%%%%%%%%%%%%%%%%%%%%%%%%%%%%%%%%%%%%%%%%%%%%%%%
%    INSTITUTE OF PHYSICS PUBLISHING                                   %
%                                                                      %
%   `Preparing an article for publication in an Institute of Physics   %
%    Publishing journal using LaTeX'                                   %
%                                                                      %
%    LaTeX source code `ioplau2e.tex' used to generate `author         %
%    guidelines', the documentation explaining and demonstrating use   %
%    of the Institute of Physics Publishing LaTeX preprint files       %
%    `iopart.cls, iopart12.clo and iopart10.clo'.                      %
%                                                                      %
%    `ioplau2e.tex' itself uses LaTeX with `iopart.cls'                %
%                                                                      %
%%%%%%%%%%%%%%%%%%%%%%%%%%%%%%%%%%
%
%
% First we have a character check
%
% ! exclamation mark    " double quote  
% # hash                ` opening quote (grave)
% & ampersand           ' closing quote (acute)
% $ dollar              % percent       
% ( open parenthesis    ) close paren.  
% - hyphen              = equals sign
% | vertical bar        ~ tilde         
% @ at sign             _ underscore
% { open curly brace    } close curly   
% [ open square         ] close square bracket
% + plus sign           ; semi-colon    
% * asterisk            : colon
% < open angle bracket  > close angle   
% , comma               . full stop
% ? question mark       / forward slash 
% \ backslash           ^ circumflex
%
% ABCDEFGHIJKLMNOPQRSTUVWXYZ 
% abcdefghijklmnopqrstuvwxyz 
% 1234567890
%
%%%%%%%%%%%%%%%%%%%%%%%%%%%%%%%%%%%%%%%%%%%%%%%%%%%%%%%%%%%%%%%%%%%
%
\documentclass[10pt]{iopart}
\newcommand{\gguide}{{\it Preparing graphics for IOP Publishing journals}}
%Uncomment next line if AMS fonts required
%\usepackage{iopams}  
\begin{document}

\title[Title on header]{Title in cover}

\author{Content \& Services Team}

\address{IOP Publishing, Temple Circus, Temple Way, Bristol BS1 6HG, UK}
\ead{submissions@iop.org}
\vspace{10pt}
\begin{indented}
\item[]February 2014
\end{indented}

\begin{abstract}
Abstract

\end{abstract}
% Uncomment for PACS numbers
%\pacs{00.00, 20.00, 42.10}
%
% Uncomment for keywords
%\vspace{2pc}
%\noindent{\it Keywords}: XXXXXX, YYYYYYYY, ZZZZZZZZZ
%
% Uncomment for Submitted to journal title message
%\submitto{\JPA}
%
% Uncomment if a separate title page is required
%\maketitle
% 
% For two-column output uncomment the next line and choose [10pt] rather than [12pt] in the \documentclass declaration
\ioptwocol
%

\section{Introduction: file preparation and submission}

\end{document}
