svilches/666_Thesis/10 LaTeX/figures/40_Fabrication/Housing/grinAlignment.pdf

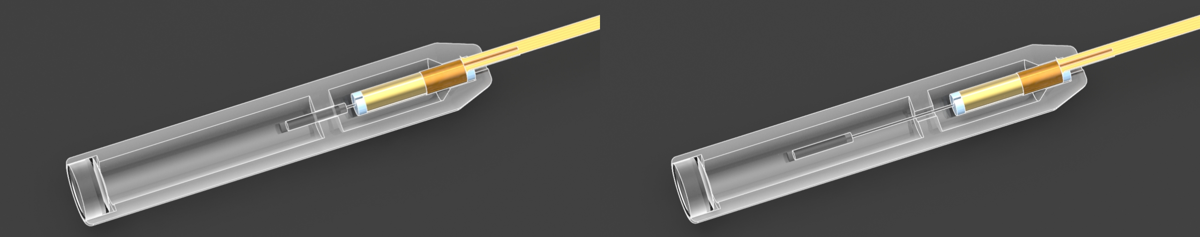
[picture p186: page 1]
