svilches/666_Thesis/10 LaTeX/figures/40_Fabrication/Assy/explodedRender/explodedRenderTitle.pdf

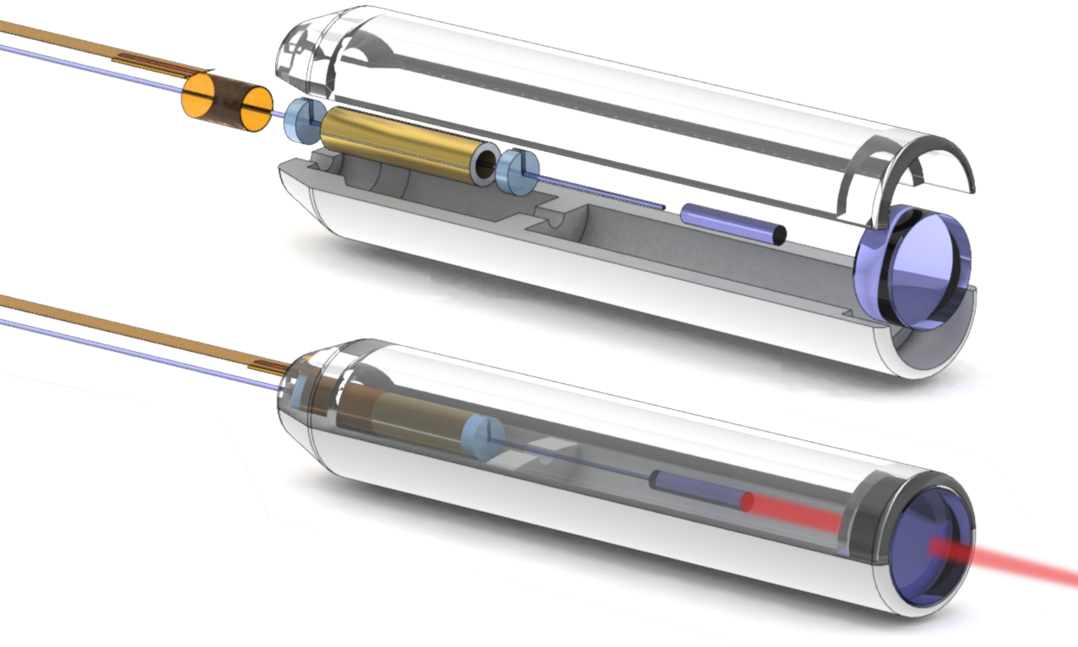
[picture p187: page 1]
