svilches/666_Thesis/10 LaTeX/figures/40_Fabrication/Assy/explodedRender/explodedRender.pdf

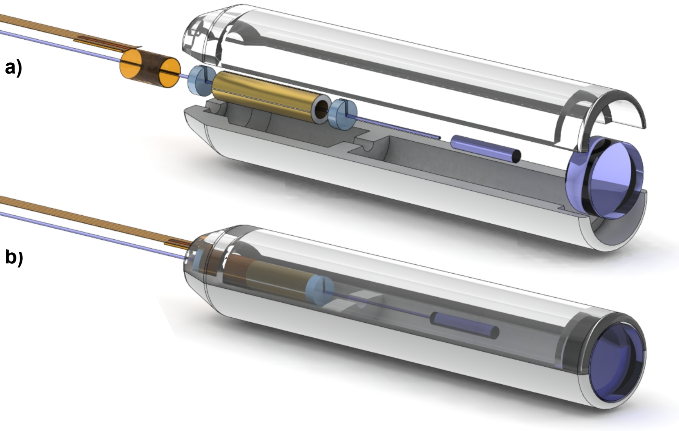
[picture p188: page 1]

a)

b)
