svilches/666_Thesis/10 LaTeX/figures/40_Fabrication/assembly.PNG

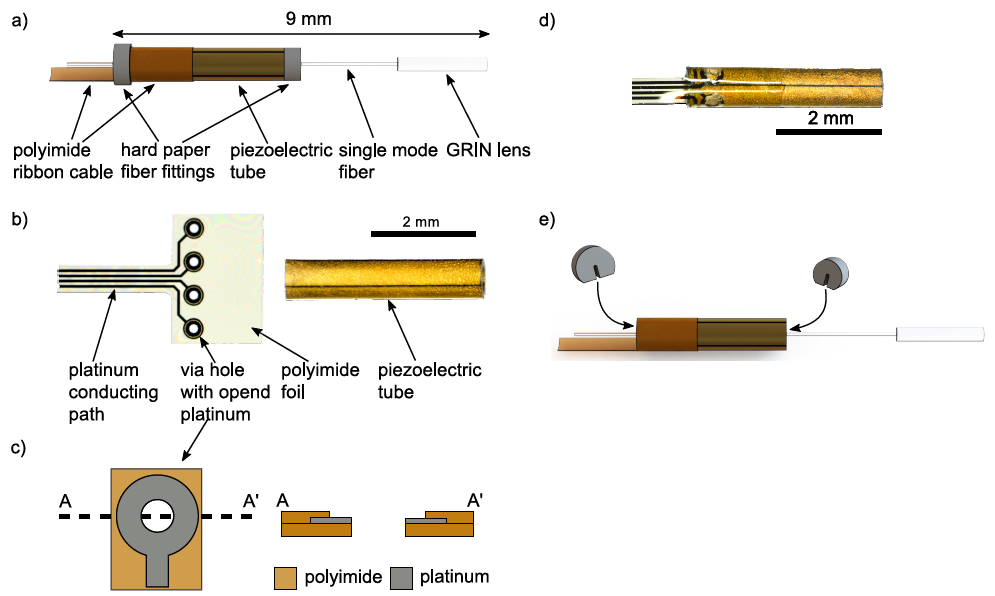
10 LaTeX/figures/40_Fabrication/assembly.PNG
