svilches/666_Thesis/10 LaTeX/figures/40_Fabrication/Assy/20161006 3D Printed Housing - Alignm/renders/07.JPG

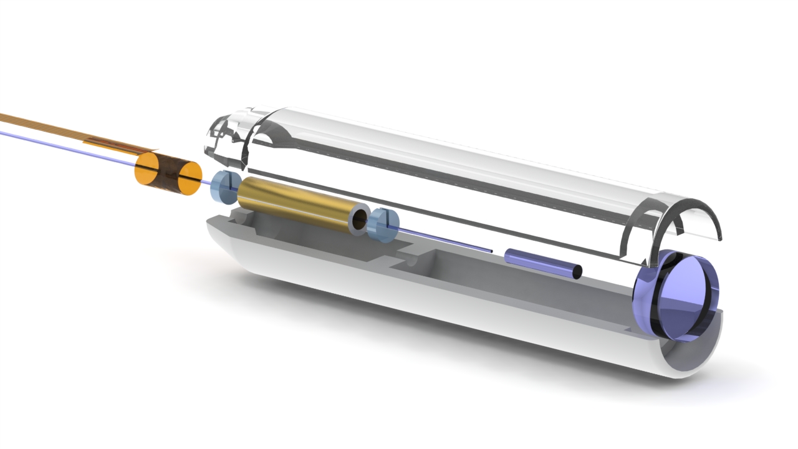
10 LaTeX/figures/40_Fabrication/Assy/20161006 3D Printed Housing - Alignm/renders/07.JPG
