svilches/666_Thesis/10 LaTeX/figures/40_Fabrication/Assy/DSC_0972.jpg

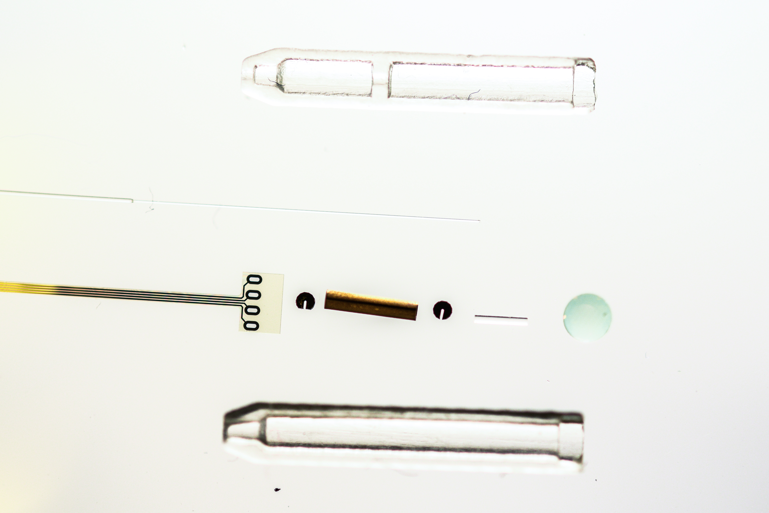
10 LaTeX/figures/40_Fabrication/Assy/DSC_0972.jpg
