svilches/666_Thesis/10 LaTeX/figures/40_Fabrication/Assy/exploded.png

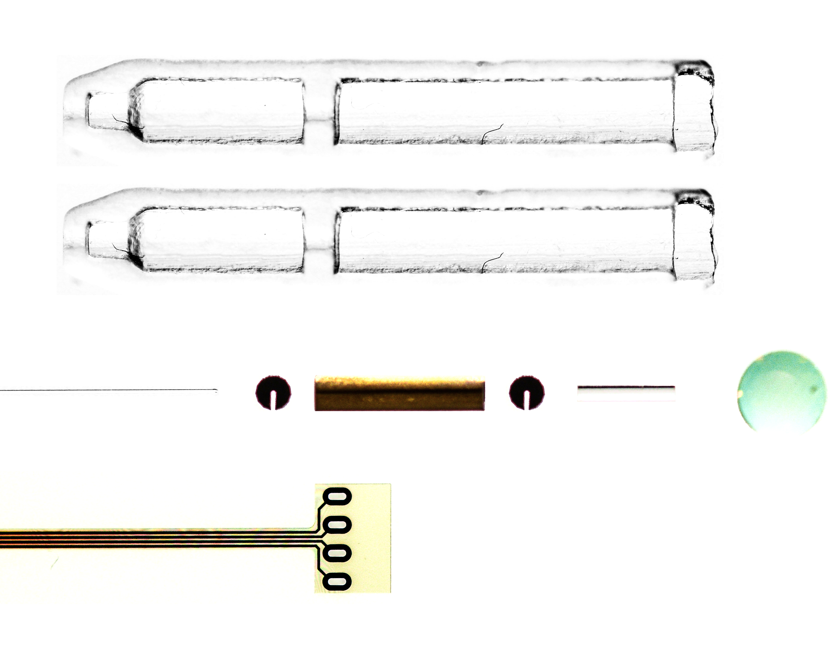
10 LaTeX/figures/40_Fabrication/Assy/exploded.png
