svilches/666_Thesis/10 LaTeX/figures/40_Fabrication/PI/renders/01.JPG

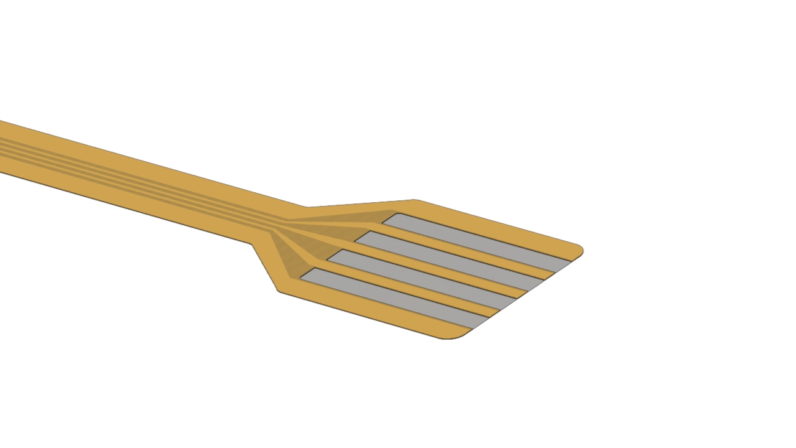
10 LaTeX/figures/40_Fabrication/PI/renders/01.JPG
