svilches/666_Thesis/10 LaTeX/figures/40_Fabrication/PI/tubeFoil.png

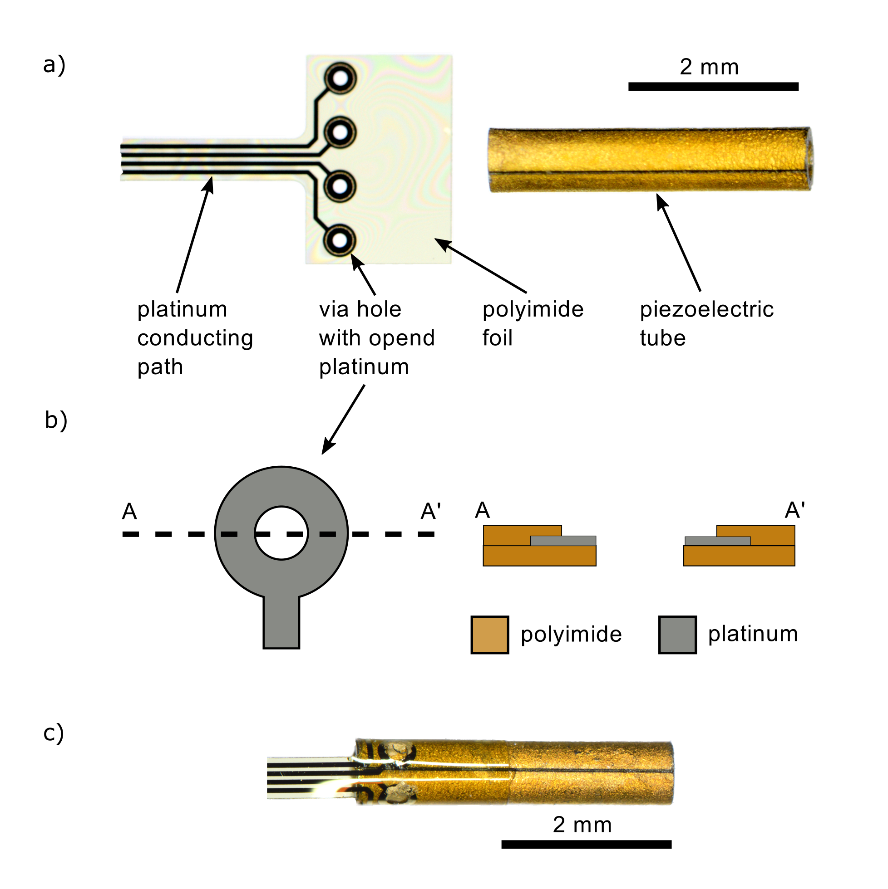
10 LaTeX/figures/40_Fabrication/PI/tubeFoil.png
