svilches/666_Thesis/10 LaTeX/figures/40_Fabrication/PI/via.jpg

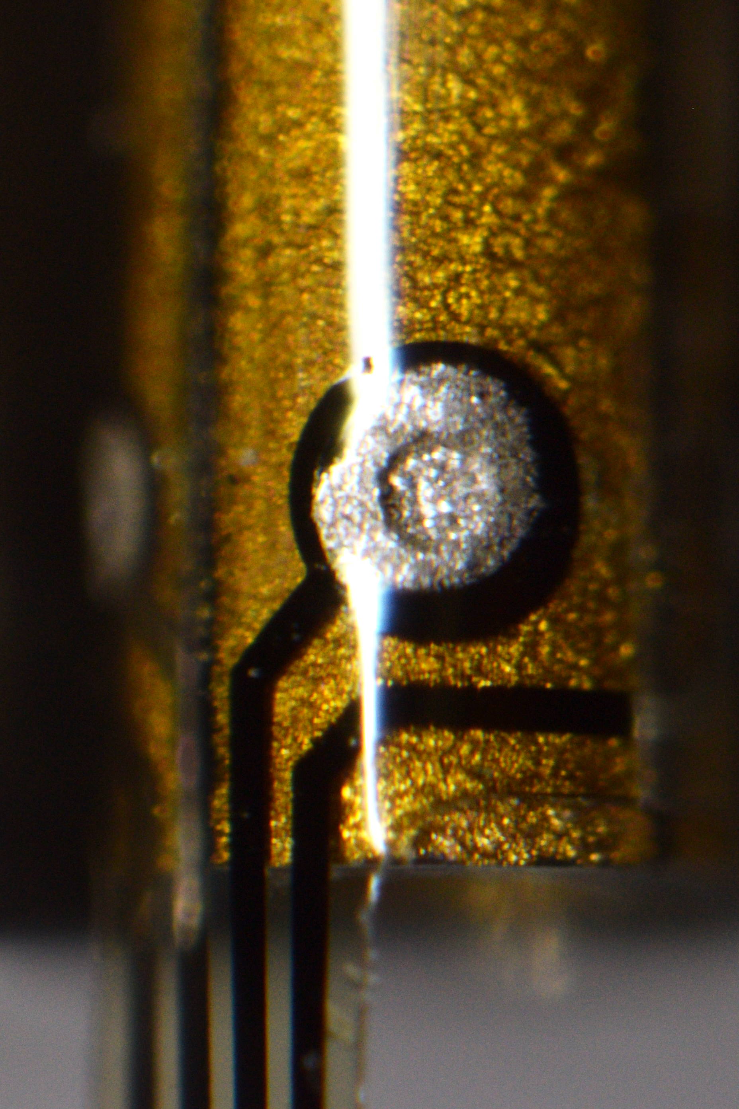
10 LaTeX/figures/40_Fabrication/PI/via.jpg
