svilches/666_Thesis/10 LaTeX/figures/50_Measurements/oct/OCT_Measurement_arrangement.pdf

## sample

a)

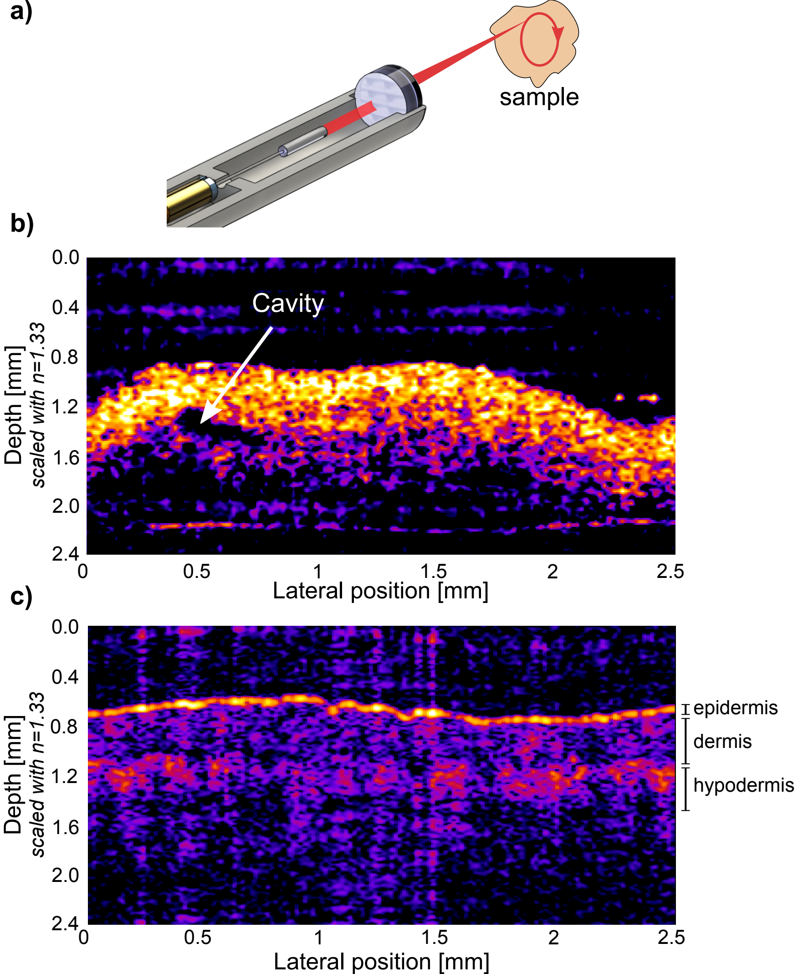
[picture p202: page 1]

### Lateral position [mm]

### Lateral position [mm]

0 | 0.5 | 1 | 1.5 | 2 | 2.5
0 | 0.5 | 1 | 1.5 | 2 | 2.5

0.0

0.4

0.8

1.2

1.6

2.0

2.4

### Depth [mm]

scaled with n=1.33

0.0

0.4

0.8

1.2

1.6

2.0

2.4

### Depth [mm]

scaled with n=1.33

b)

c)

## Cavity

epidermis
dermis

hypodermis
