svilches/666_Thesis/10 LaTeX/figures/50_Measurements/oct/Measurement_arrangement.pdf

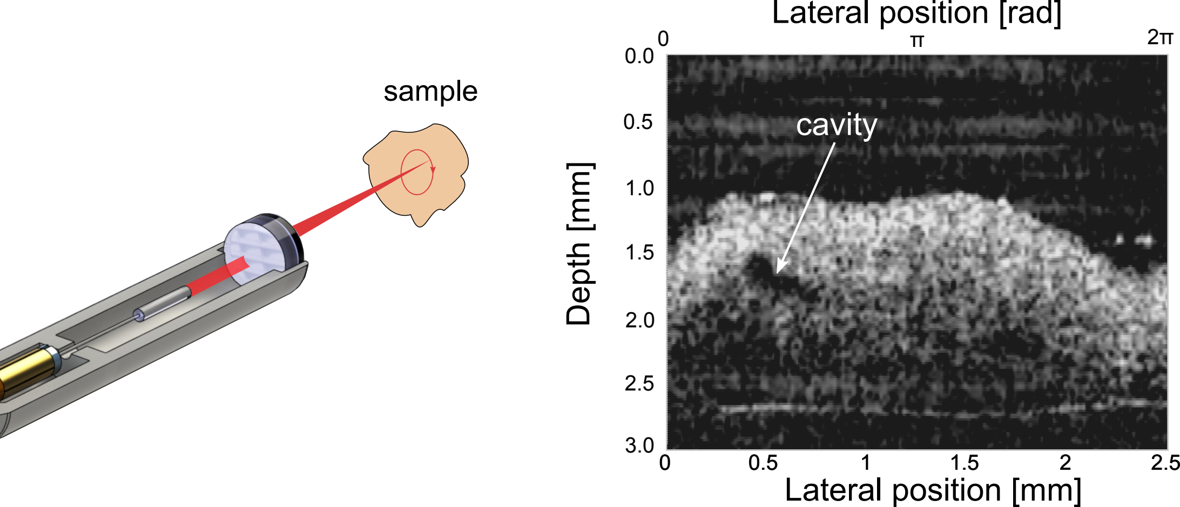
[picture p203: page 1]

sample

0.0

0.5

1.0

1.5

2.0

2.5

3.0
0 | 0.5 | 1 | 1.5 | 2 | 2.5
0 | π | 2π

Lateral position [mm]

Lateral position [rad]

Depth [mm]

cavity
