svilches/666_Thesis/20 Templates/Draft_Bachelor-Masterthesis_LATEX_english/chapters/Measurements.tex

% -*- encoding: UTF8 -*-
%
%%*****************************************************************************
%---------------------------------------Measurement Results --------------------------------------
%%*****************************************************************************
%
\chapter{Measurements}
\label{Ch:Results}	

Here could be an overview of the kinds of measurements that were done.

%--------------------------------------------In-vitro Measurements -----------------------------------------------

\section{In-vitro Measurements}
Donaudampfschiffkapitän Donaudampfschiffkapitän Donaudampfschiffkapitän Donaudampfschiffkapitän Donaudampfschiffkapitän Donaudampfschiffkapitän
Donaudampfschiffkapitän Donaudampfschiffkapitän Donaudampfschiffkapitän Donaudampfschiffkapitän Donaudampfschiffkapitän Donaudampfschiffkapitän 
Donaudampfschiffkapitän Donaudampfschiffkapitän Donaudampfschiffkapitän Donaudampfschiffkapitän Donaudampfschiffkapitän Donaudampfschiffkapitän 
Donaudampfschiffkapitän Donaudampfschiffkapitän Donaudampfschiffkapitän Donaudampfschiffkapitän Donaudampfschiffkapitän Donaudampfschiffkapitän 
Donaudampfschiffkapitän Donaudampfschiffkapitän Donaudampfschiffkapitän Donaudampfschiffkapitän Donaudampfschiffkapitän Donaudampfschiffkapitän 
Donaudampfschiffkapitän Donaudampfschiffkapitän Donaudampfschiffkapitän Donaudampfschiffkapitän Donaudampfschiffkapitän Donaudampfschiffkapitän 
Donaudampfschiffkapitän Donaudampfschiffkapitän Donaudampfschiffkapitän Donaudampfschiffkapitän Donaudampfschiffkapitän Donaudampfschiffkapitän 
Donaudampfschiffkapitän Donaudampfschiffkapitän Donaudampfschiffkapitän Donaudampfschiffkapitän Donaudampfschiffkapitän Donaudampfschiffkapitän 
Donaudampfschiffkapitän

\section{In-vivo Measurements}
To test the function of the system in an organism, measurements with a domestic pig were done. These tests were allowed by the ethnical commitee of the University Medical Center and the Ethnics Approval can be found in the Appendix...
