svilches/666_Thesis/10 LaTeX/figures/50_Measurements/bode/bodeGain.pdf

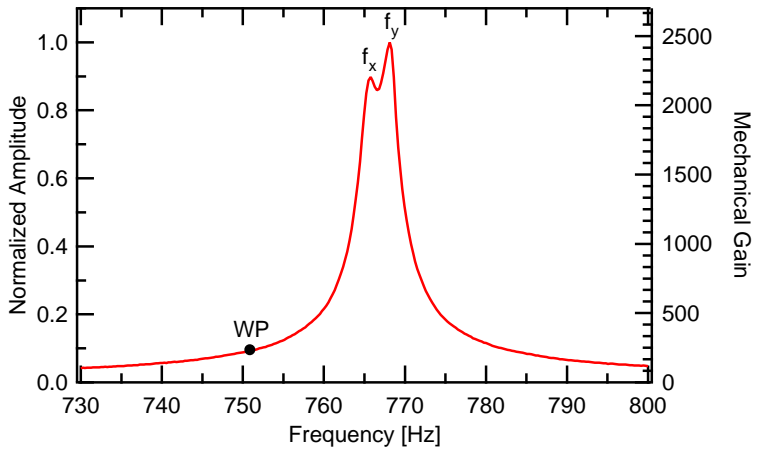
[picture p204: figure]
Normalized Amplitude; Frequency [Hz]; Mechanical Gain
