svilches/666_Thesis/10 LaTeX/figures/50_Measurements/bode/750.bmp

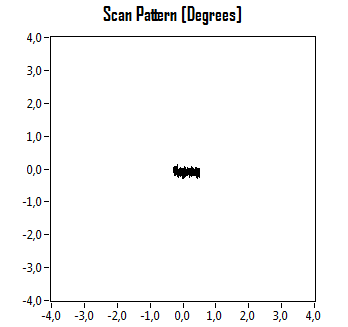
10 LaTeX/figures/50_Measurements/bode/750.bmp
