svilches/666_Thesis/10 LaTeX/figures/50_Measurements/bode/765.bmp

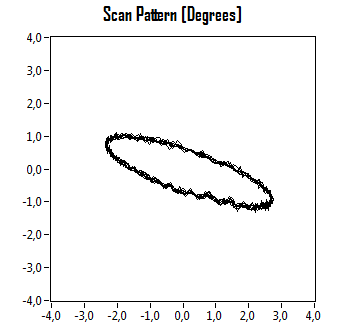
10 LaTeX/figures/50_Measurements/bode/765.bmp
