svilches/666_Thesis/10 LaTeX/figures/50_Measurements/bode/770.bmp

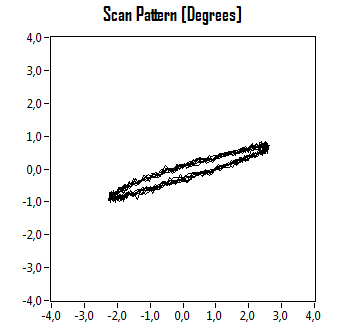
10 LaTeX/figures/50_Measurements/bode/770.bmp
