svilches/666_Thesis/10 LaTeX/figures/50_Measurements/bode/bodeWhirl.png

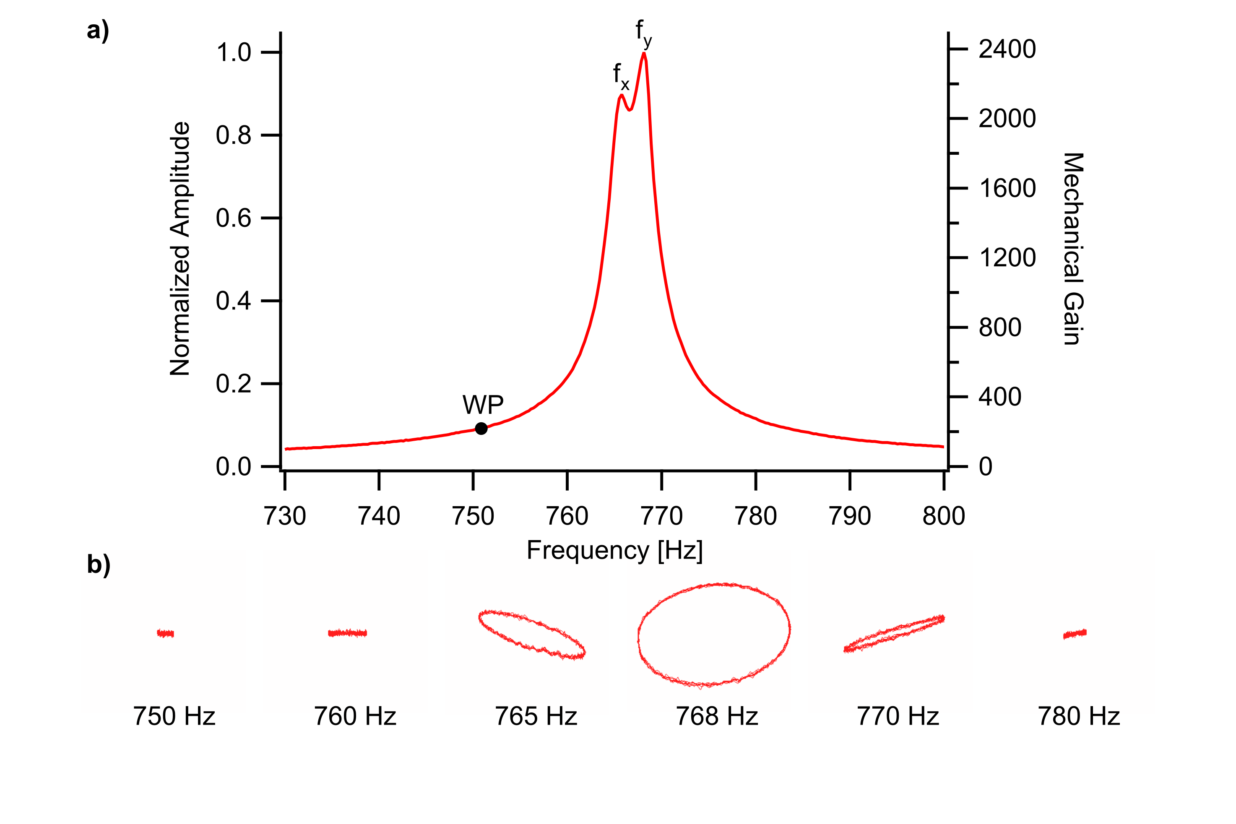
10 LaTeX/figures/50_Measurements/bode/bodeWhirl.png
