svilches/666_Thesis/10 LaTeX/figures/50_Measurements/conf/proc/20161215 ScanConfig A 91000 749 2 1mm.bmp

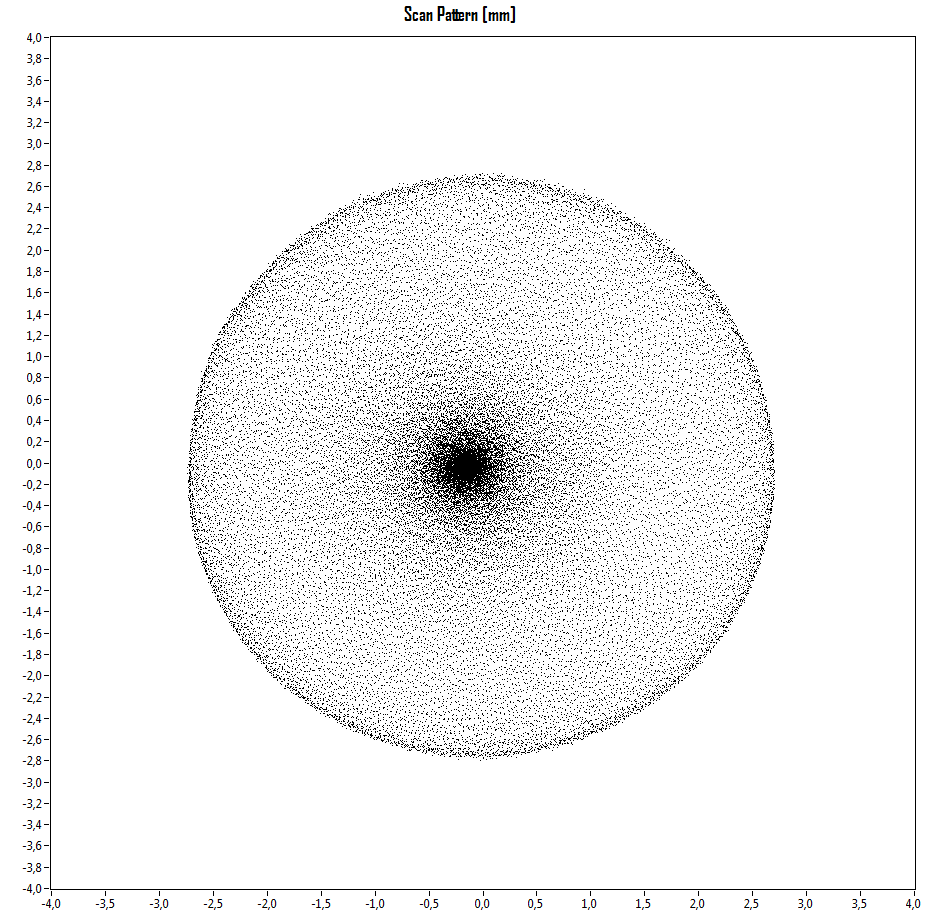
10 LaTeX/figures/50_Measurements/conf/proc/20161215 ScanConfig A 91000 749 2 1mm.bmp
