svilches/666_Thesis/10 LaTeX/figures/50_Measurements/conf/proc/matlab/blue interp.png

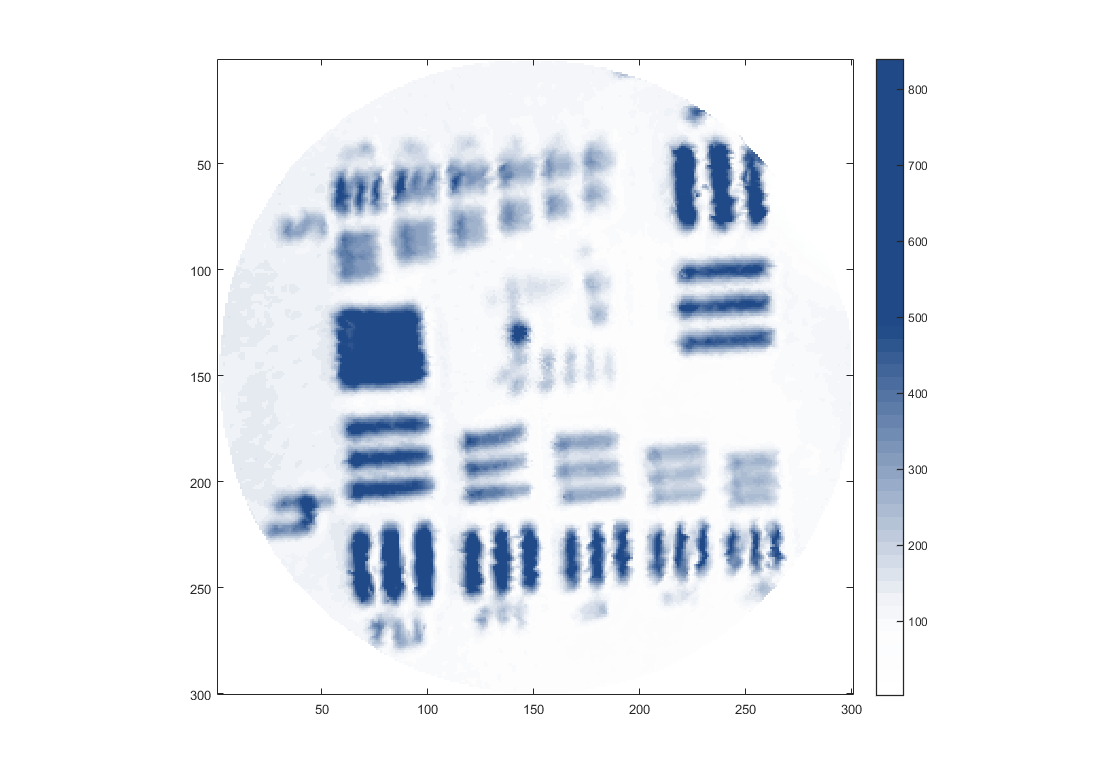
10 LaTeX/figures/50_Measurements/conf/proc/matlab/blue interp.png
