svilches/666_Thesis/10 LaTeX/figures/50_Measurements/conf/proc/USAF_interp.png

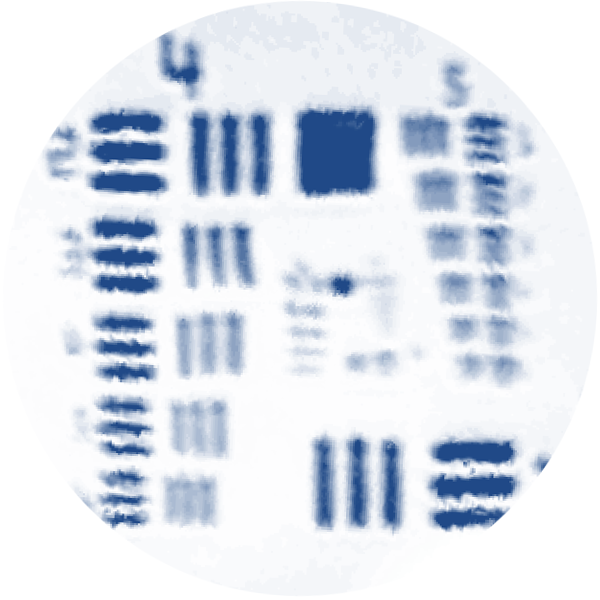
10 LaTeX/figures/50_Measurements/conf/proc/USAF_interp.png
