svilches/666_Thesis/10 LaTeX/figures/50_Measurements/oct/finger.PNG

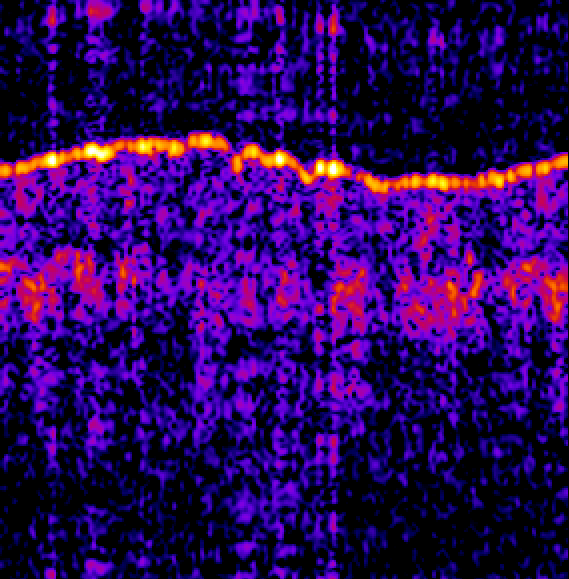
10 LaTeX/figures/50_Measurements/oct/finger.PNG
