svilches/666_Thesis/10 LaTeX/figures/50_Measurements/oct/Measurement_arrangement.png

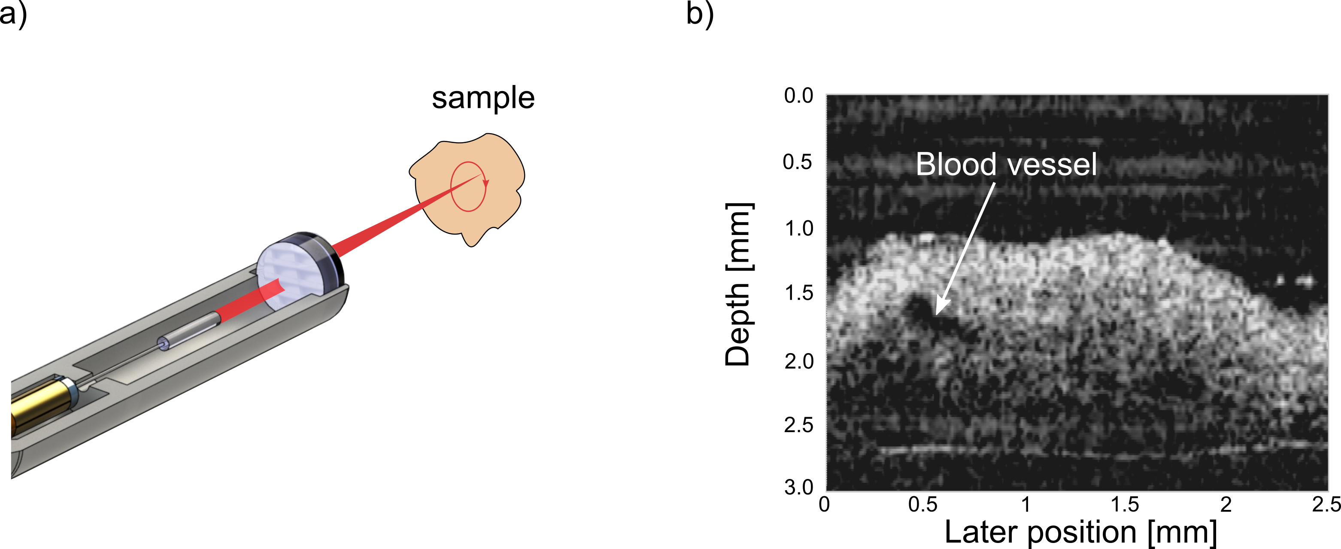
10 LaTeX/figures/50_Measurements/oct/Measurement_arrangement.png
