svilches/666_Thesis/10 LaTeX/figures/30_DesignSimulation/Overview/bimodalCrossSection.pdf

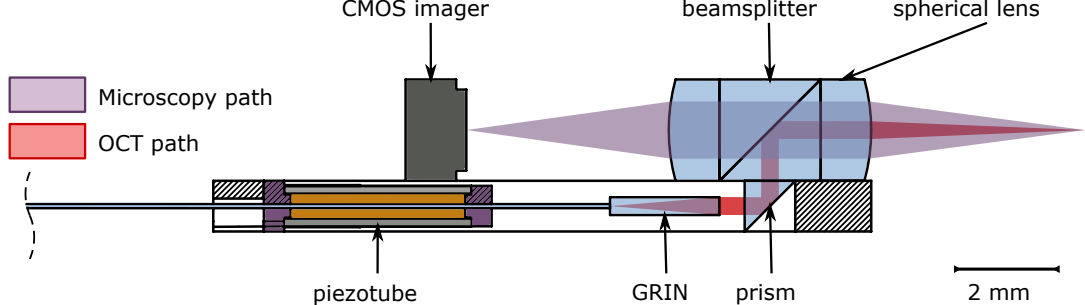
[picture p219: page 1]
CMOS imager; beamsplitter; spherical lens; piezotube; GRIN; prism; Microscopy path; OCT path
