svilches/666_Thesis/10 LaTeX/figures/20_Theory/Optical/confSetup.pdf

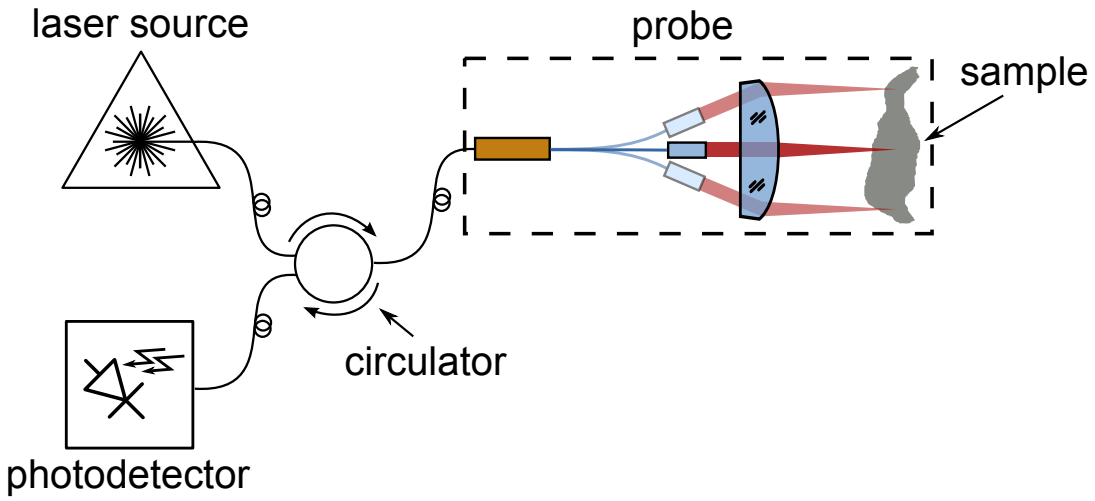
[picture p220: page 1]
probe; photodetector; laser source; circulator; sample
