svilches/666_Thesis/10 LaTeX/figures/30_DesignSimulation/Overview/crossSection.pdf

## Crosssection

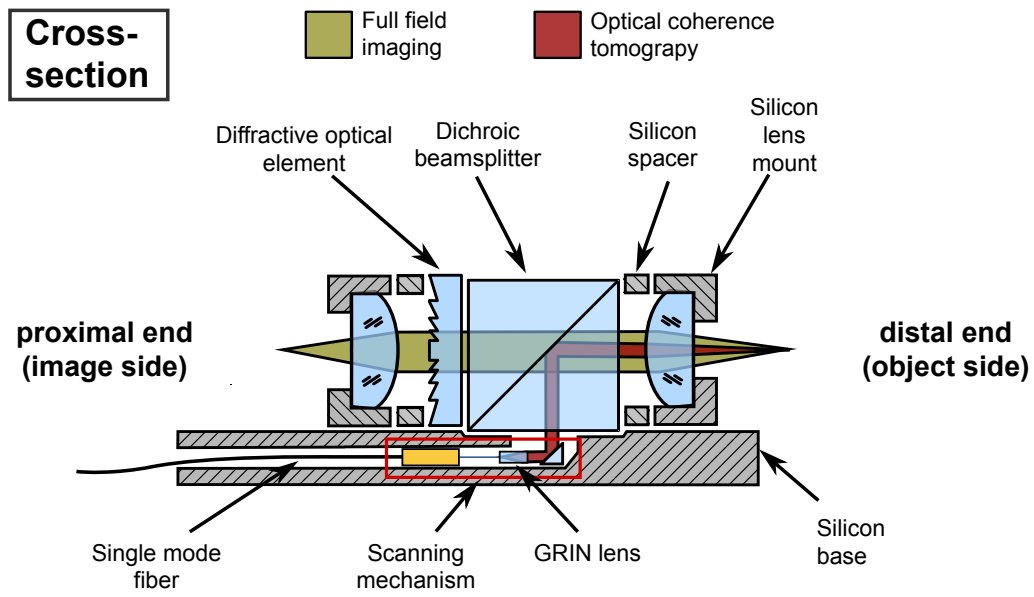
[picture p221: page 1]
Silicon spacer; Silicon lens mount; Silicon; Scanning; base; mechanism; Dichroic beamsplitter; Single mode fiber; Diffractive optical element; Full field imaging; Optical coherence tomograpy; GRIN lens; distal end (object side); proximal end (image side)
