svilches/666_Thesis/10 LaTeX/figures/30_DesignSimulation/Overview/Schematic_paper.pdf

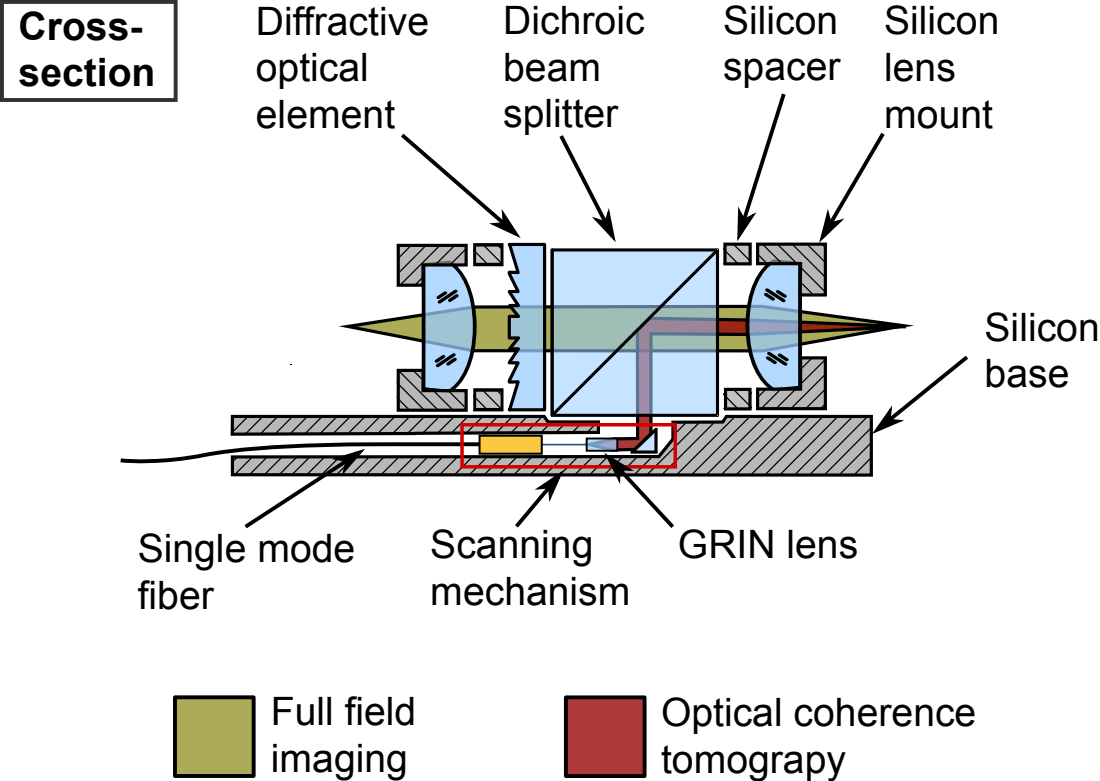
[picture p222: page 1]
Silicon spacer; Silicon lens mount; Cross- section; Silicon base; Scanning mechanism; Dichroic beam splitter; Single mode fiber; Diffractive optical element; Full field imaging; Optical coherence tomograpy; GRIN lens
