svilches/666_Thesis/10 LaTeX/figures/30_DesignSimulation/Optical/beamsplitterAll.pdf

a)

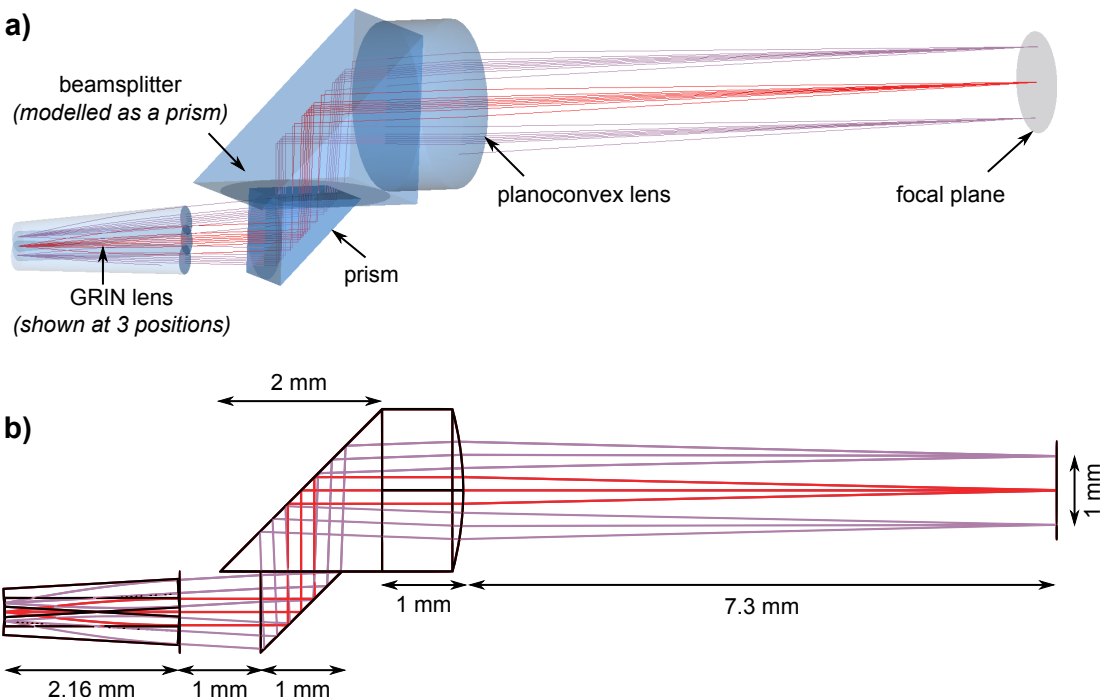
[picture p223: page 1]
prism; planoconvex lens; focal plane

beamsplitter
(modelled as a prism)

GRIN lens
(shown at 3 positions)
