svilches/666_Thesis/10 LaTeX/figures/50_Measurements/oct/octSetupVienna.pdf

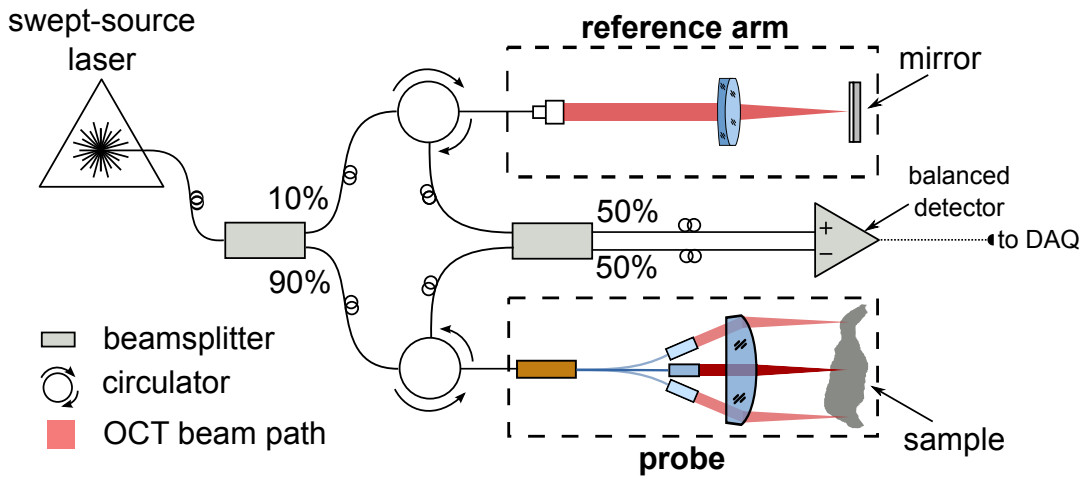
[picture p224: page 1]
reference arm; probe; swept-source laser; balanced detector to DAQ; mirror; sample

beamsplitter
circulator
OCT beam path
