svilches/666_Thesis/10 LaTeX/figures/50_Measurements/oct/octSetup.pdf

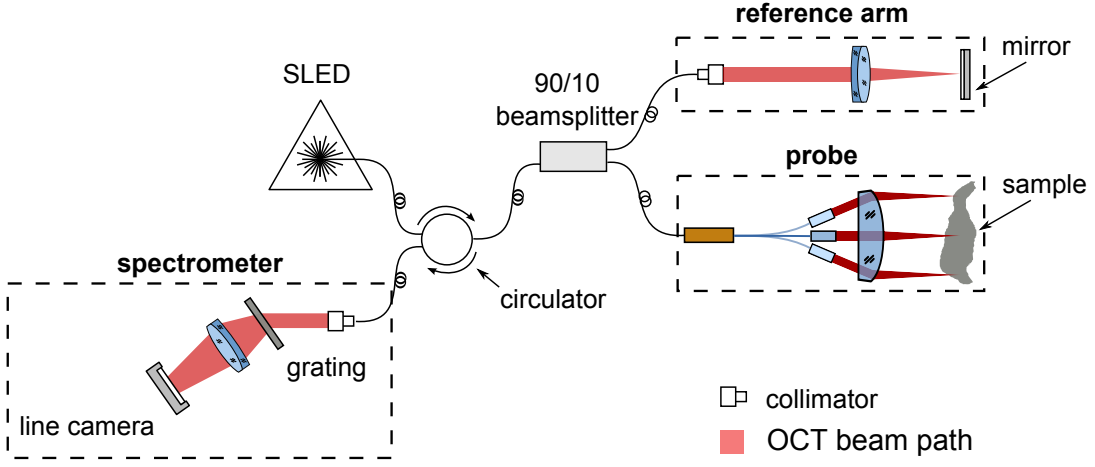
[picture p225: page 1]
reference arm; probe; spectrometer; 90/10 beamsplitter; SLED; circulator; grating; line camera; mirror; sample

collimator
OCT beam path
