svilches/666_Thesis/10 LaTeX/figures/40_Fabrication/PI/process.pdf

# | Mask | Result | X-section | Description

#1

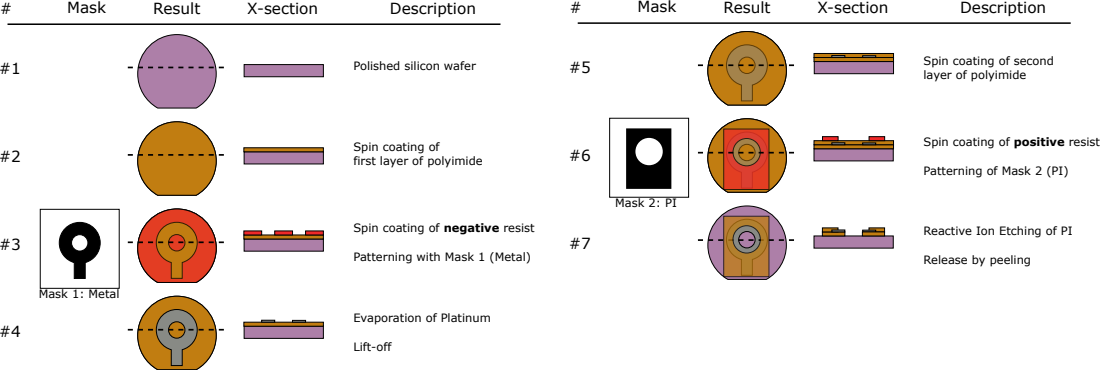
[picture p226: page 1]
Lift-off; Mask 1: Metal; Mask 2: PI; Mask; Result; X-section; Description

Polished silicon wafer

Spin coating of second
layer of polyimide

Spin coating of
first layer of polyimide

Spin coating of positive resist

Patterning of Mask 2 (PI)

Spin coating of negative resist

Reactive Ion Etching of PI

Patterning with Mask 1 (Metal)

Release by peeling

Evaporation of Platinum
