svilches/666_Thesis/10 LaTeX/figures/40_Fabrication/PI/processV.pdf

#1

#2

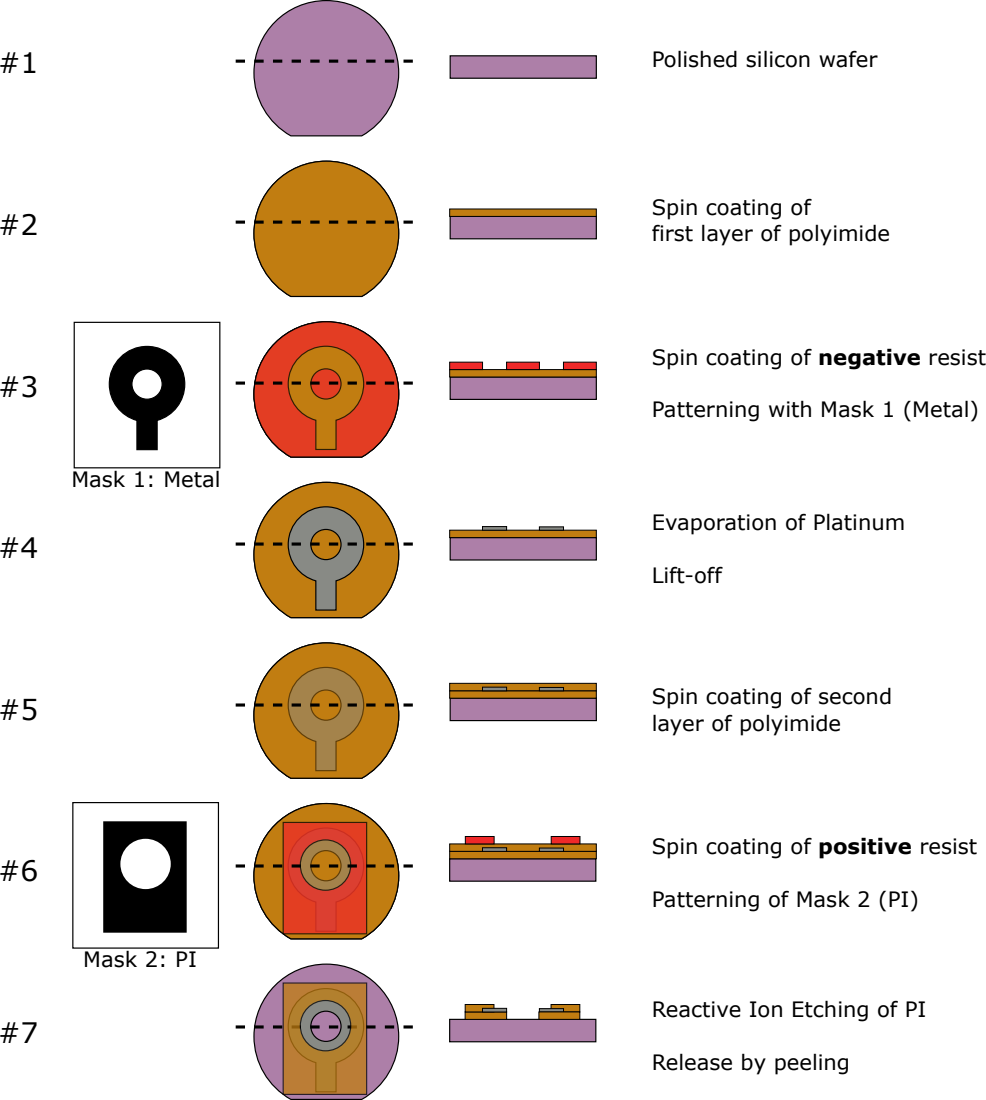
[picture p227: page 1]
Lift-off; Mask 1: Metal; Mask 2: PI

Polished silicon wafer

Spin coating of
first layer of polyimide

Spin coating of negative resist

Patterning with Mask 1 (Metal)

Evaporation of Platinum

Spin coating of second
layer of polyimide

Spin coating of positive resist

Patterning of Mask 2 (PI)

Reactive Ion Etching of PI

Release by peeling
