svilches/666_Thesis/10 LaTeX/figures/50_Measurements/conf/setup/confSetup.pdf

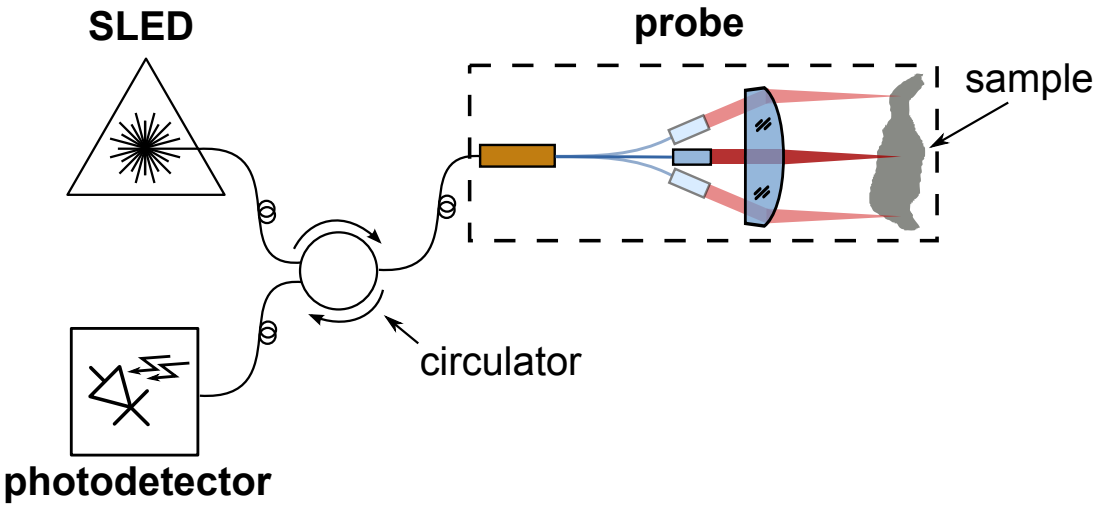
[picture p228: page 1]
probe; photodetector; SLED; circulator; sample
