svilches/666_Thesis/10 LaTeX/figures/30_DesignSimulation/Optical/MTF/MTFComparison.pdf

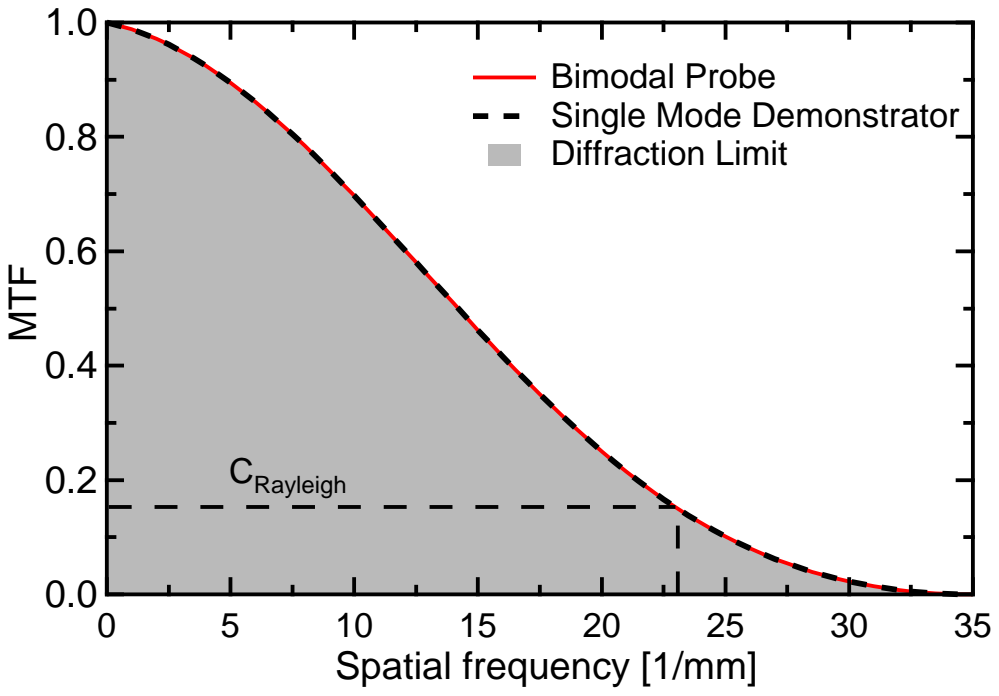
[picture p229: page 1]
MTF; CRayleigh

Bimodal Probe
Single Mode Demonstrator
Diffraction Limit

Spatial frequency [1/mm]
