svilches/666_Thesis/10 LaTeX/figures/20_Theory/Optical/fourierSignals.pdf

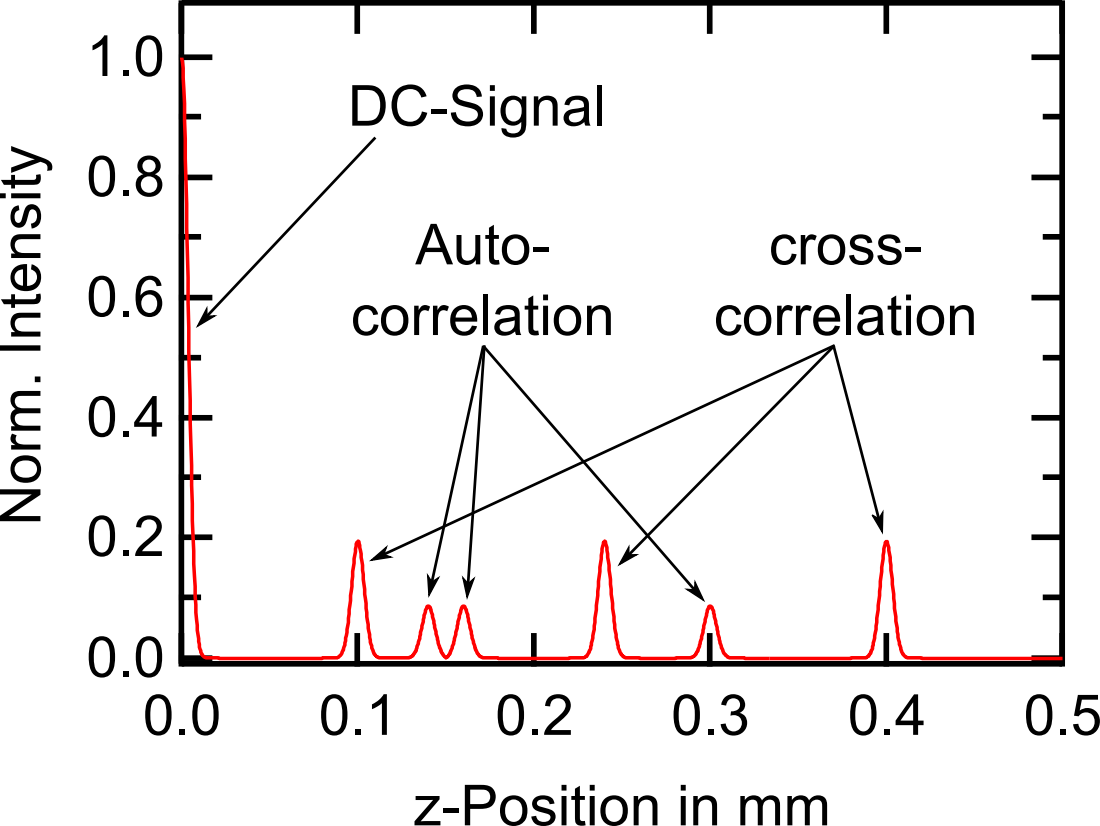
[picture p230: page 1]
Norm. Intensity; cross- correlation; Auto- correlation; DC-Signal

z-Position in mm
