svilches/666_Thesis/10 LaTeX/figures/20_Theory/Optical/microscope.pdf

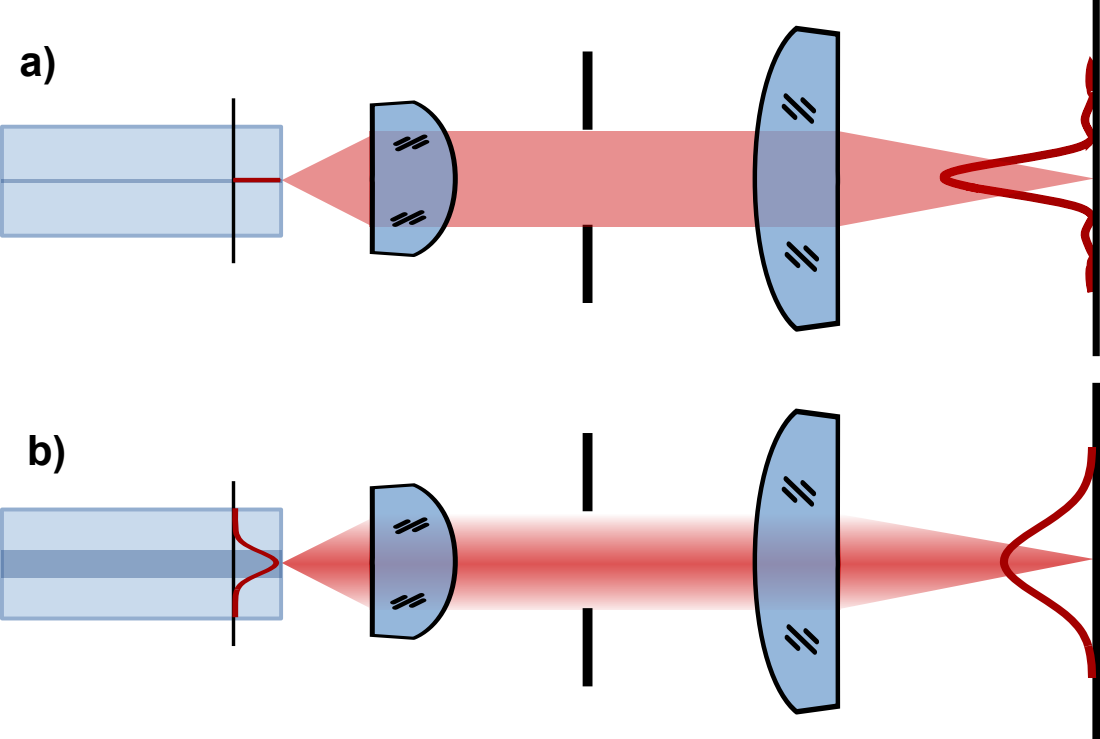
[picture p231: page 1]
