svilches/666_Thesis/10 LaTeX/figures/20_Theory/Optical/MTF.pdf

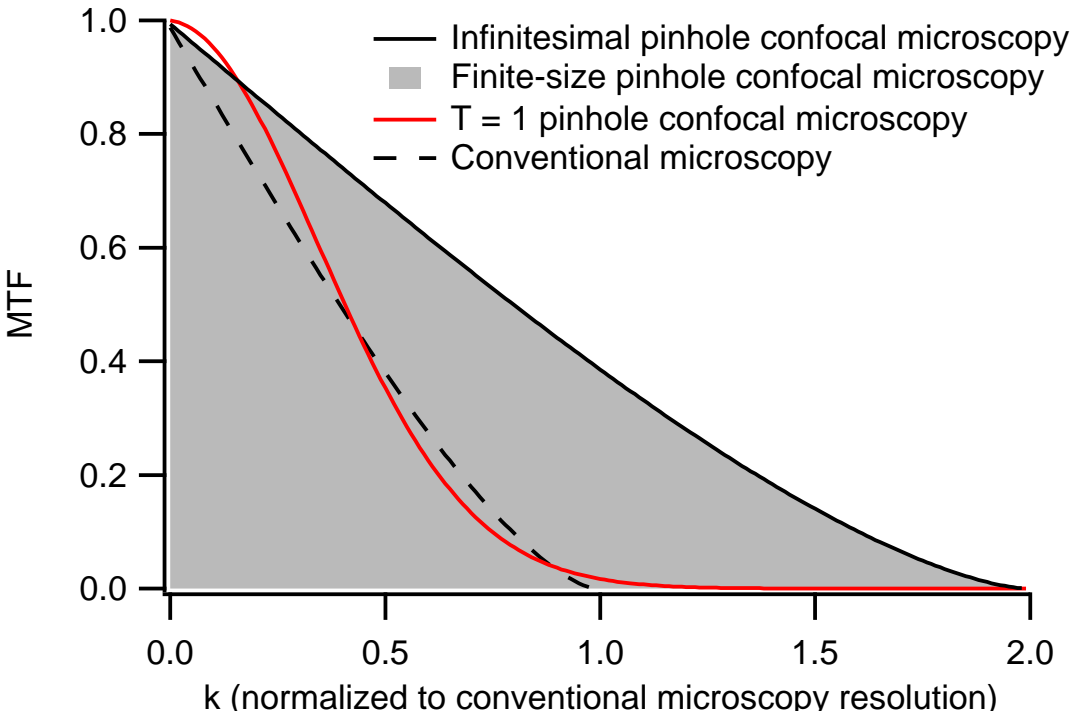
[picture p232: page 1]
MTF

Infinitesimal pinhole confocal microscopy
Finite-size pinhole confocal microscopy
T = 1 pinhole confocal microscopy
Conventional microscopy

k (normalized to conventional microscopy resolution)
