svilches/666_Thesis/10 LaTeX/figures/20_Theory/Optical/OCTspectrum.pdf

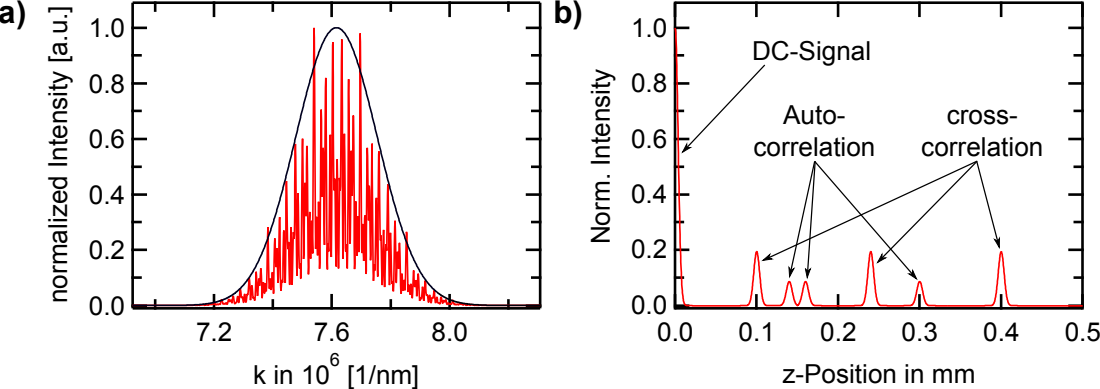
[picture p233: page 1]
normalized Intensity [a.u.]; Norm. Intensity; cross- correlation; Auto- correlation; DC-Signal

z-Position in mm
