svilches/666_Thesis/10 LaTeX/figures/50_Measurements/bode/bode.pdf

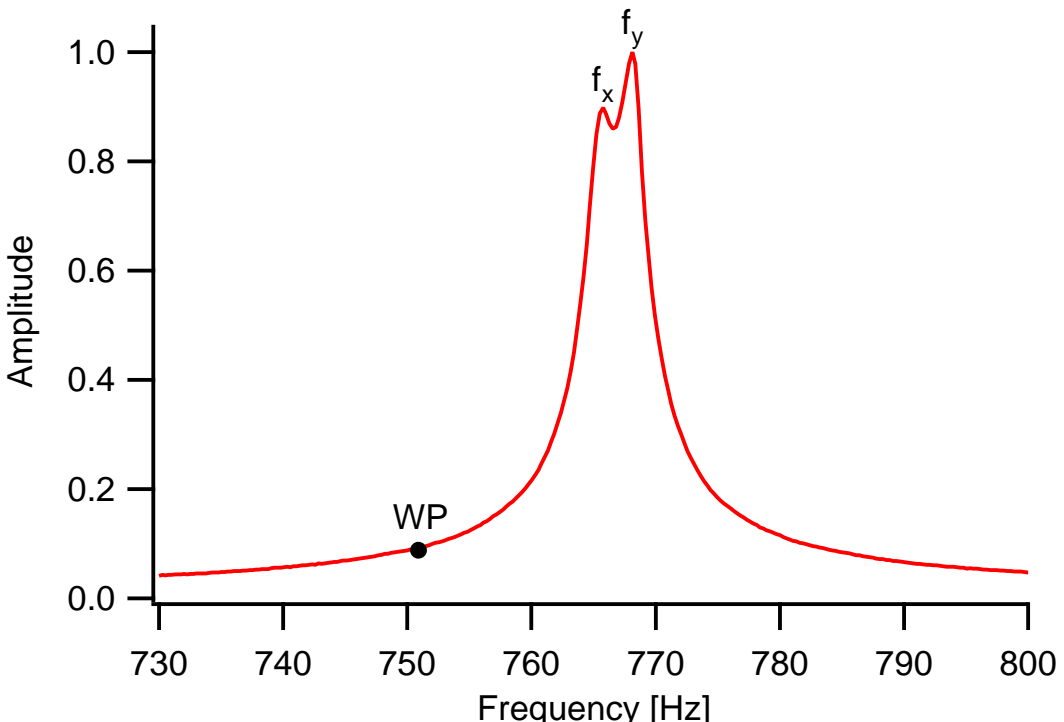
[picture p234: page 1]
Amplitude; Frequency [Hz]
