svilches/666_Thesis/10 LaTeX/figures/30_DesignSimulation/spiralScanning/PZTDriving.pdf

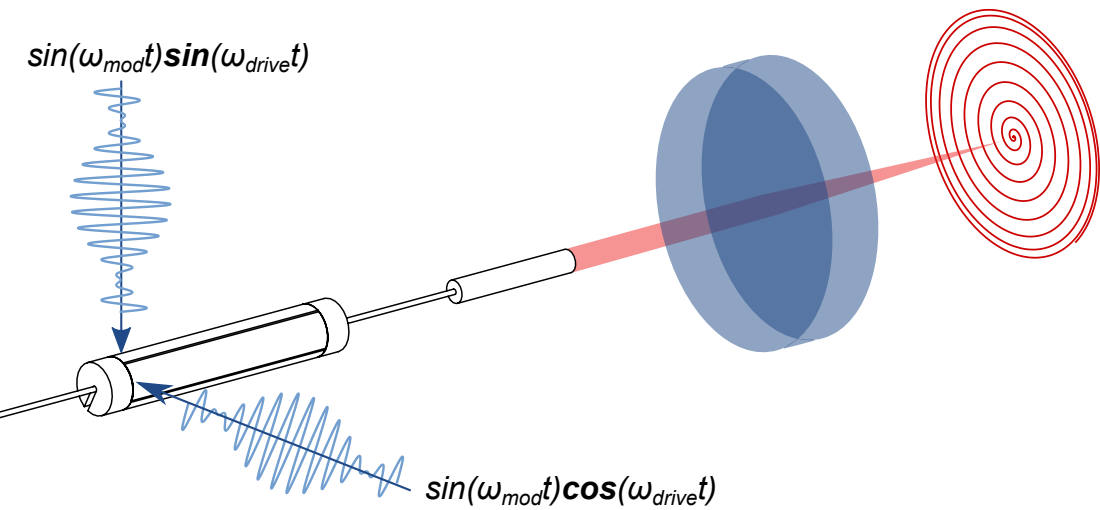
[picture p235: page 1]

sin(ωmodt)sin(ωdrivet)

sin(ωmodt)cos(ωdrivet)
