svilches/666_Thesis/10 LaTeX/figures/30_DesignSimulation/spiralScanning/spiralScanning.pdf

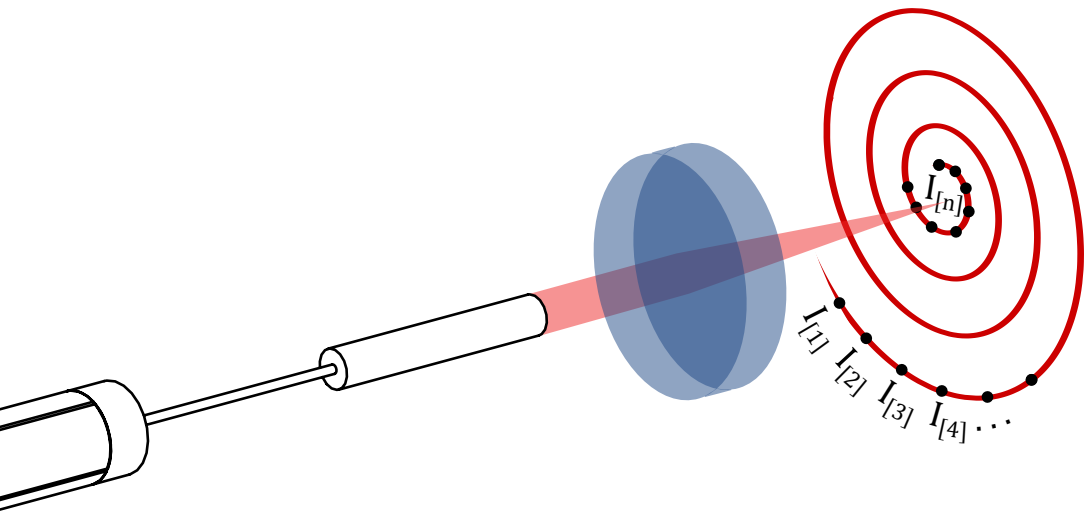
[picture p236: page 1]
