svilches/666_Thesis/10 LaTeX/figures/30_DesignSimulation/Optical/drawingMeasurements.PDF

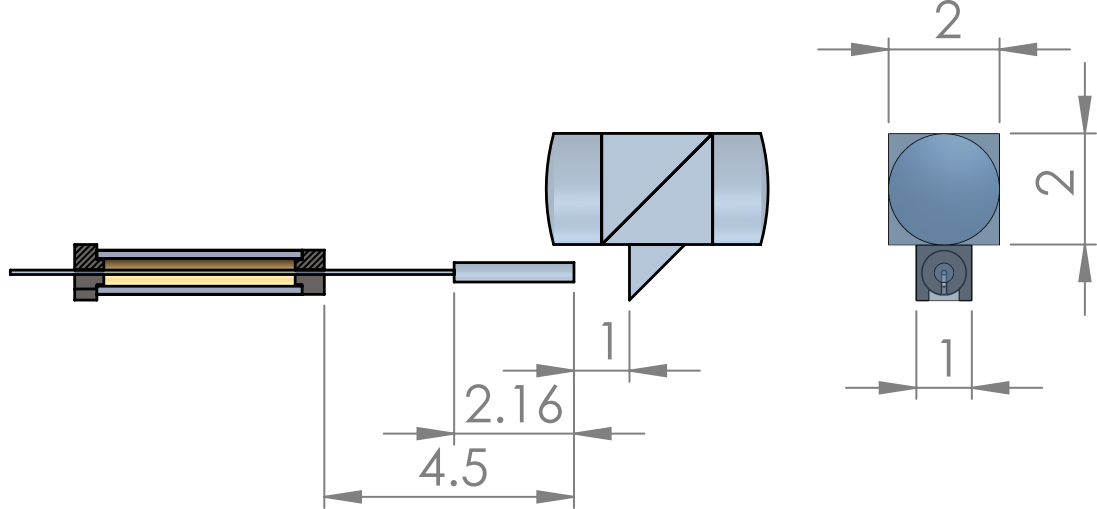
[picture p237: page 1]
