svilches/666_Thesis/10 LaTeX/figures/30_DesignSimulation/Optical/beamsplitter.pdf

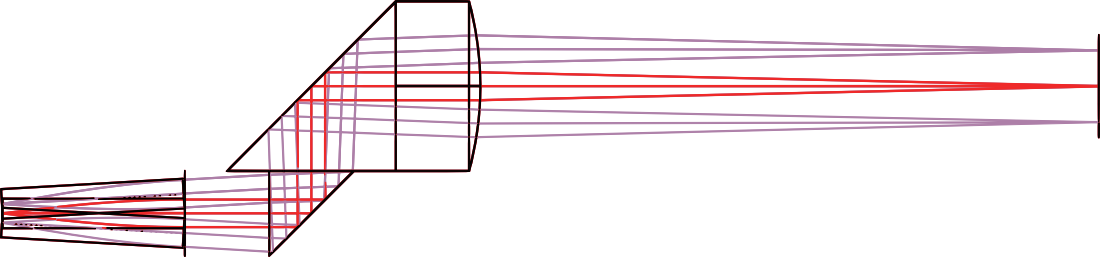
[picture p238: page 1]
