svilches/666_Thesis/10 LaTeX/figures/30_DesignSimulation/Optical/beamsplitterReport.pdf

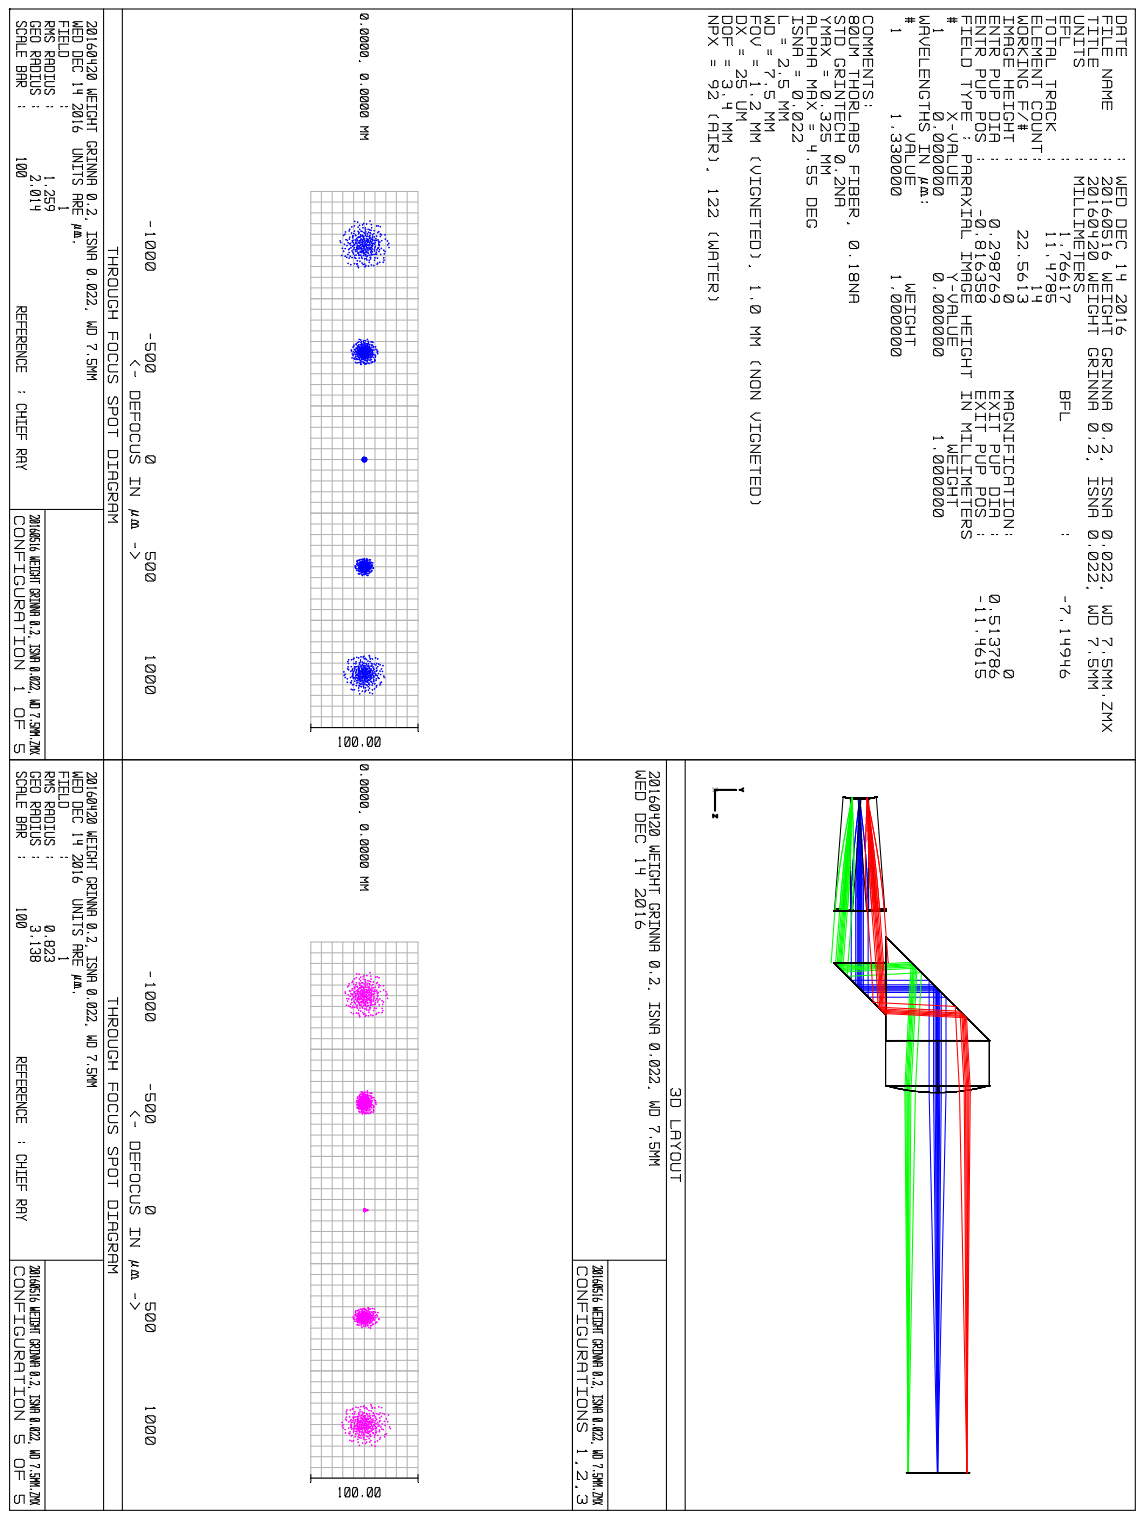
[picture p239: page 1]
