svilches/666_Thesis/10 LaTeX/figures/30_DesignSimulation/Optical/single.pdf

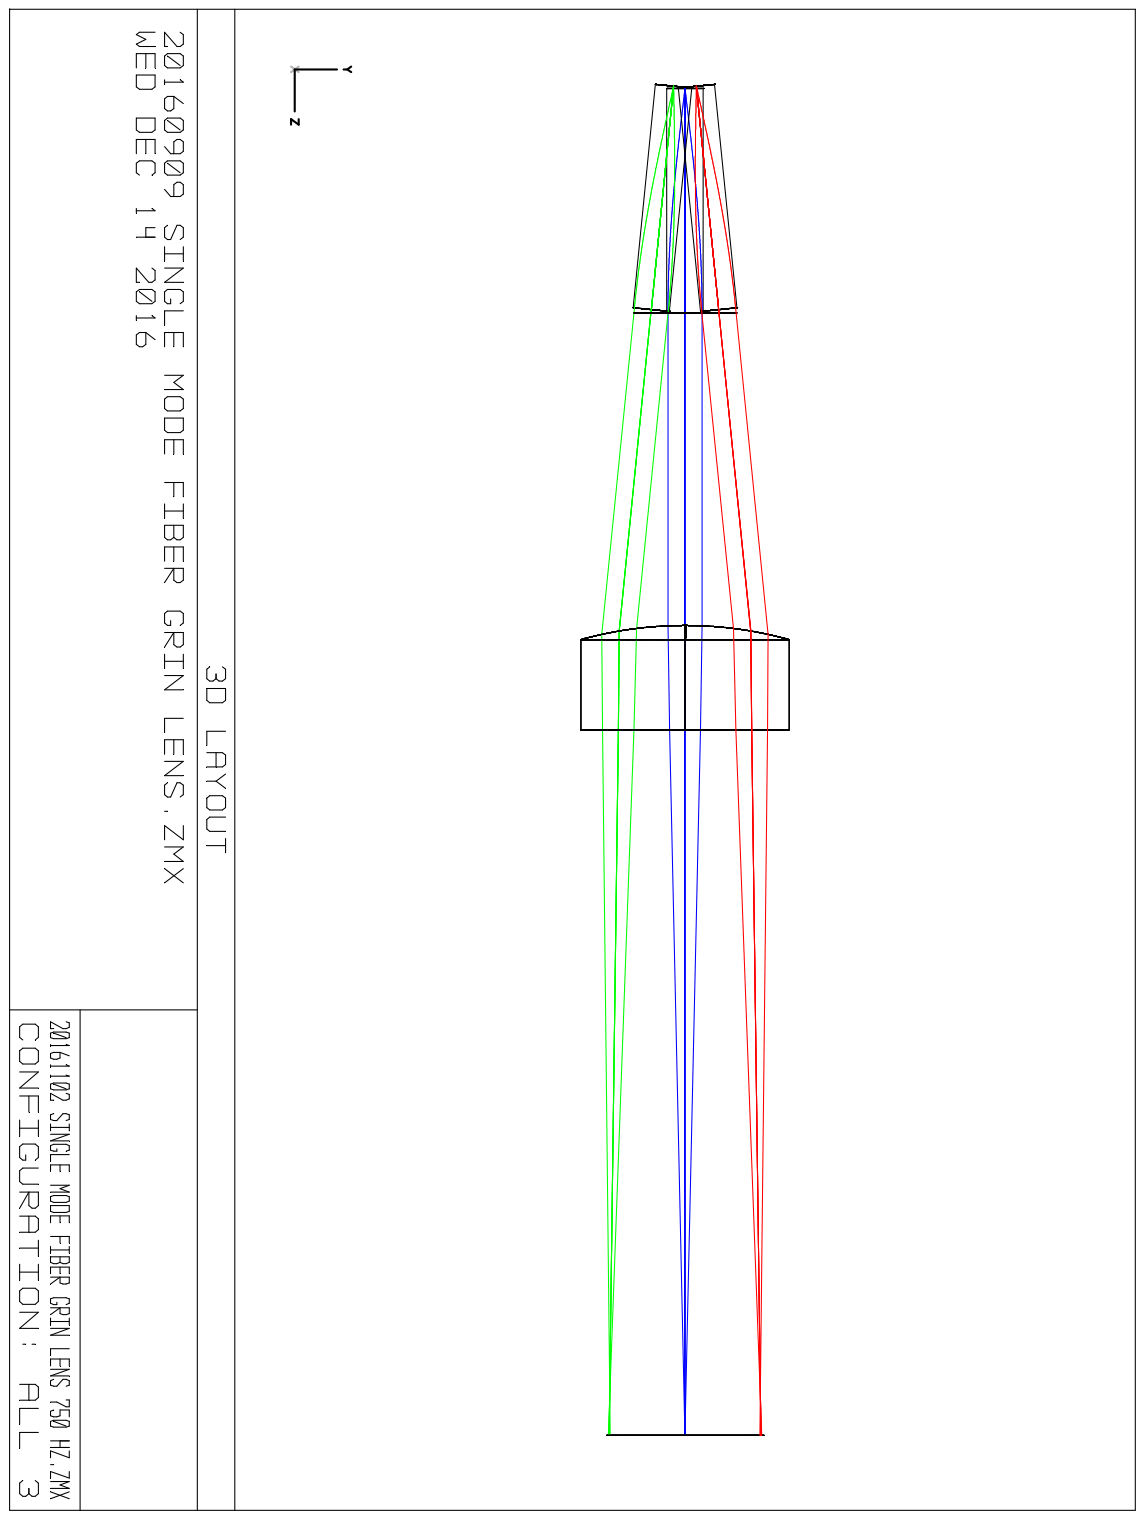
[picture p240: page 1]
