svilches/666_Thesis/10 LaTeX/figures/30_DesignSimulation/Optical/singleReport.pdf

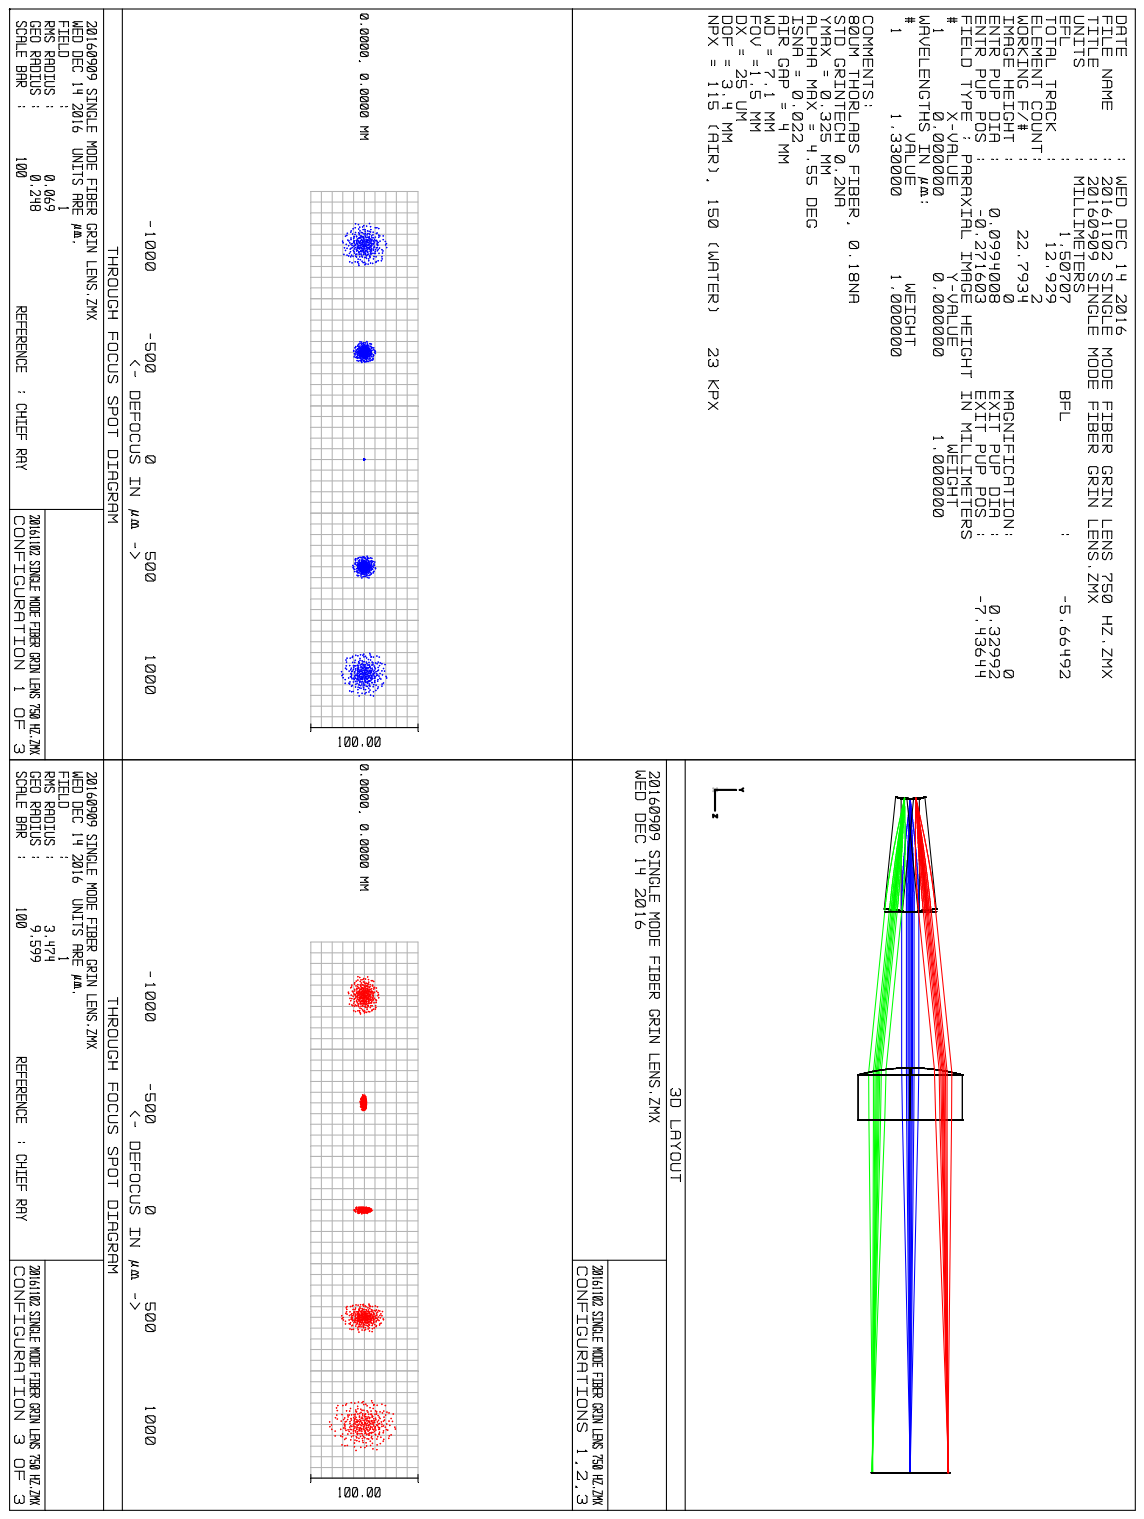
[picture p241: page 1]
