svilches/666_Thesis/10 LaTeX/figures/30_DesignSimulation/spiralScanning/cos.pdf

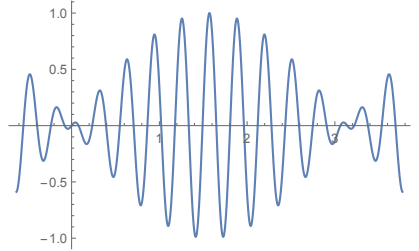
[picture p242: page 1]
