svilches/666_Thesis/10 LaTeX/figures/30_DesignSimulation/spiralScanning/iterp.pdf

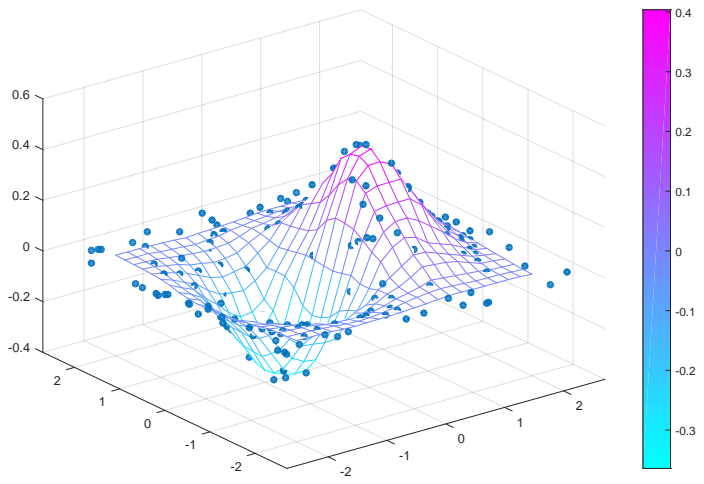
[picture p243: page 1]
