svilches/666_Thesis/10 LaTeX/figures/30_DesignSimulation/spiralScanning/signals.pdf

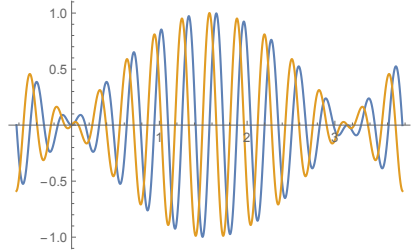
[picture p244: page 1]
