svilches/666_Thesis/10 LaTeX/figures/30_DesignSimulation/spiralScanning/sin.pdf

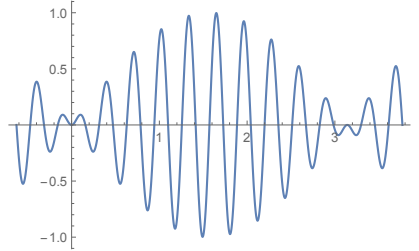
[picture p245: page 1]
