svilches/666_Thesis/10 LaTeX/figures/30_DesignSimulation/Silicon bench 2 lens cross section/20161201 Testbench Silicon Double Lens.pdf

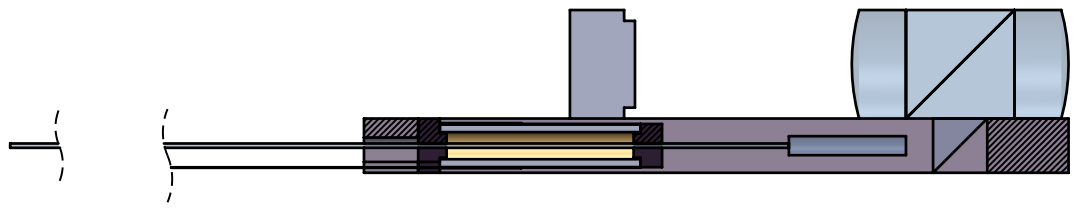
[picture p246: page 1]
