svilches/666_Thesis/10 LaTeX/figures/50_Measurements/conf/res/edge.pdf

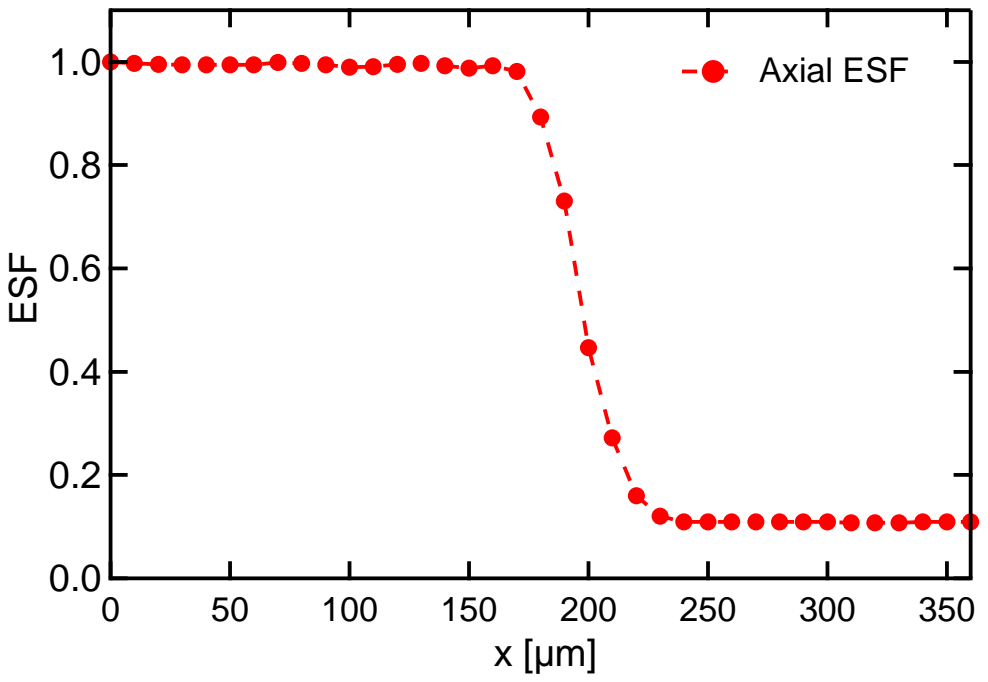
[picture p247: page 1]
ESF; Axial ESF
