svilches/666_Thesis/10 LaTeX/figures/40_Fabrication/Assy/20161006 3D Printed Housing - Alignm/TopDrawing.PDF

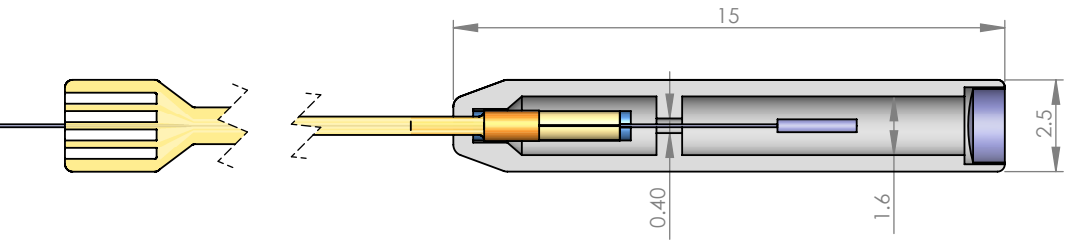
[picture p248: page 1]
