svilches/666_Thesis/10 LaTeX/figures/30_DesignSimulation/Optical/MTF/MTF_Sim.pdf

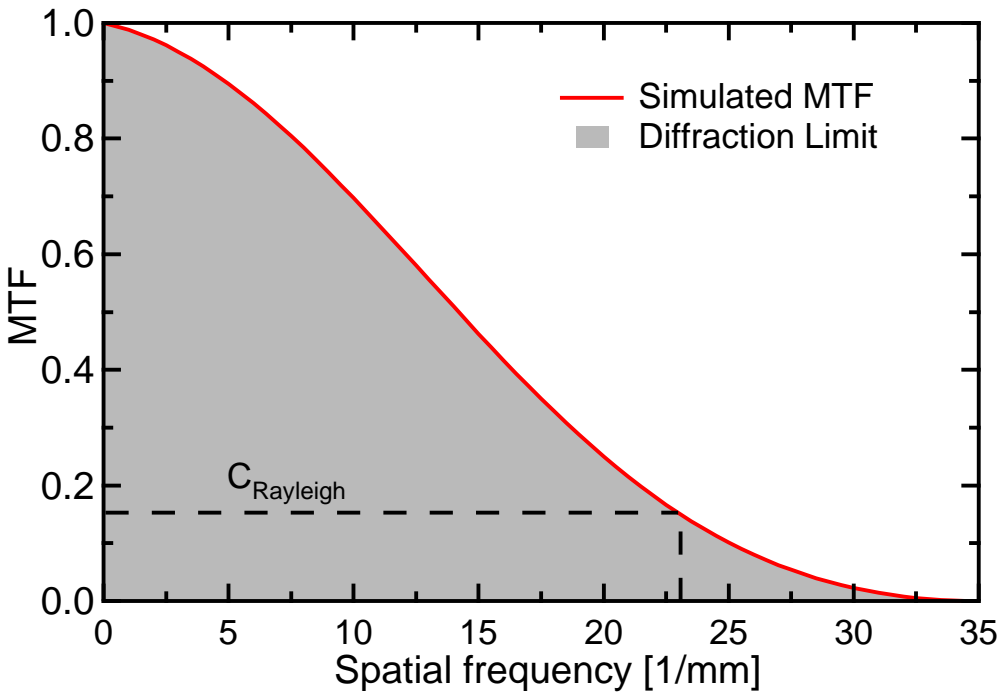
[picture p249: page 1]
MTF; Simulated MTF Diffraction Limit; CRayleigh

Spatial frequency [1/mm]
