svilches/666_Thesis/10 LaTeX/figures/30_DesignSimulation/spiralScanning/20161213 Testbench Silicon Double Lens for Thesis/20161213 PZT Fiber GRIN 2.PDF

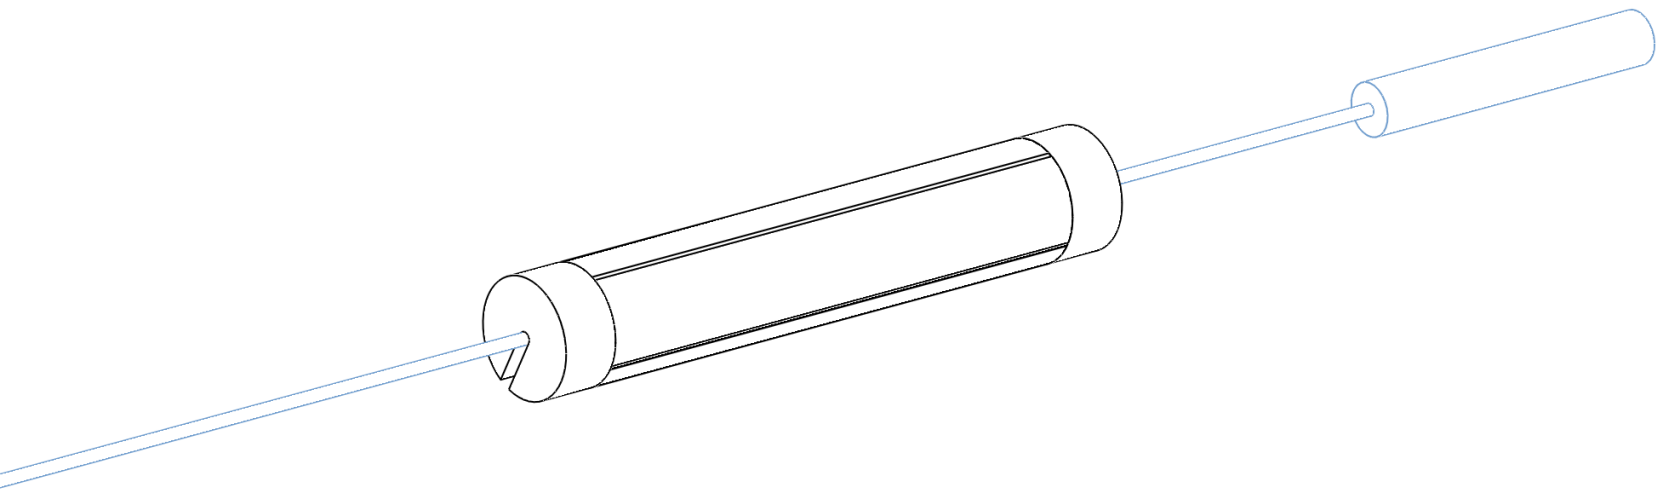
[picture p250: page 1]
