svilches/666_Thesis/10 LaTeX/figures/30_DesignSimulation/spiralScanning/20161213 Testbench Silicon Double Lens for Thesis/20161213 PZT Fiber GRIN.PDF

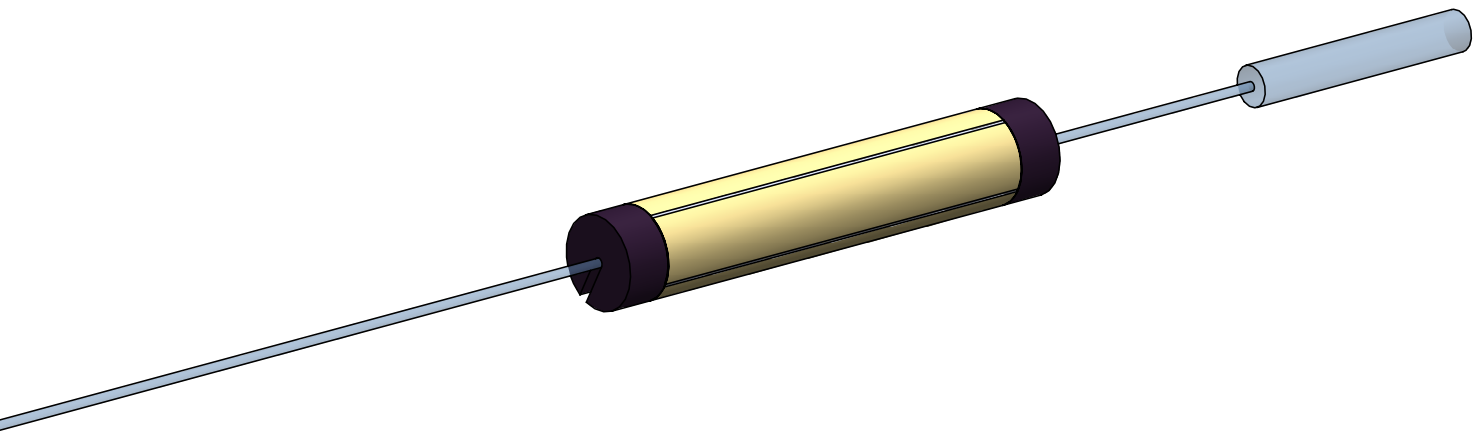
[picture p251: page 1]
