svilches/666_Thesis/10 LaTeX/appendix/pcb.pdf

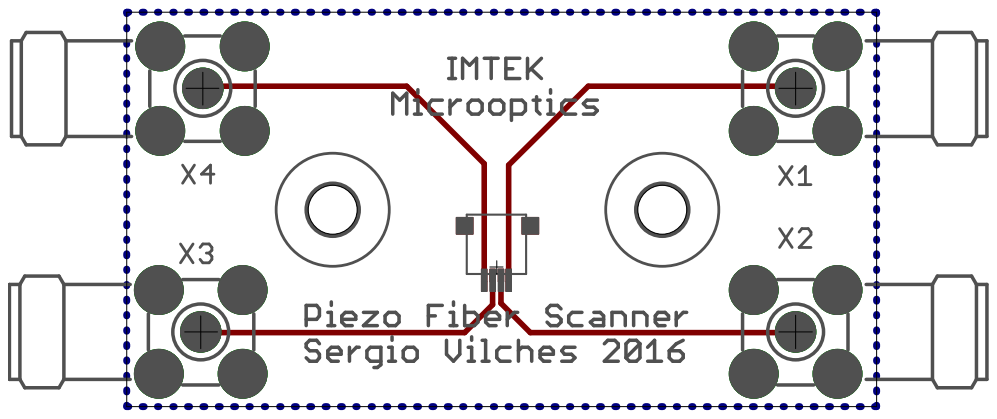
[picture p252: page 1]
