svilches/666_Thesis/(commit log)

2016-12-08 First update
    [20160422 80um Fiber.SLDPRT, 20160422 Detailed Cuff.sldprt, 20160422 GRIN GT-LFRL-035-025-20-CC (1550) .SLDPRT, 20160531 Beamsplitter.SLDPRT, 20160531 Bench.SLDPRT, 20160531 Lens.SLDPRT, 20160531 Prism.SLDPRT, 20160615 Electrode.SLDASM]
2016-12-14 Figures for ZEMAX and spiral scanning
    [20160422 Detailed Cuff.sldprt, 20160516 WEIGHT GRINNA 0.2, ISNA 0.022, WD 7.5MM.CFG, 20160531 Beamsplitter.SLDPRT, 20160531 Bench.SLDPRT, 20160531 Lens.SLDPRT, 20160531 Prism.SLDPRT, 20160615 Electrode.SLDASM, 20160722 Lens Prism BS Lens.SLDASM]
2016-12-27 Cloned to laptop
    [20160516 WEIGHT GRINNA 0.2, ISNA 0.022, WD 7.5MM.CFG]
2017-01-04 Drafted whole Design chapter
    [Vsweep.xlsx]
2017-01-13 Continuing Design review
    [20160422 Detailed Cuff.sldprt, 20160516 WEIGHT GRINNA 0.2, ISNA 0.022, WD 7.5MM.CFG, 20160531 Beamsplitter.SLDPRT, 20160531 Bench.SLDPRT, 20160531 Lens.SLDPRT, 20160531 Prism.SLDPRT, 20160615 Electrode.SLDASM, 20160722 Lens Prism BS Lens.SLDASM]
2017-01-20 Added Spiral to Design. Design+Fab ready for review
    [160406 PZT Tube 500_800um.SLDPRT, 20160422 80um Fiber.SLDPRT, 20160422 Detailed Cuff.sldprt, 20160422 GRIN GT-LFRL-035-025-20-CC (1550) .SLDPRT, 20160531 Beamsplitter.SLDPRT, 20160531 Bench.SLDPRT, 20160531 Lens.SLDPRT, 20160531 Prism.SLDPRT]
2017-01-20 Started Results chapter
    [eqnMTF.csv]
2017-01-25 Reviewed Design and Implementation, drafted Results
    [20160615 Electrode.SLDASM]
2017-01-27 Finished Measurements. Printed for review
2017-02-18 Finished writing Theory:Optic
    [MTFexp.csv, MTFfullconf.csv]
2017-02-24 Done!!! :)
    Printed Version
2017-02-28 Corrected from test presentation
    [20160422 80um Fiber.SLDPRT, 20160422 GRIN GT-LFRL-035-025-20-CC (1550) .SLDPRT, 20160531 Bench.SLDPRT, 20160531 Lens.SLDPRT, 20160615 Electrode.SLDASM, 20161006 3D Printed Housing Top Alignm.SLDPRT, 20161006 PZT Scanner Fiber GRIN.SLDASM, 20161201 Testbench Silicon Double Lens Jack.SLDASM]
2017-03-21 Written everything but the conclusion
    [comparisonSeibel.xlsx]
2017-03-27 Corrected from Simon comments
    [20160513 Roll Electrode Metal.SLDPRT, 20160513 Roll Electrode.SLDPRT, 20160531 PZT Tube Assemblying Tool.SLDASM, 20160531 Silicon Holder Base.SLDPRT, 20160722 Silicon Holder Tip Round.SLDPRT, comparisonSeibel.xlsx]
2017-03-31 Added Caglar+my corrections
    [20160513 Roll Electrode Metal.SLDPRT, 20160513 Roll Electrode.SLDPRT, 20160615 Electrode.SLDASM]
